OLIMEX/KiCAD/README.md

# KiCAD

Olimex KiCAD components and footprints.

Why these components and footprints are not pushed to the main KiCAD repository? 

Because they are very specific to the technology and assembly process that we use and can't be considered universal and suitable for everyone.

In most of the cases these are duplicate components and packages with those in the standard KiCAD library, plus small edits to fit our goals.

Our component libraries just work fine for our process and are continually updated. These libraries are not static, each time we find new way to optimize our production process for better yield we update the libraries. These libraries are our current libraries that we use when we design our products.

Are there no 3D drawings for the components?

We started adding such, you can find some of those in "OLIMEX_3Dmodels" folder. Notice that we are not very good at mechanics and never found good use of these nice 3D generated objects with KiCAD, so if someone would like to contribute 3D drawings for these components is welcome :)

# NO WARRANTY

THEESE COMPONENT DEFINITIONS AND FOOTPRINTS ARE DISTRIBUTED IN THE HOPE THAT THEY WILL BE USEFUL, BUT WITHOUT ANY WARRANTY. 

THEY ARE PROVIDED "AS IS" WITHOUT WARRANTY OF ANY KIND, EITHER EXPRESSED OR IMPLIED, INCLUDING, BUT NOT LIMITED TO, THE IMPLIED WARRANTIES OF MERCHANTABILITY AND FITNESS FOR A PARTICULAR PURPOSE.

THE ENTIRE RISK AS TO THE QUALITY AND PERFORMANCE OF THE COMPONENTS DEFINITIONS AND FOOTPRINTS IS WITH YOU.

IN NO EVENT OLIMEX WILL BE LIABLE TO YOU FOR DAMAGES, LOSSES, INCLUDING ANY GENERAL, SPECIAL, INCIDENTAL OR CONSEQUENTIAL DAMAGES ARISING OUT OF THE USE OR INABILITY TO USE THESE COMPONENTS DEFINITIONS AND FOOTPRINTS.
