OLIMEX/KiCAD/KiCAD_Footprints/OLIMEX_3Dmodels/B0505S-1W.step

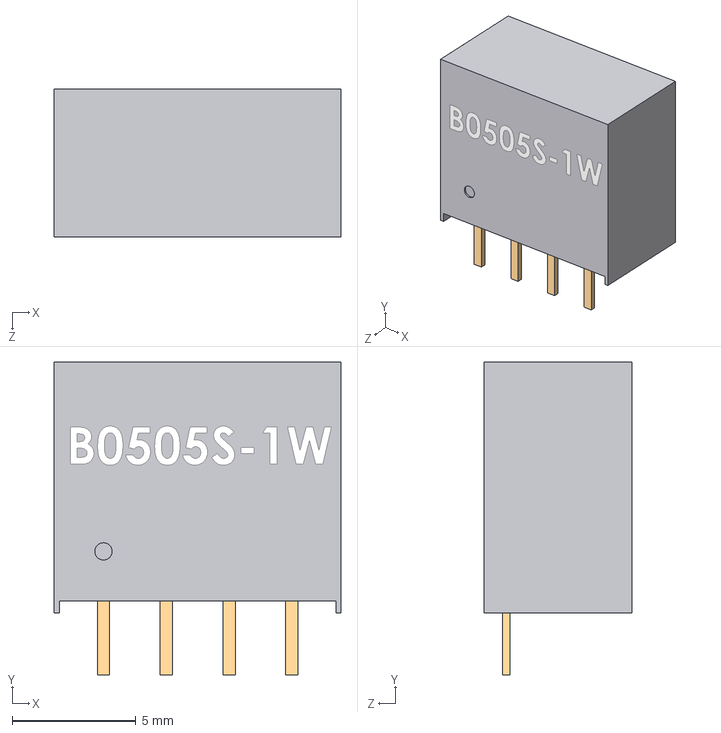
[picture p1: CAD file, 2026-10-12]
KiCAD_Footprints/OLIMEX_3Dmodels/B0505S-1W.step
11.6 x 12.7 x 6.00 mm
