OLIMEX/KiCAD/KiCAD_Footprints/OLIMEX_3Dmodels/TSSOP-10_Body-3x3mm_Pitch-0.5mm.step

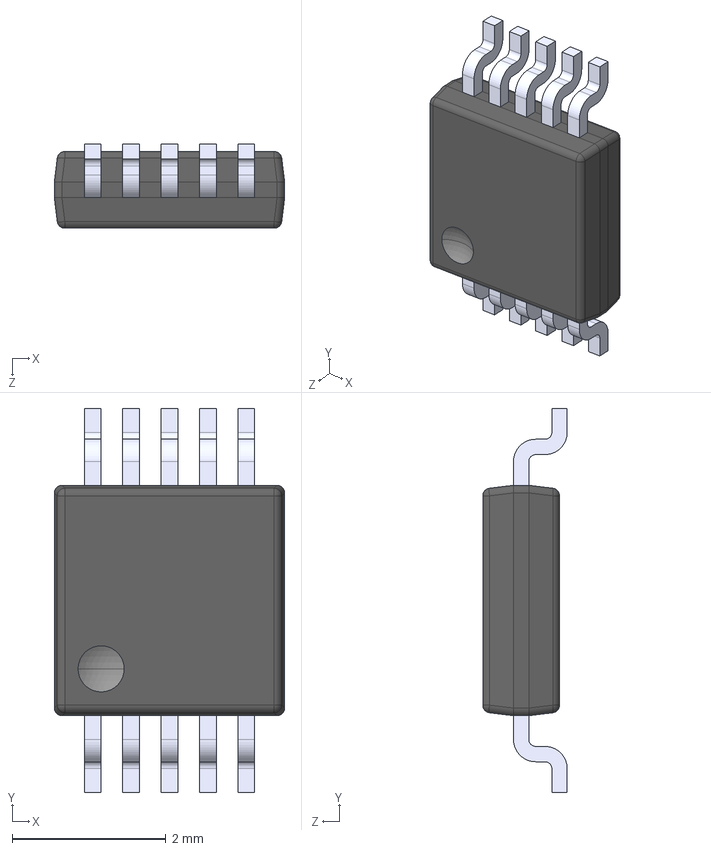
[picture p2: CAD file, 2026-10-12]
KiCAD_Footprints/OLIMEX_3Dmodels/TSSOP-10_Body-3x3mm_Pitch-0.5mm.step
3.00 x 5.00 x 1.10 mm
