OLIMEX/KiCAD/KiCAD_Footprints/OLIMEX_3Dmodels/YSRH8D43---sru1038-330y.step

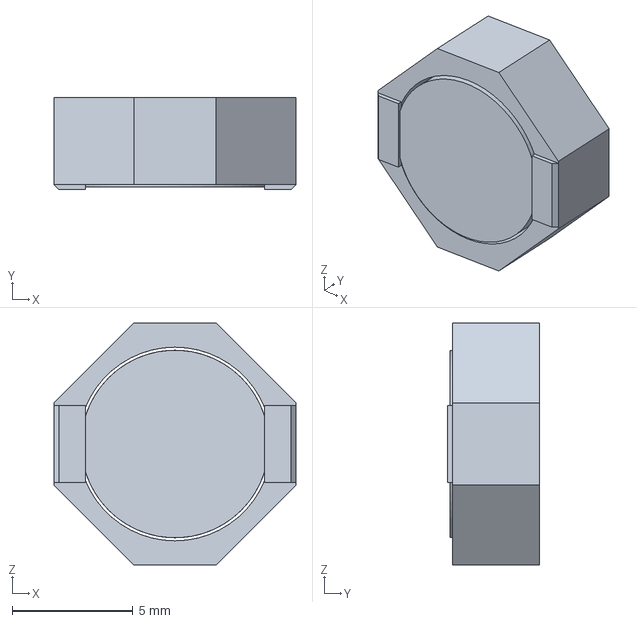
[picture p3: CAD file, 2026-10-12]
KiCAD_Footprints/OLIMEX_3Dmodels/YSRH8D43---sru1038-330y.step
10.0 x 3.80 x 10.0 mm
