OLIMEX/KiCAD/KiCAD_Footprints/OLIMEX_3Dmodels/ITR8307_TR8.STEP

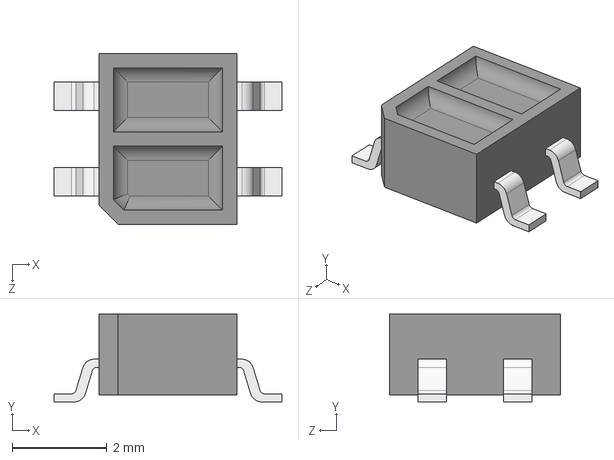
[picture p4: CAD file, 2026-10-12]
KiCAD_Footprints/OLIMEX_3Dmodels/ITR8307_TR8.STEP
4.80 x 1.85 x 3.60 mm
