OLIMEX/KiCAD/KiCAD_Footprints/OLIMEX_3Dmodels/MF-R065_CMF-RL50-0.step

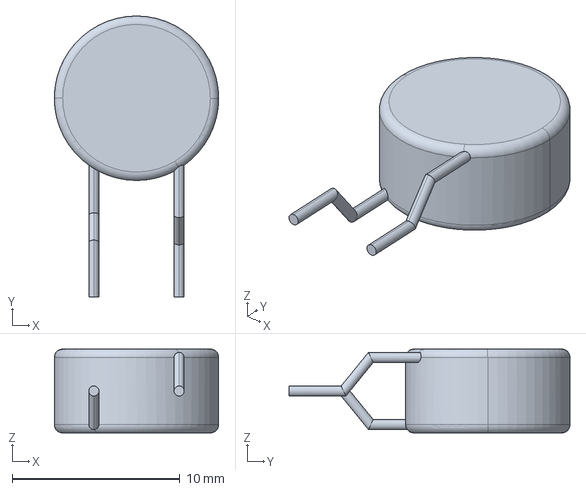
[picture p5: CAD file, 2026-10-12]
KiCAD_Footprints/OLIMEX_3Dmodels/MF-R065_CMF-RL50-0.step
9.80 x 16.7 x 5.00 mm
