OLIMEX/KiCAD/KiCAD_Footprints/OLIMEX_3Dmodels/RJ-055-1.STEP

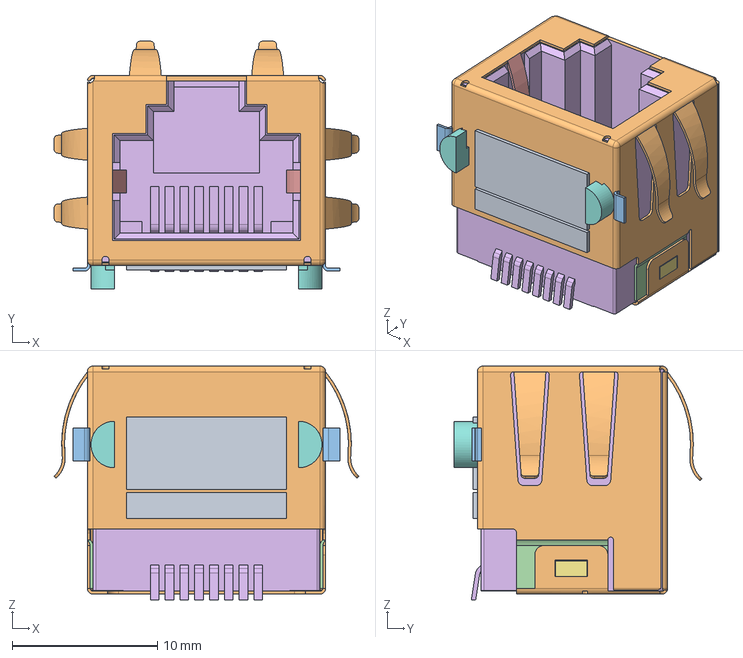
[picture p6: CAD file, 2026-10-12]
KiCAD_Footprints/OLIMEX_3Dmodels/RJ-055-1.STEP
21.0 x 17.1 x 16.1 mm
