OLIMEX/KiCAD/KiCAD_Footprints/OLIMEX_3Dmodels/DFN_3_3x3_3_8_leads.step

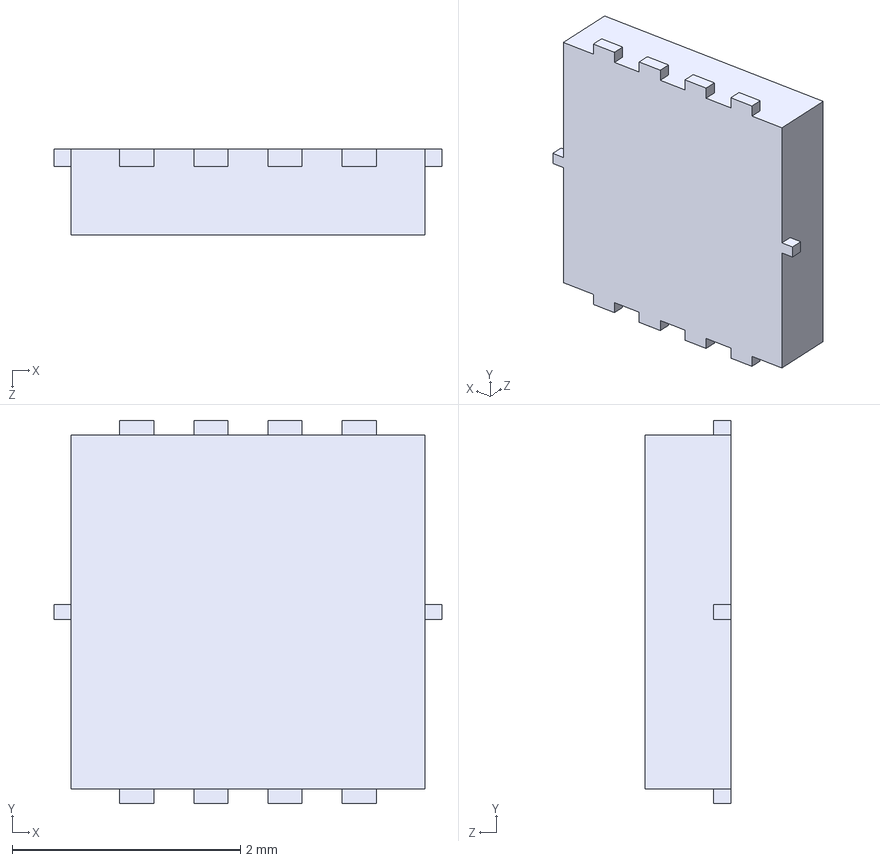
[picture p7: CAD file, 2026-10-12]
KiCAD_Footprints/OLIMEX_3Dmodels/DFN_3_3x3_3_8_leads.step
3.40 x 3.36 x 0.75 mm
