OLIMEX/KiCAD/KiCAD_Footprints/OLIMEX_3Dmodels/SATA-7B-84VSSERIES.step

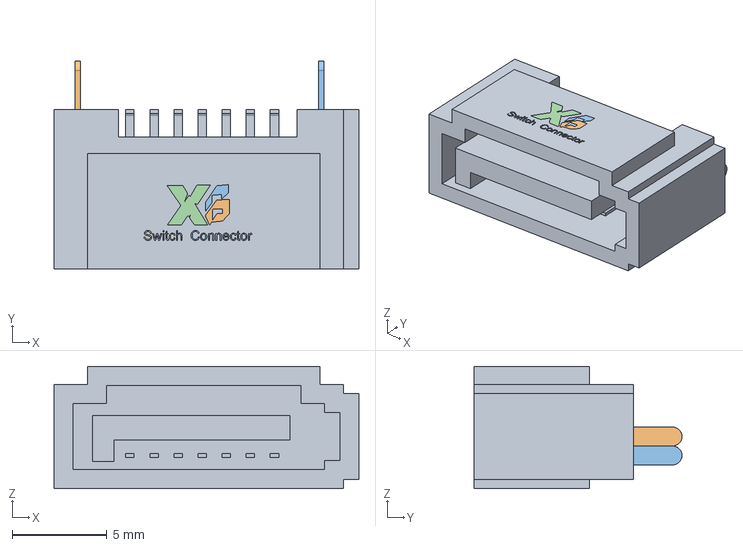
[picture p8: CAD file, 2026-10-12]
KiCAD_Footprints/OLIMEX_3Dmodels/SATA-7B-84VSSERIES.step
16.1 x 11.0 x 6.45 mm
