OLIMEX/KiCAD/KiCAD_Footprints/OLIMEX_3Dmodels/Quectel_EG800K_Series_3D_Dimensions_V1.1.step

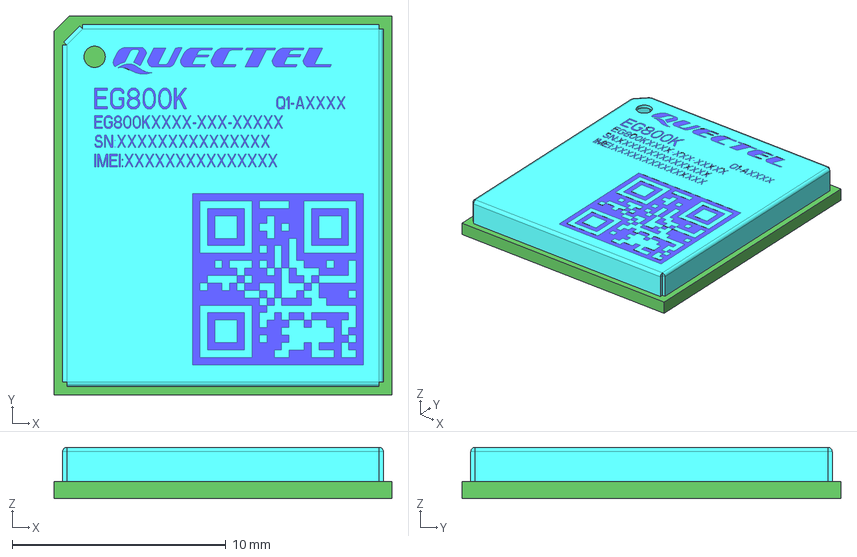
[picture p9: CAD file, 2026-10-12]
KiCAD_Footprints/OLIMEX_3Dmodels/Quectel_EG800K_Series_3D_Dimensions_V1.1.step
15.8 x 17.7 x 2.40 mm
EG800K_PCB
QT0024001848
