OLIMEX/KiCAD/KiCAD_Footprints/OLIMEX_3Dmodels/SOT33-5.step

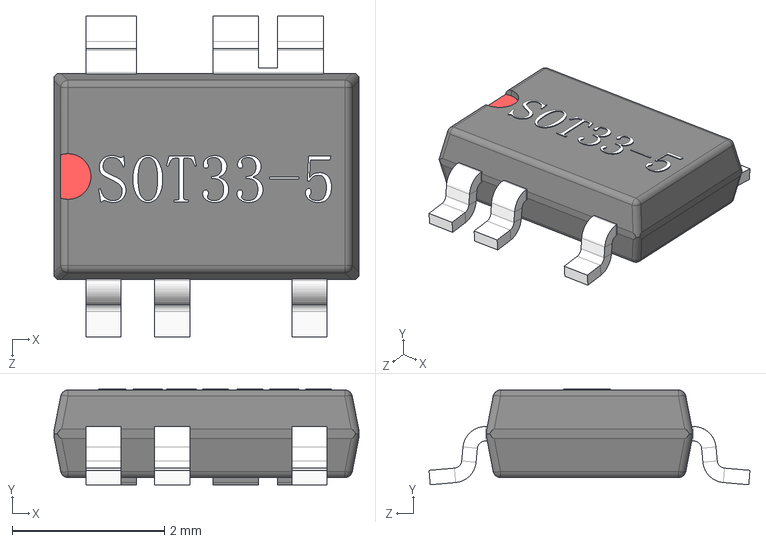
[picture p10: CAD file, 2026-10-12]
KiCAD_Footprints/OLIMEX_3Dmodels/SOT33-5.step
4.00 x 1.25 x 4.22 mm
