OLIMEX/KiCAD/KiCAD_Footprints/OLIMEX_3Dmodels/CARBON FILM RESISTOR.STEP

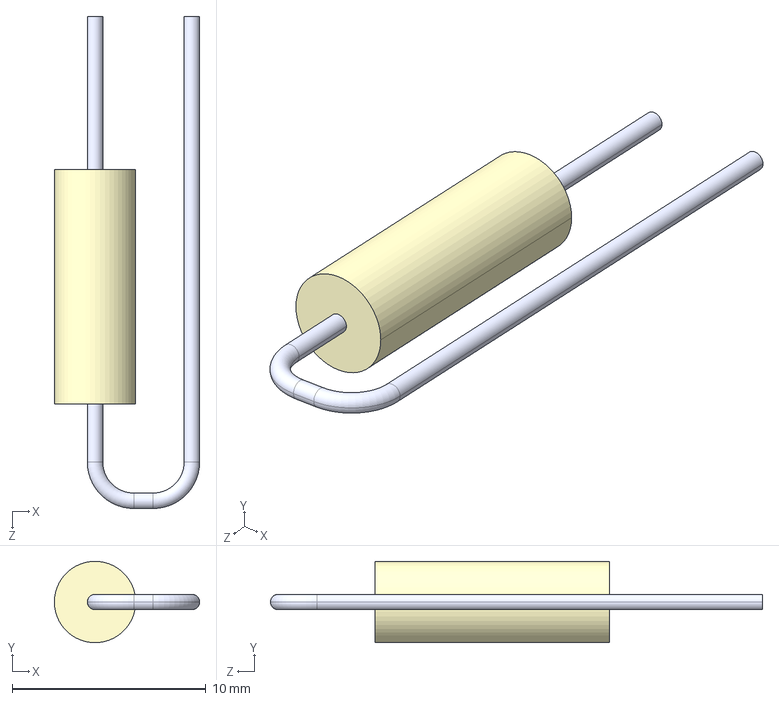
[picture p11: CAD file, 2026-10-12]
KiCAD_Footprints/OLIMEX_3Dmodels/CARBON FILM RESISTOR.STEP
7.50 x 4.20 x 25.4 mm
