OLIMEX/KiCAD/KiCAD_Footprints/OLIMEX_3Dmodels/ESP32-MINI-1-N4.step

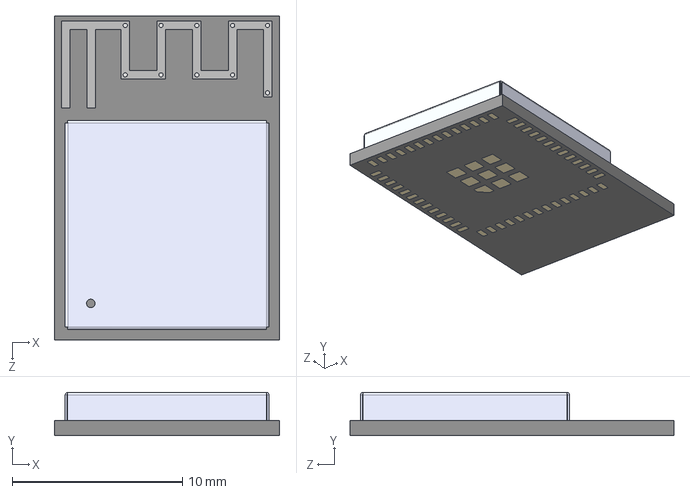
[picture p12: CAD file, 2026-10-12]
KiCAD_Footprints/OLIMEX_3Dmodels/ESP32-MINI-1-N4.step
13.2 x 2.55 x 19.0 mm
