OLIMEX/KiCAD/KiCAD_Footprints/OLIMEX_3Dmodels/B0505S-2WR2.STEP

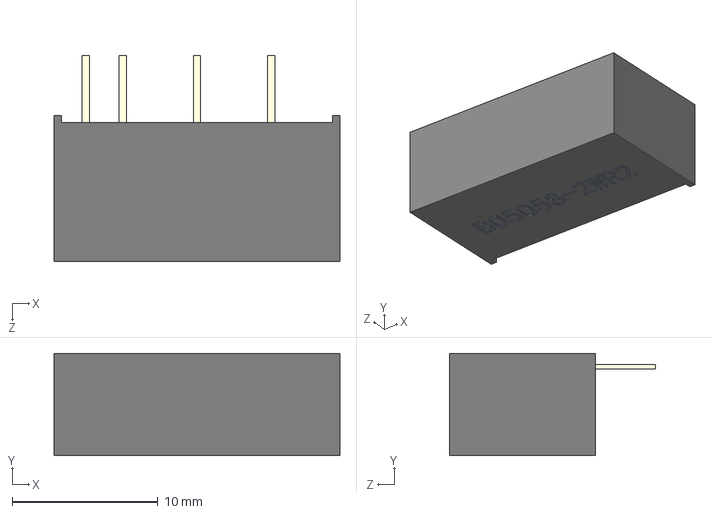
[picture p13: CAD file, 2026-10-12]
KiCAD_Footprints/OLIMEX_3Dmodels/B0505S-2WR2.STEP
19.6 x 7.00 x 14.1 mm
