OLIMEX/KiCAD/KiCAD_Footprints/OLIMEX_3Dmodels/MPM3833CGRH-Z(QFN-18).step

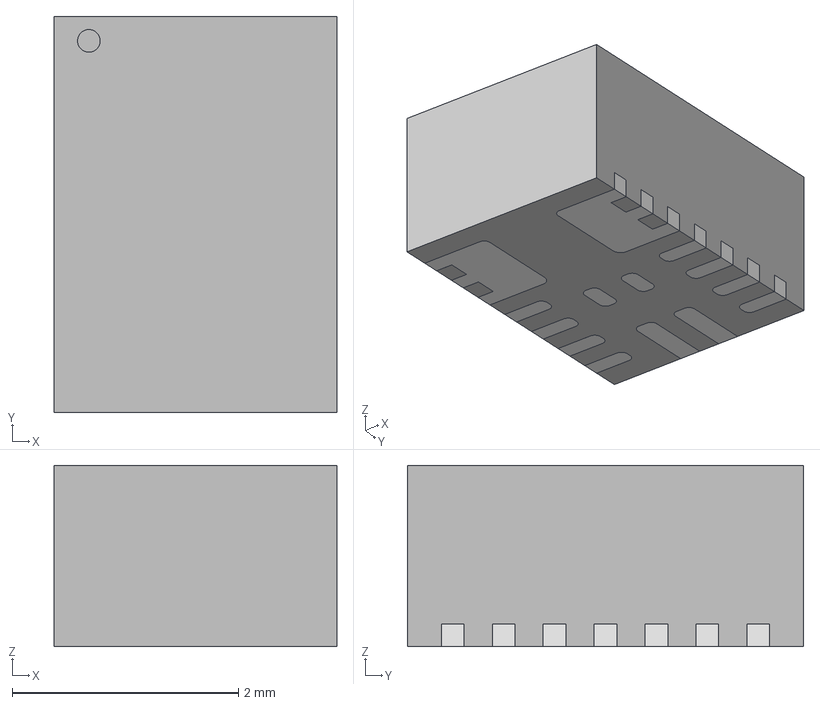
[picture p14: CAD file, 2026-10-12]
KiCAD_Footprints/OLIMEX_3Dmodels/MPM3833CGRH-Z(QFN-18).step
2.50 x 3.50 x 1.60 mm
