OLIMEX/KiCAD/KiCAD_Footprints/OLIMEX_3Dmodels/SO-18W.step

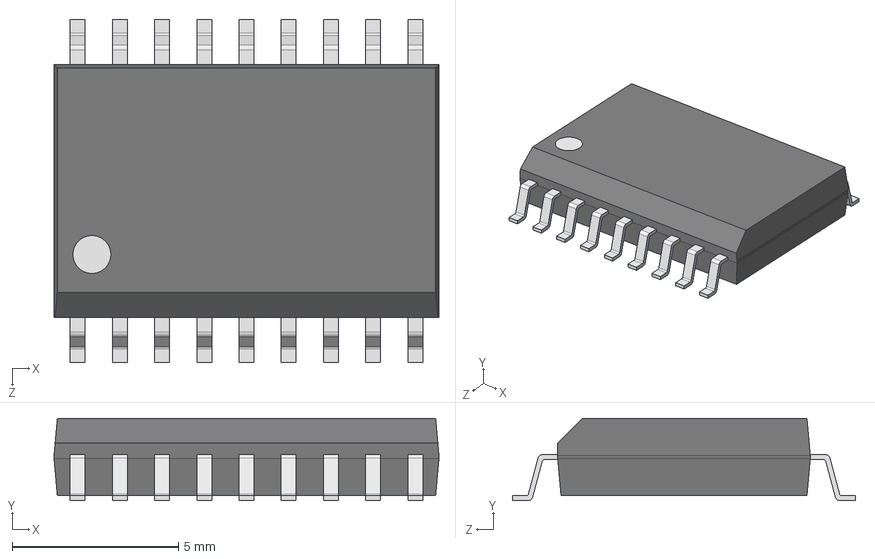
[picture p15: CAD file, 2026-10-12]
KiCAD_Footprints/OLIMEX_3Dmodels/SO-18W.step
11.6 x 2.48 x 10.3 mm
_X2_041A043E0440043F04430441_X0_
_X2_041C04350442043A0430_X0_
_X2_041D043E0436043A0430_X0_ x 9
