OLIMEX/KiCAD/KiCAD_Footprints/OLIMEX_3Dmodels/ESP32-C6-WROOM-1.STEP

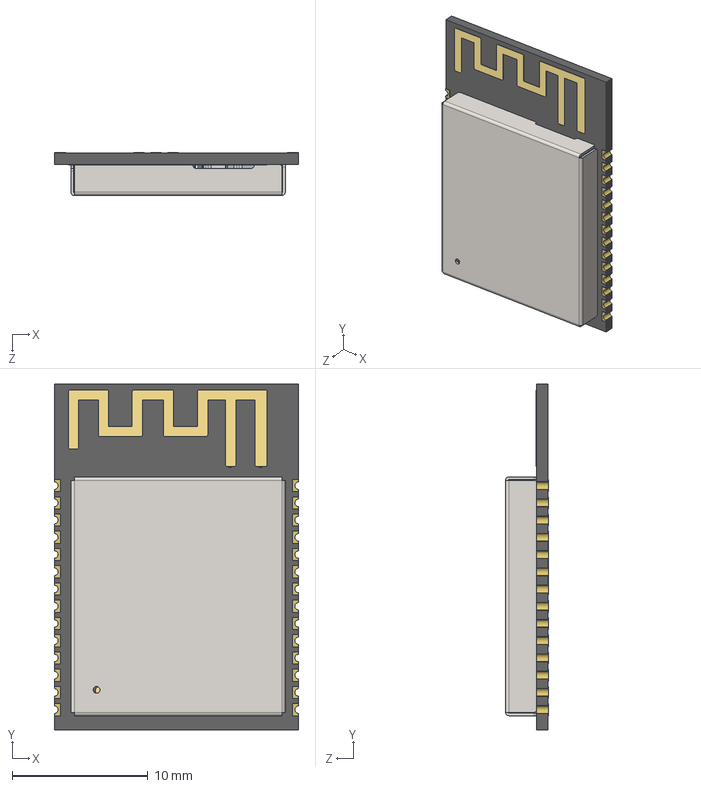
[picture p16: CAD file, 2026-10-12]
KiCAD_Footprints/OLIMEX_3Dmodels/ESP32-C6-WROOM-1.STEP
18.0 x 25.5 x 3.17 mm
uid__2428
MINI-ANT-TYPEB.STEP
R0201_20210301.xtd x 9
ESP32-C6_QFN40_5X5_202306.xtd
XTAL3225_20210301.xtd
SOP8_rev1_20210308.xtd
L0201_20210301.xtd x 2
DFN1006.xtd
C0402_20210301.xtd
C0201_20210301.xtd x 13
Imported
ESP32-WROOM-32D_shielding_case_
