OLIMEX/KiCAD/KiCAD_Footprints/OLIMEX_3Dmodels/Varistor_B72205S0271K101---s05k275e2.step

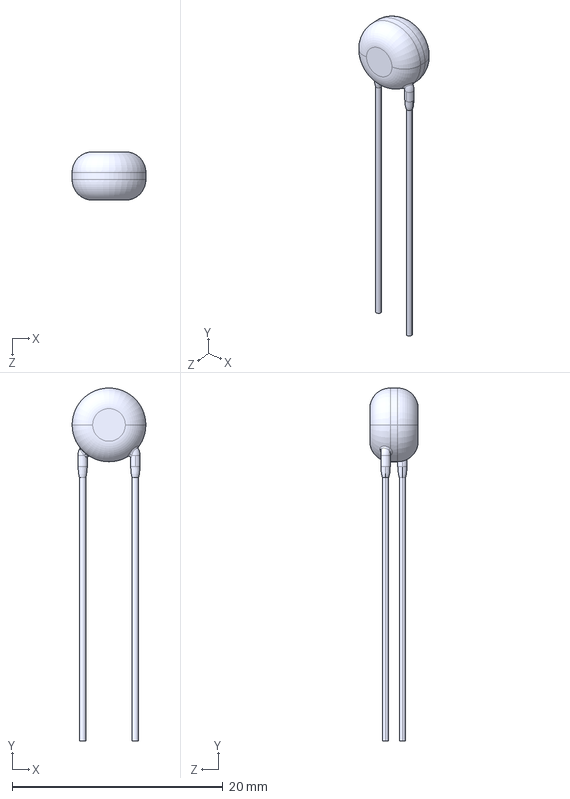
[picture p17: CAD file, 2026-10-12]
KiCAD_Footprints/OLIMEX_3Dmodels/Varistor_B72205S0271K101---s05k275e2.step
7.00 x 33.5 x 4.60 mm
