OLIMEX/KiCAD/KiCAD_Footprints/OLIMEX_3Dmodels/QFN24_4x4.STEP

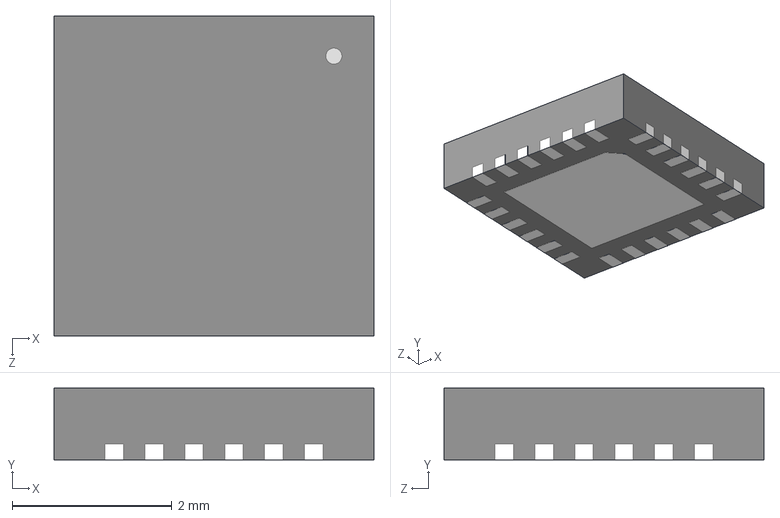
[picture p18: CAD file, 2026-10-12]
KiCAD_Footprints/OLIMEX_3Dmodels/QFN24_4x4.STEP
4.00 x 0.9 x 4.00 mm
