OLIMEX/KiCAD/KiCAD_Footprints/OLIMEX_3Dmodels/ESP32-C6-WROOM-1-N8.step

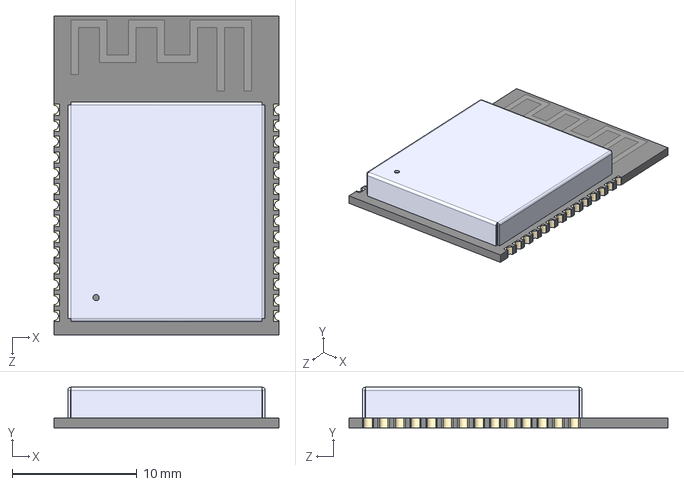
[picture p19: CAD file, 2026-10-12]
KiCAD_Footprints/OLIMEX_3Dmodels/ESP32-C6-WROOM-1-N8.step
18.0 x 3.25 x 25.5 mm
