OLIMEX/KiCAD/KiCAD_Footprints/OLIMEX_3Dmodels/KF7_62 - 4P.step

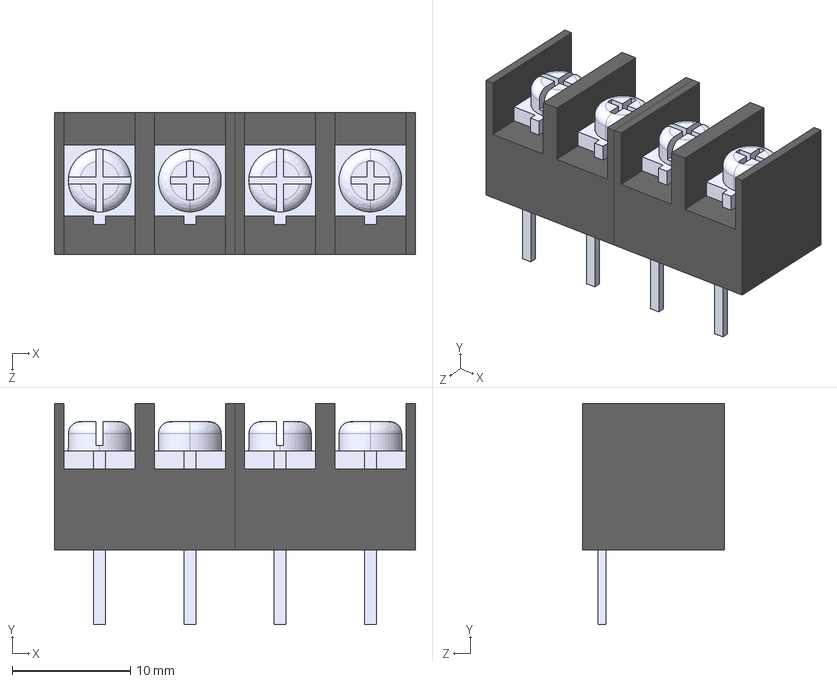
[picture p20: CAD file, 2026-10-12]
KiCAD_Footprints/OLIMEX_3Dmodels/KF7_62 - 4P.step
30.5 x 18.7 x 12.0 mm
User Library-kf7_62-2p x 2
