OLIMEX/KiCAD/KiCAD_Footprints/OLIMEX_3Dmodels/QFN52.STEP

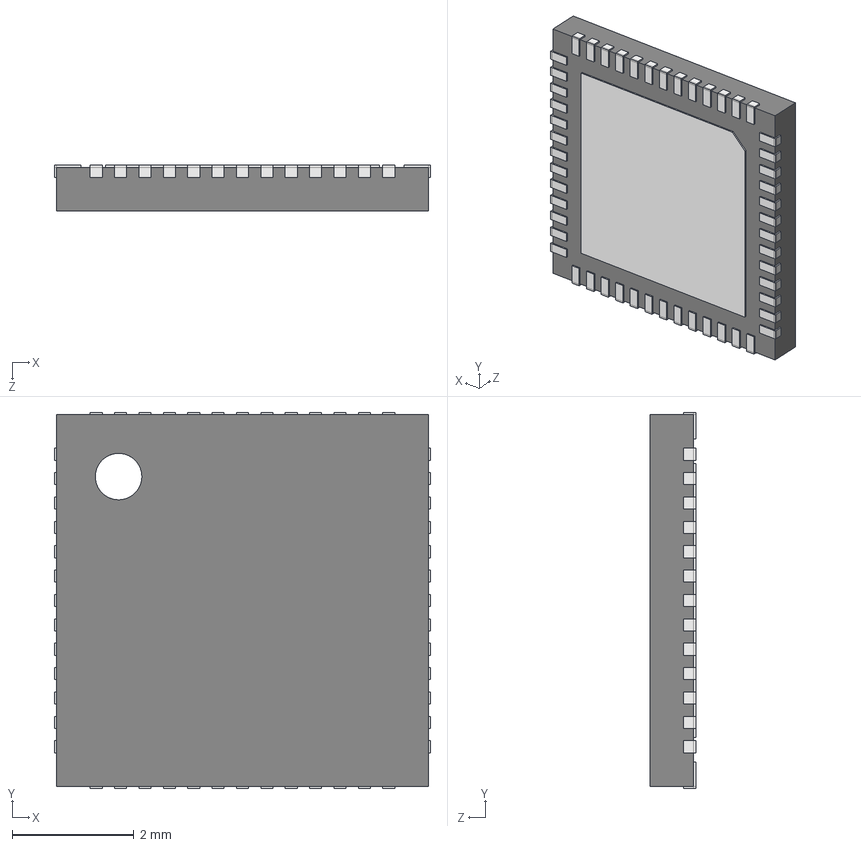
[picture p21: CAD file, 2026-10-12]
KiCAD_Footprints/OLIMEX_3Dmodels/QFN52.STEP
6.17 x 6.17 x 0.75 mm
Open_CASCADE_STEP_translator_6.8_18.2.1.STEP
Open_CASCADE_STEP_translator_6.8_18.4.1.STEP x 52
Open_CASCADE_STEP_translator_6.8_18.1.STEP
Thermal_Shape.STEP
