OLIMEX/KiCAD/KiCAD_Footprints/OLIMEX_3Dmodels/DFN8-2x2.STEP

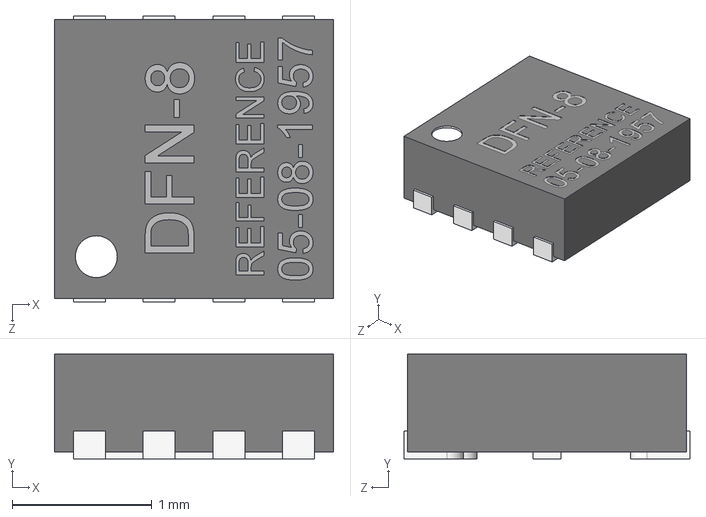
[picture p22: CAD file, 2026-10-12]
KiCAD_Footprints/OLIMEX_3Dmodels/DFN8-2x2.STEP
2.00 x 0.75 x 2.05 mm
