OLIMEX/KiCAD/KiCAD_Footprints/OLIMEX_3Dmodels/LQFP-128.step

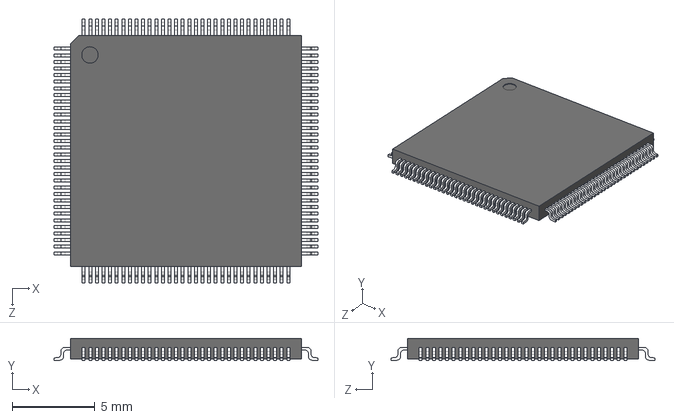
[picture p23: CAD file, 2026-10-12]
KiCAD_Footprints/OLIMEX_3Dmodels/LQFP-128.step
16.0 x 1.35 x 16.0 mm
