OLIMEX/KiCAD/KiCAD_Footprints/OLIMEX_3Dmodels/PN1x16-PinSocket_1x16_P2.54mm_Vertical.step

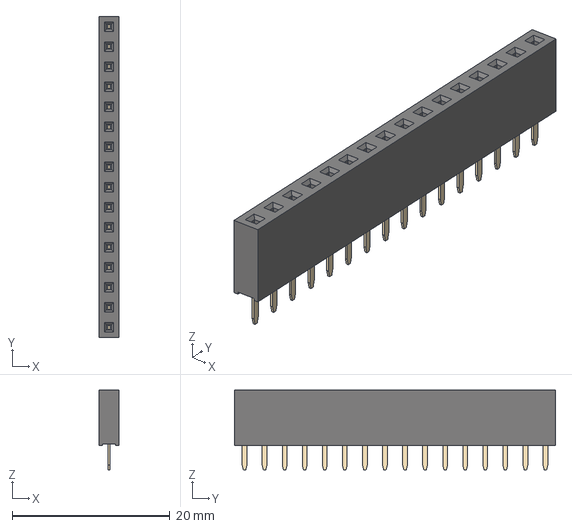
[picture p24: CAD file, 2026-10-12]
KiCAD_Footprints/OLIMEX_3Dmodels/PN1x16-PinSocket_1x16_P2.54mm_Vertical.step
2.54 x 40.6 x 10.1 mm
