OLIMEX/KiCAD/KiCAD_Footprints/OLIMEX_3Dmodels/RA-01H.step

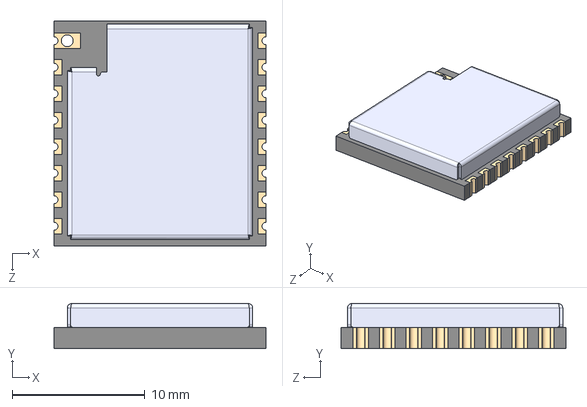
[picture p25: CAD file, 2026-10-12]
KiCAD_Footprints/OLIMEX_3Dmodels/RA-01H.step
16.0 x 3.40 x 17.0 mm
