OLIMEX/KiCAD/KiCAD_Footprints/OLIMEX_3Dmodels/DW02S---CVILUX_CI0102P1VK0.step

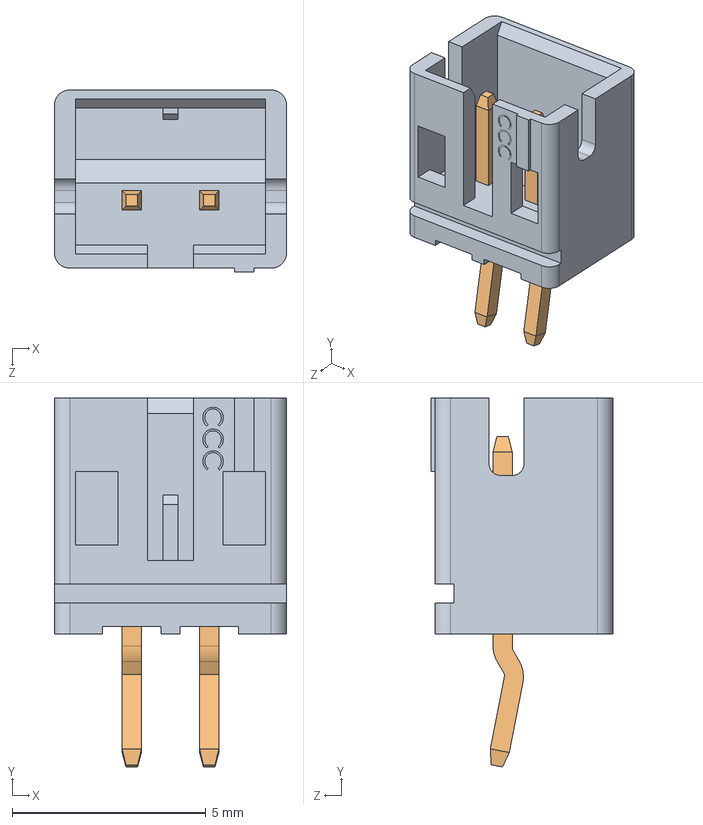
[picture p26: CAD file, 2026-10-12]
KiCAD_Footprints/OLIMEX_3Dmodels/DW02S---CVILUX_CI0102P1VK0.step
6.00 x 9.53 x 4.70 mm
CH01-V-base-2P
CI01 DIP V PIN 單排K x 2
