OLIMEX/KiCAD/KiCAD_Footprints/OLIMEX_3Dmodels/APAN3105.STEP

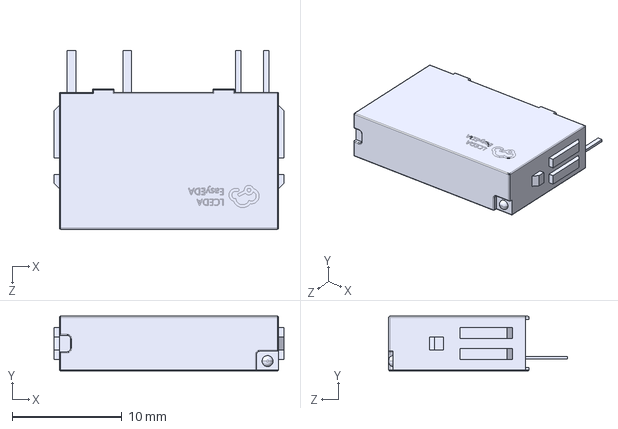
[picture p27: CAD file, 2026-10-12]
KiCAD_Footprints/OLIMEX_3Dmodels/APAN3105.STEP
21.0 x 5.01 x 16.3 mm
