OLIMEX/KiCAD/KiCAD_Footprints/OLIMEX_3Dmodels/TCRT5000L.STEP

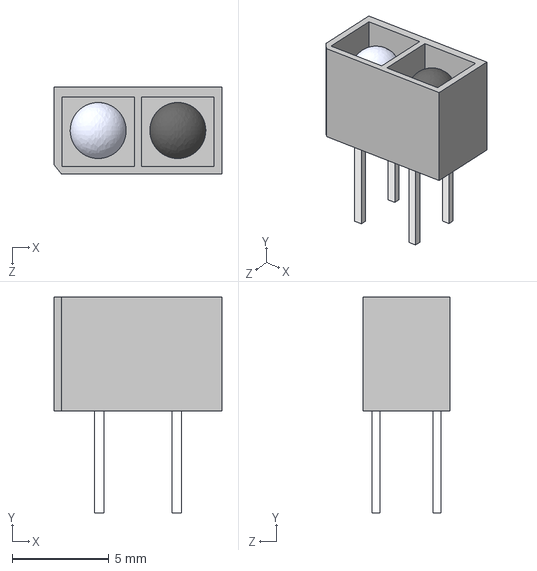
[picture p28: CAD file, 2026-10-12]
KiCAD_Footprints/OLIMEX_3Dmodels/TCRT5000L.STEP
8.70 x 11.2 x 4.50 mm
