OLIMEX/KiCAD/KiCAD_Footprints/OLIMEX_3Dmodels/GBH254SMT-16(B-V-16-LF)(IDC-Header_2x08_P2.54mm_Vertical_SMD).step

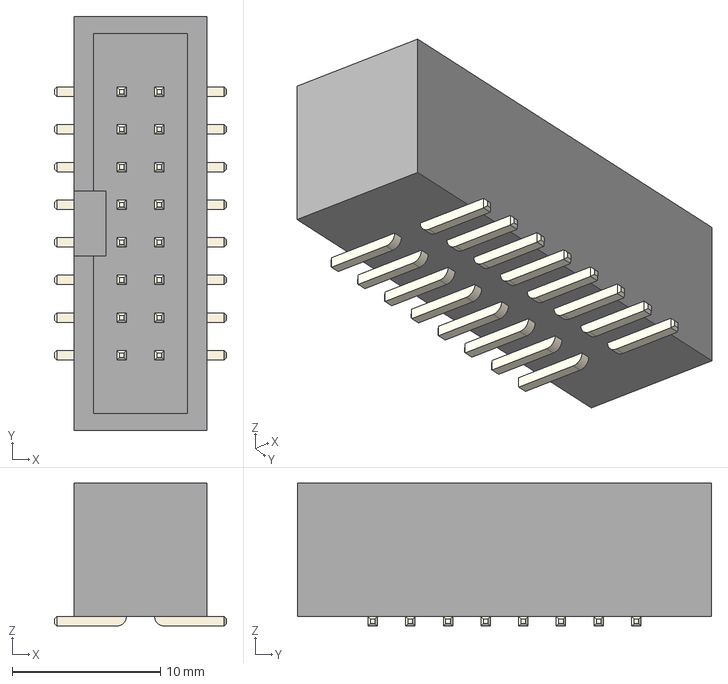
[picture p29: CAD file, 2025-05-28]
KiCAD_Footprints/OLIMEX_3Dmodels/GBH254SMT-16(B-V-16-LF)(IDC-Header_2x08_P2.54mm_Vertical_SMD).step
11.6 x 27.9 x 9.64 mm
