OLIMEX/KiCAD/KiCAD_Footprints/OLIMEX_3Dmodels/User Library-cr2032B.STEP

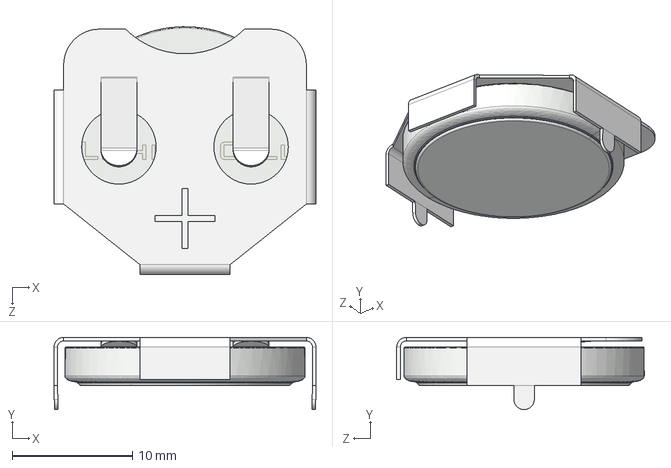
[picture p30: CAD file, 2025-05-28]
KiCAD_Footprints/OLIMEX_3Dmodels/User Library-cr2032B.STEP
21.8 x 6.01 x 20.6 mm
