OLIMEX/KiCAD/KiCAD_Footprints/OLIMEX_3Dmodels/LED-5mm.STEP

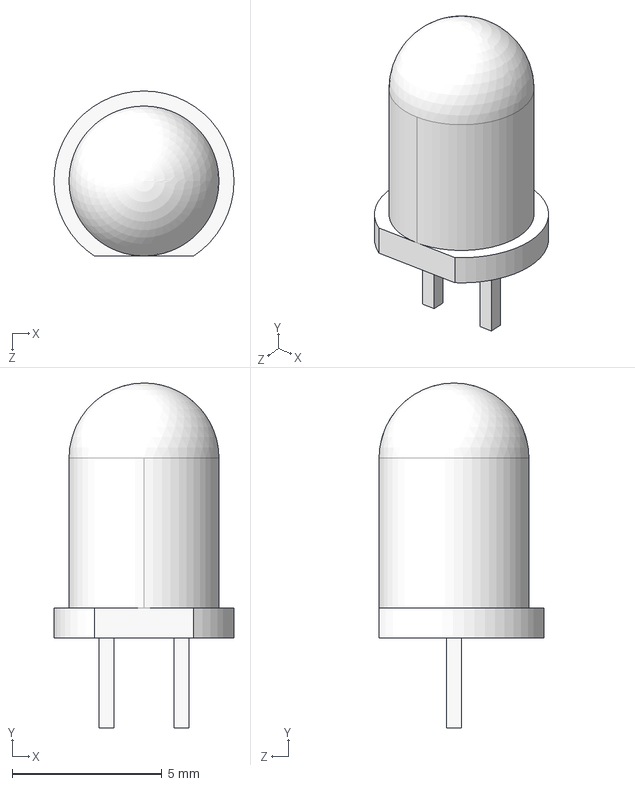
[picture p31: CAD file, 2025-05-28]
KiCAD_Footprints/OLIMEX_3Dmodels/LED-5mm.STEP
6.00 x 11.5 x 5.50 mm
