OLIMEX/KiCAD/KiCAD_Footprints/OLIMEX_3Dmodels/YA-V36P-2X20-LF-Amphenol_ICC(FCI)_20021321-00040T4LF.stp

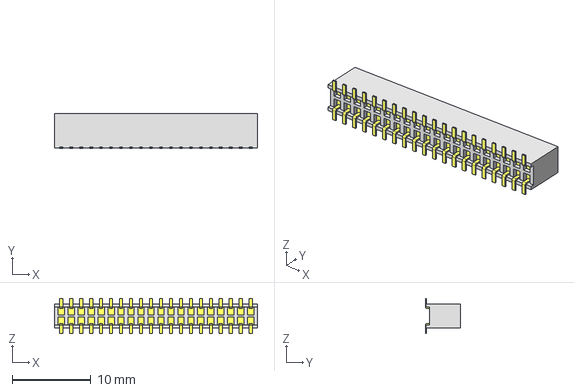
[picture p32: CAD file, 2025-05-28]
KiCAD_Footprints/OLIMEX_3Dmodels/YA-V36P-2X20-LF-Amphenol_ICC(FCI)_20021321-00040T4LF.stp
25.9 x 4.50 x 4.50 mm
_20021321-00040T4LF_body
_20021321-00040T4LF_pins
