OLIMEX/KiCAD/KiCAD_Footprints/OLIMEX_3Dmodels/GBH254SMT-26(B-V-26-LF)(IDC-Header_2x13_P2.54mm_Vertical_SMD).step

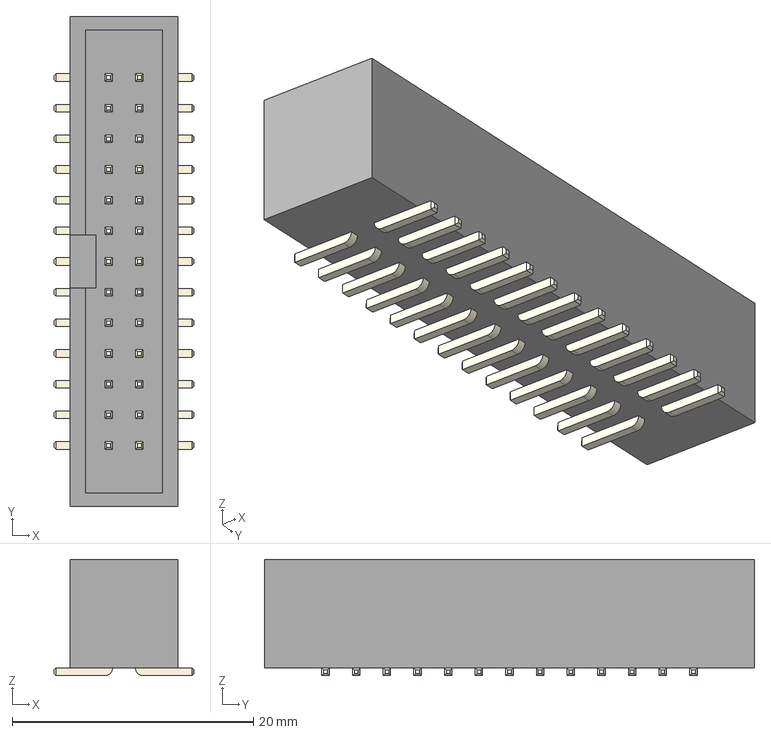
[picture p33: CAD file, 2025-05-28]
KiCAD_Footprints/OLIMEX_3Dmodels/GBH254SMT-26(B-V-26-LF)(IDC-Header_2x13_P2.54mm_Vertical_SMD).step
11.6 x 40.6 x 9.64 mm
