OLIMEX/KiCAD/KiCAD_Footprints/OLIMEX_3Dmodels/GPH254SMT02x15(H-V33X-2X15-LF)_CviLux-CH8130xM100-00-NH.step

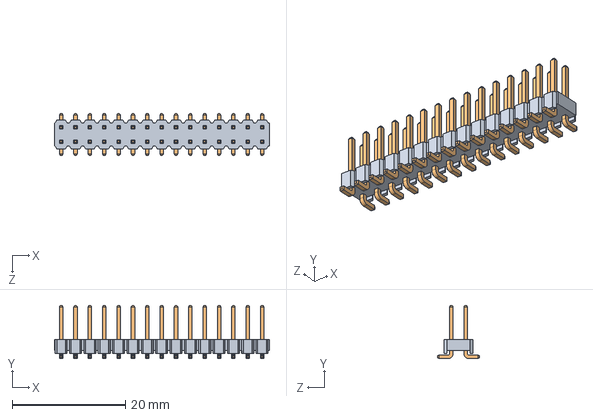
[picture p34: CAD file, 2025-05-28]
KiCAD_Footprints/OLIMEX_3Dmodels/GPH254SMT02x15(H-V33X-2X15-LF)_CviLux-CH8130xM100-00-NH.step
38.0 x 9.40 x 7.40 mm
CH81 BASE xx_30
CH84-M00 x 30
