OLIMEX/KiCAD/KiCAD_Footprints/OLIMEX_3Dmodels/USB4105-GF-A.stp

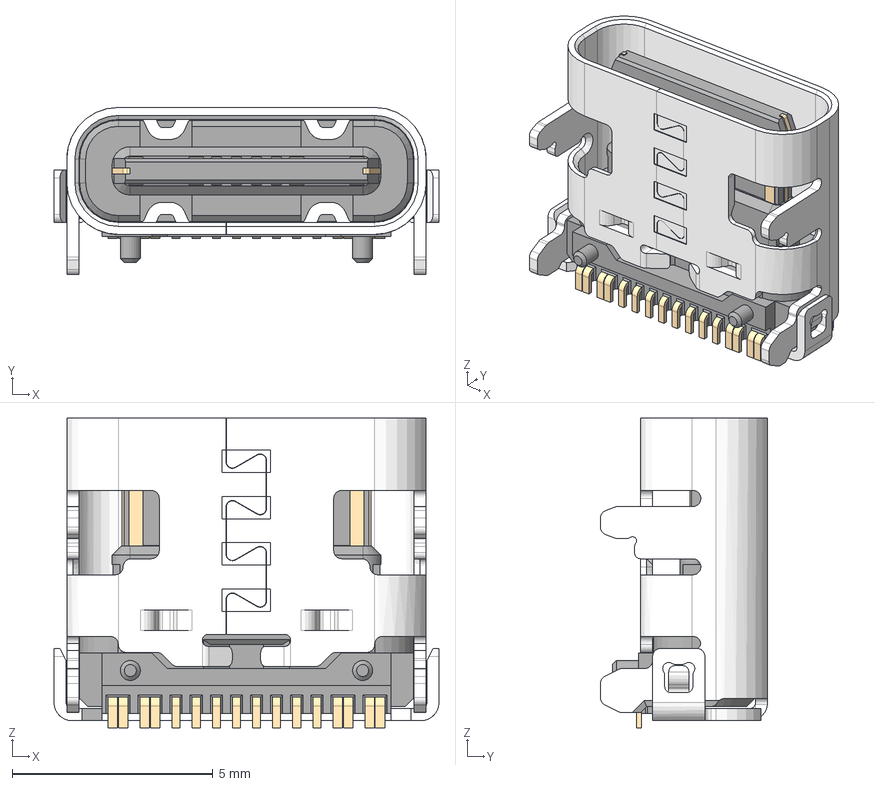
[picture p35: CAD file, 2025-05-28]
KiCAD_Footprints/OLIMEX_3Dmodels/USB4105-GF-A.stp
9.58 x 4.16 x 7.71 mm
ÇÐ³ý-ÀÉì2
