OLIMEX/KiCAD/KiCAD_Footprints/OLIMEX_3Dmodels/VFBGA-80.STEP

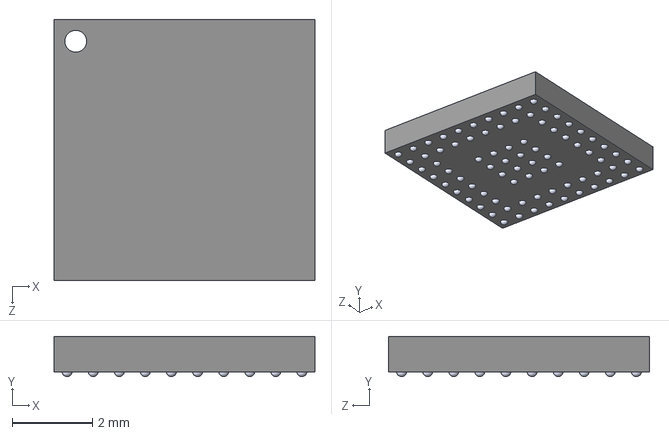
[picture p36: CAD file, 2025-05-28]
KiCAD_Footprints/OLIMEX_3Dmodels/VFBGA-80.STEP
6.50 x 1.00 x 6.50 mm
