OLIMEX/KiCAD/KiCAD_Footprints/OLIMEX_3Dmodels/BH20R_Molex---702472054.stp

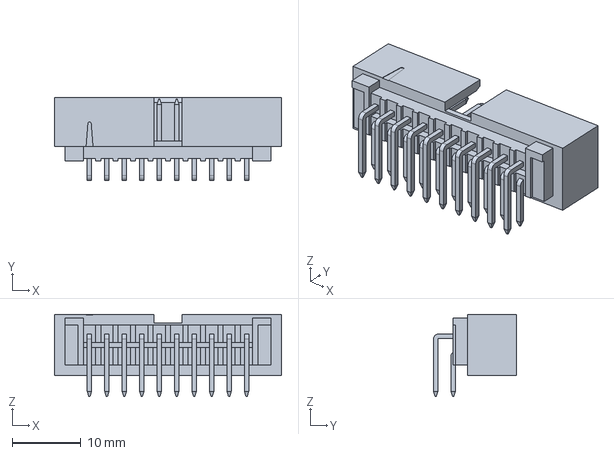
[picture p37: CAD file, 2025-05-28]
KiCAD_Footprints/OLIMEX_3Dmodels/BH20R_Molex---702472054.stp
33.0 x 12.1 x 11.9 mm
