OLIMEX/KiCAD/KiCAD_Footprints/OLIMEX_3Dmodels/TSOP-44_TypeII.step

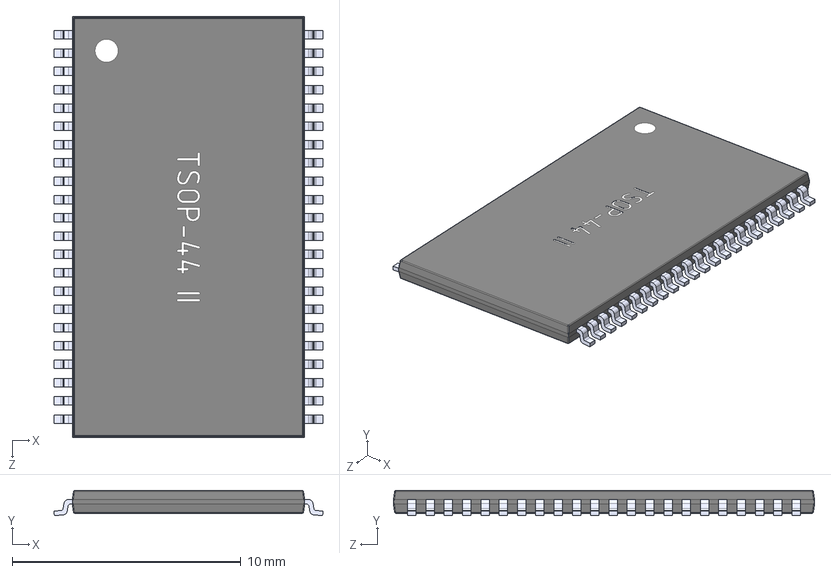
[picture p38: CAD file, 2025-05-28]
KiCAD_Footprints/OLIMEX_3Dmodels/TSOP-44_TypeII.step
11.8 x 1.10 x 18.4 mm
