OLIMEX/KiCAD/KiCAD_Footprints/OLIMEX_3Dmodels/Fuse-Holder_5A_250V-Keystone_Electronics-4527.STEP

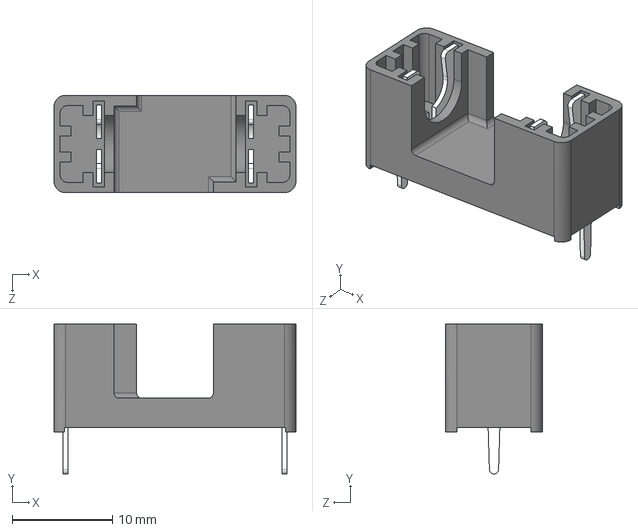
[picture p39: CAD file, 2025-05-28]
KiCAD_Footprints/OLIMEX_3Dmodels/Fuse-Holder_5A_250V-Keystone_Electronics-4527.STEP
24.2 x 15.0 x 9.70 mm
