OLIMEX/KiCAD/KiCAD_Footprints/OLIMEX_3Dmodels/PJ-320D-B.step

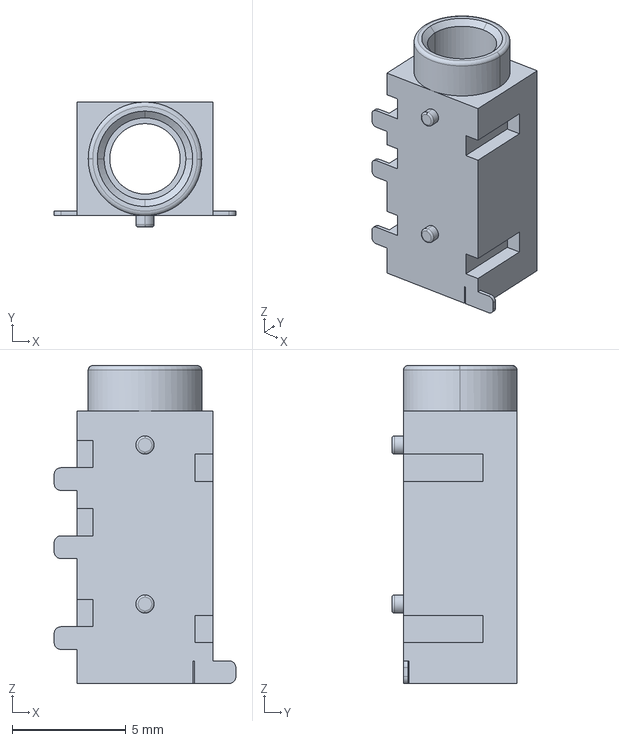
[picture p40: CAD file, 2025-05-28]
KiCAD_Footprints/OLIMEX_3Dmodels/PJ-320D-B.step
8.00 x 5.50 x 14.0 mm
