OLIMEX/KiCAD/KiCAD_Footprints/OLIMEX_3Dmodels/AK8963N.stp

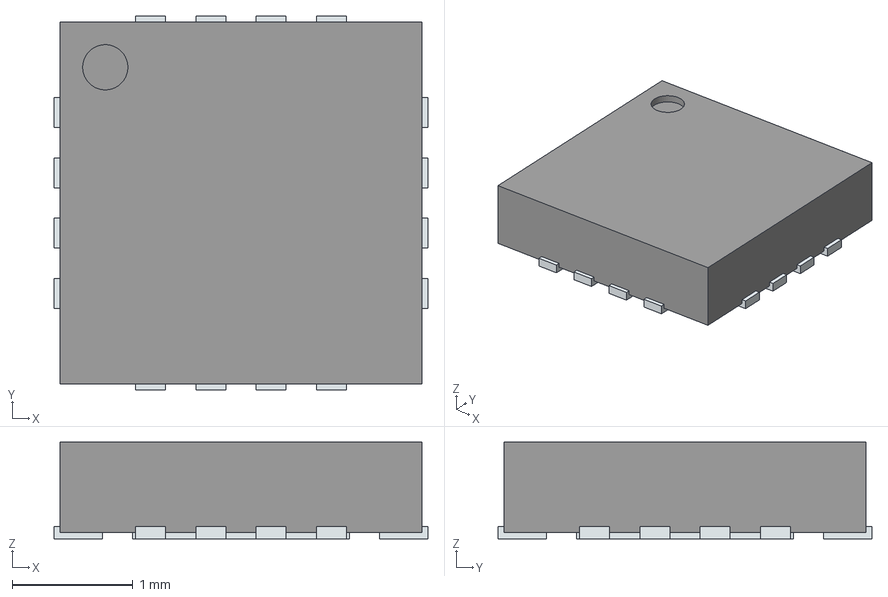
[picture p41: CAD file, 2025-05-28]
KiCAD_Footprints/OLIMEX_3Dmodels/AK8963N.stp
3.10 x 3.10 x 0.8 mm
ThermalPin
PinsArrayLR
PinsArrayTB
