OLIMEX/KiCAD/KiCAD_Footprints/OLIMEX_3Dmodels/B3B-PH-K-S(PH-3A).step

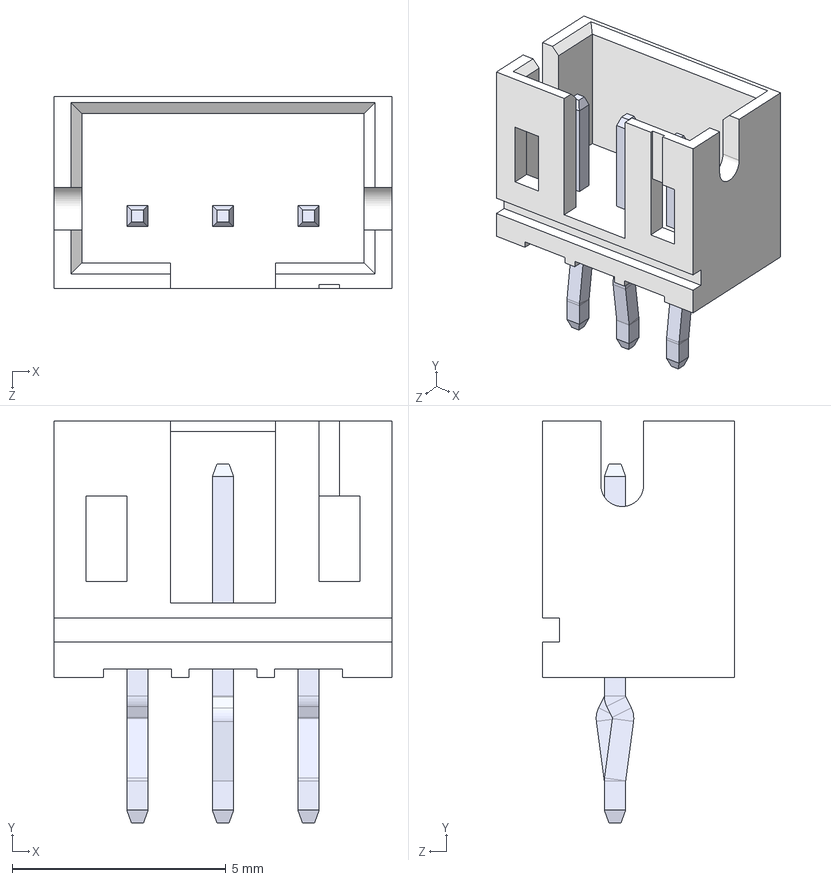
[picture p42: CAD file, 2025-05-28]
KiCAD_Footprints/OLIMEX_3Dmodels/B3B-PH-K-S(PH-3A).step
7.90 x 9.40 x 4.50 mm
