OLIMEX/KiCAD/KiCAD_Footprints/OLIMEX_3Dmodels/DFS.STEP

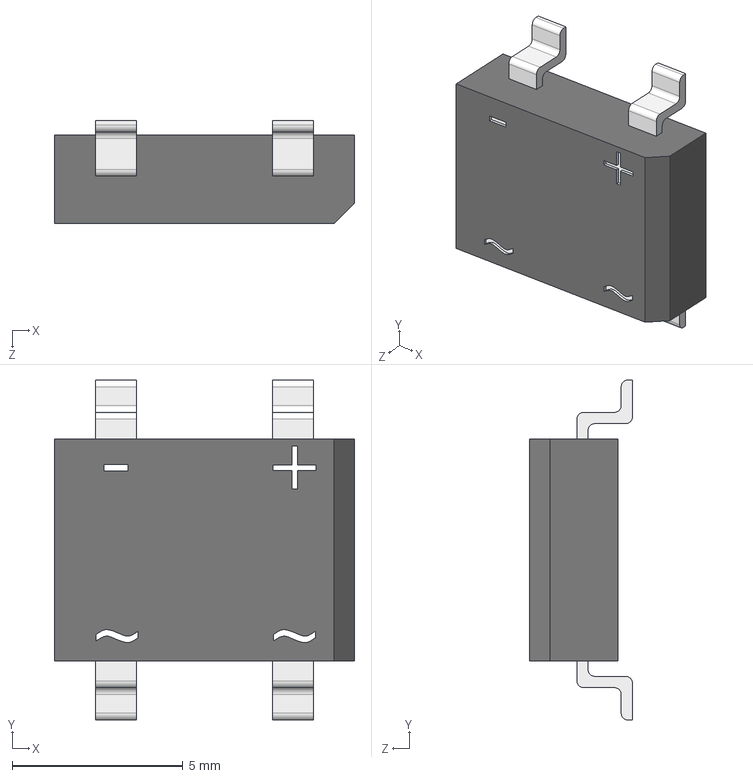
[picture p43: CAD file, 2025-05-28]
KiCAD_Footprints/OLIMEX_3Dmodels/DFS.STEP
8.80 x 9.97 x 3.02 mm
