OLIMEX/KiCAD/KiCAD_Footprints/OLIMEX_3Dmodels/QFN-12_3x3x0_8.step

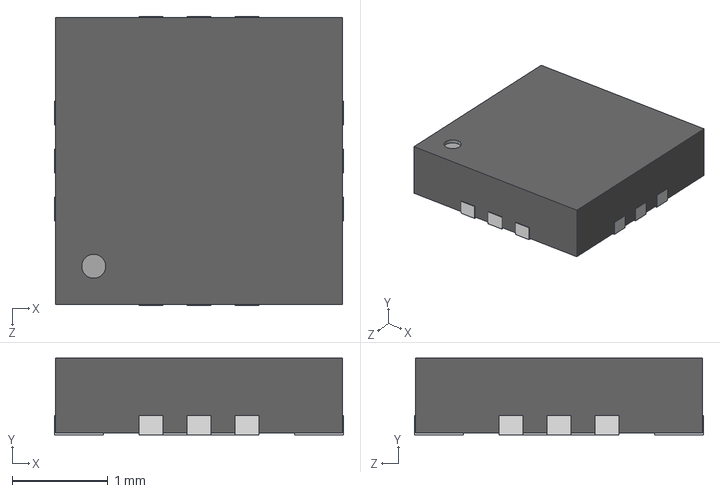
[picture p44: CAD file, 2025-05-28]
KiCAD_Footprints/OLIMEX_3Dmodels/QFN-12_3x3x0_8.step
3.02 x 0.8 x 3.02 mm
