OLIMEX/KiCAD/KiCAD_Footprints/OLIMEX_3Dmodels/1.25T-2AWTP(MOLEX_53261-0271).step

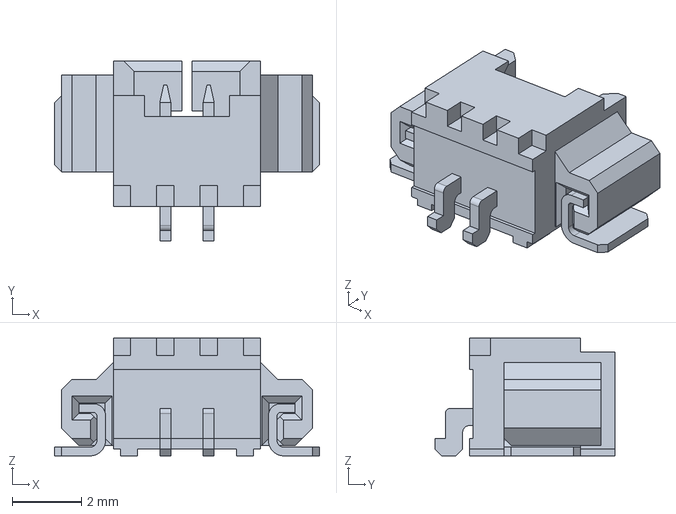
[picture p45: CAD file, 2025-05-28]
KiCAD_Footprints/OLIMEX_3Dmodels/1.25T-2AWTP(MOLEX_53261-0271).step
7.65 x 5.20 x 3.40 mm
