OLIMEX/KiCAD/KiCAD_Footprints/OLIMEX_3Dmodels/cvs-2308.stp

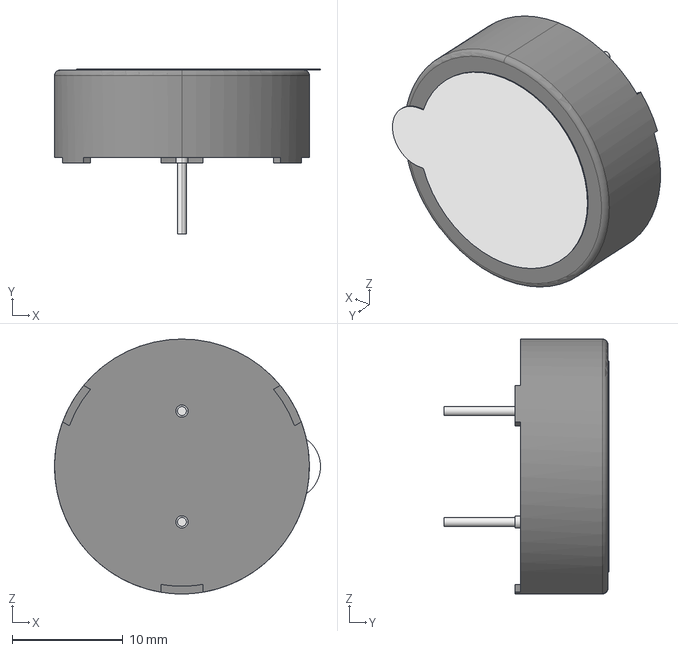
[picture p46: CAD file, 2025-05-28]
KiCAD_Footprints/OLIMEX_3Dmodels/cvs-2308.stp
24.0 x 14.9 x 23.0 mm
