OLIMEX/KiCAD/KiCAD_Footprints/OLIMEX_3Dmodels/USB-Micro_Female---XB-U-E-051N-4BH21.step

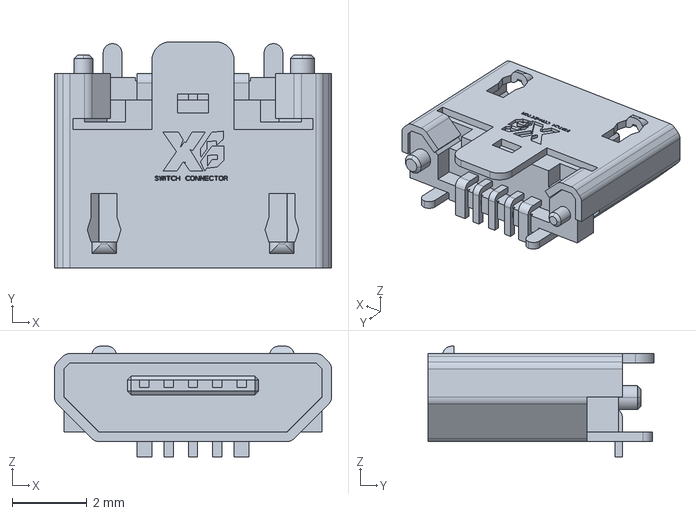
[picture p47: CAD file, 2025-05-28]
KiCAD_Footprints/OLIMEX_3Dmodels/USB-Micro_Female---XB-U-E-051N-4BH21.step
7.40 x 6.05 x 2.96 mm
