OLIMEX/KiCAD/KiCAD_Footprints/OLIMEX_3Dmodels/QFN50P300X300-6x2.step

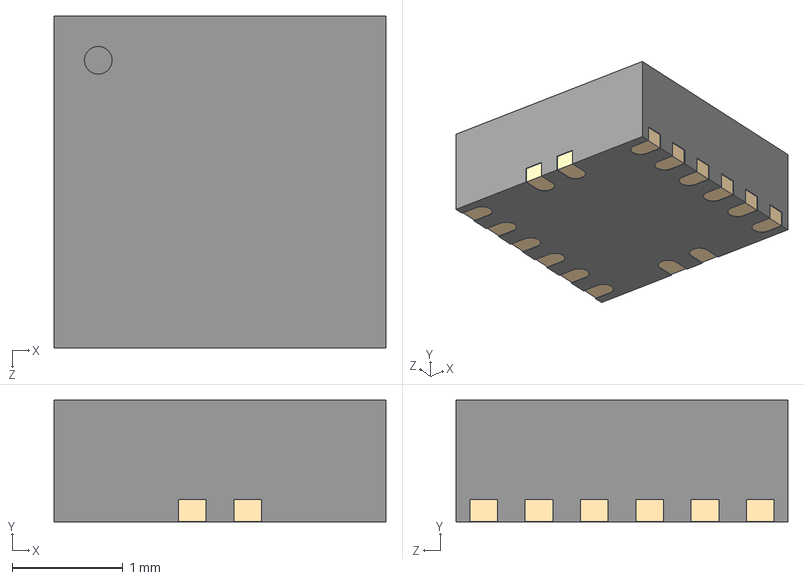
[picture p48: CAD file, 2025-05-28]
KiCAD_Footprints/OLIMEX_3Dmodels/QFN50P300X300-6x2.step
3.00 x 1.10 x 3.00 mm
