OLIMEX/KiCAD/KiCAD_Footprints/OLIMEX_3Dmodels/7Segment_Red_2.step

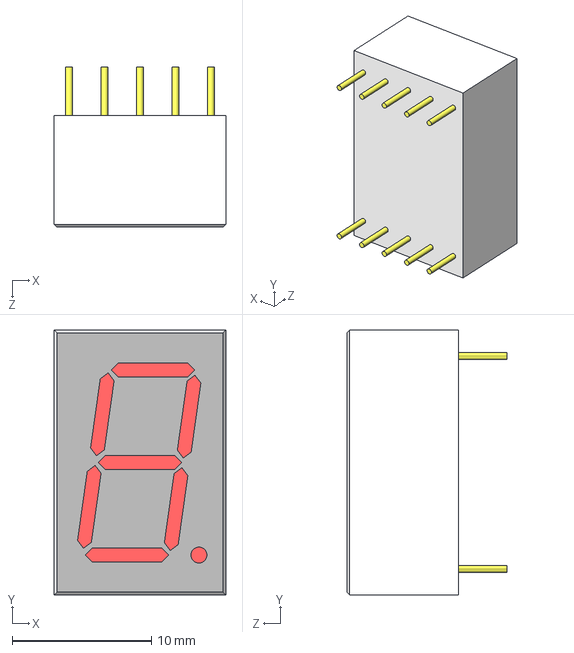
[picture p49: CAD file, 2025-05-28]
KiCAD_Footprints/OLIMEX_3Dmodels/7Segment_Red_2.step
12.3 x 19.0 x 11.5 mm
