OLIMEX/KiCAD/KiCAD_Footprints/OLIMEX_3Dmodels/JD0-0004NL.IGS

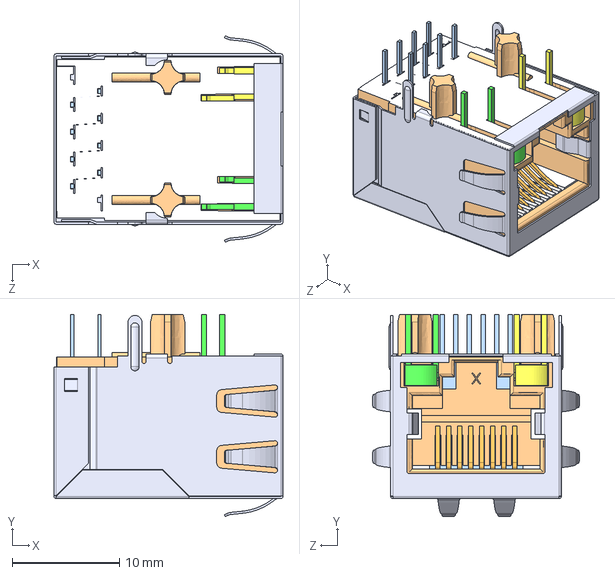
[picture p50: CAD file, 2025-05-28]
KiCAD_Footprints/OLIMEX_3Dmodels/JD0-0004NL.IGS
21.4 x 18.9 x 19.3 mm
