OLIMEX/KiCAD/KiCAD_Footprints/OLIMEX_3Dmodels/FPC-15P-1mm-Right_Angle.step

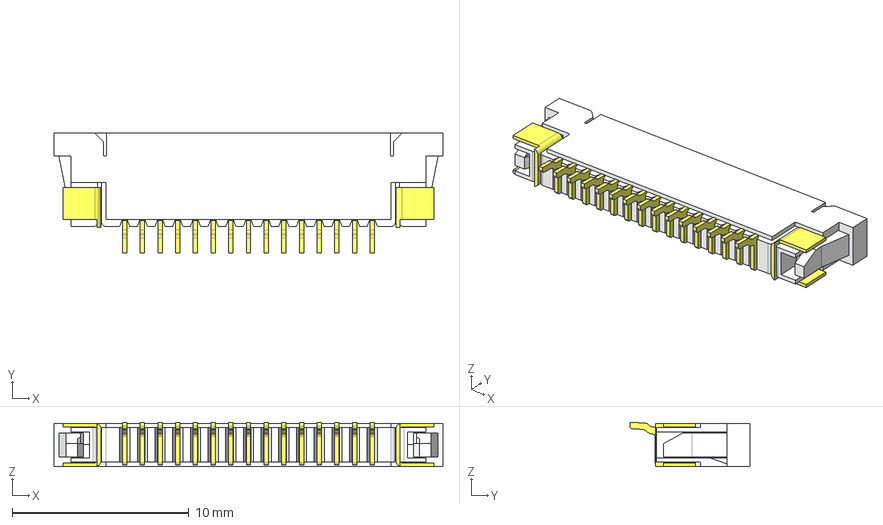
[picture p51: CAD file, 2025-05-28]
KiCAD_Footprints/OLIMEX_3Dmodels/FPC-15P-1mm-Right_Angle.step
22.0 x 6.80 x 2.50 mm
CFCD108- A00615
CFCD108-A006 Terminal x 15
CFCD108-A006 Ground x 2
