OLIMEX/KiCAD/KiCAD_Footprints/OLIMEX_3Dmodels/WS2812S.STEP

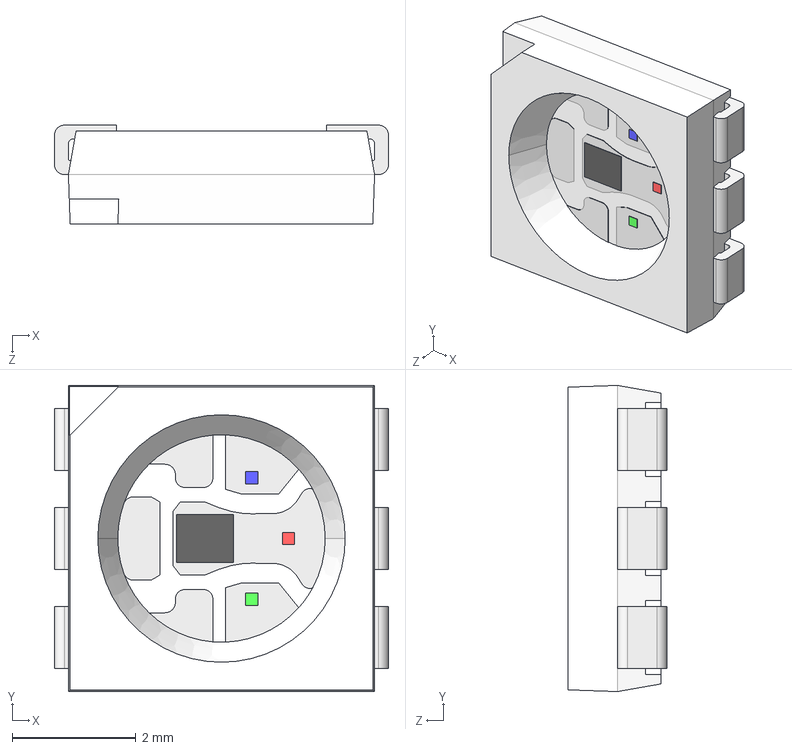
[picture p52: CAD file, 2025-05-28]
KiCAD_Footprints/OLIMEX_3Dmodels/WS2812S.STEP
5.40 x 4.95 x 1.60 mm
