OLIMEX/KiCAD/KiCAD_Footprints/OLIMEX_3Dmodels/TB2-5mm.STEP

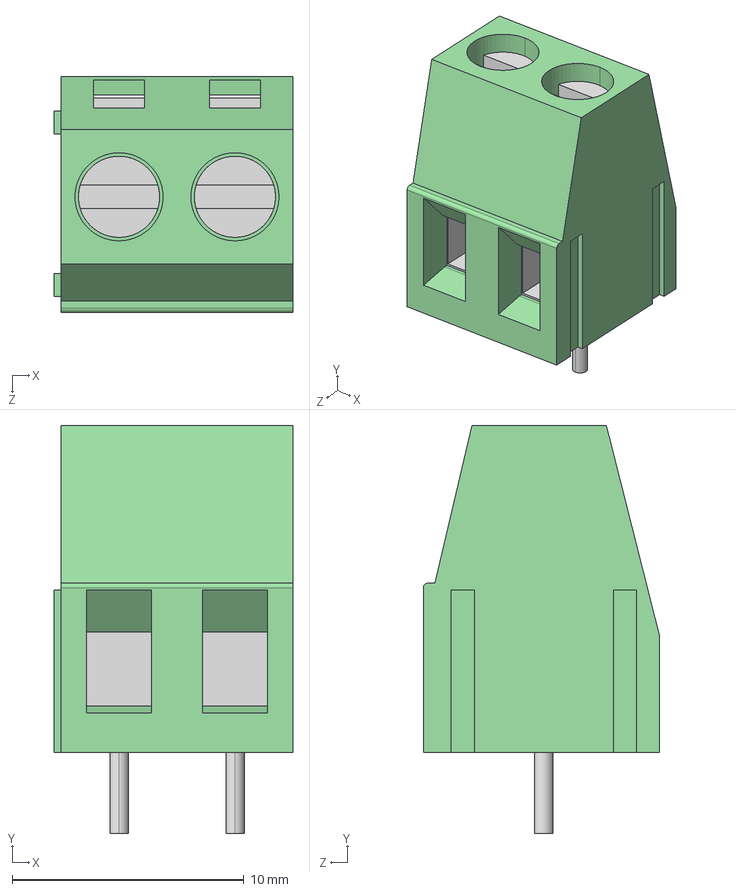
[picture p53: CAD file, 2025-05-28]
KiCAD_Footprints/OLIMEX_3Dmodels/TB2-5mm.STEP
10.3 x 17.6 x 10.2 mm
