OLIMEX/KiCAD/KiCAD_Footprints/OLIMEX_3Dmodels/TE_Connectivity---ENG_CD_2309407-3_3d.stp

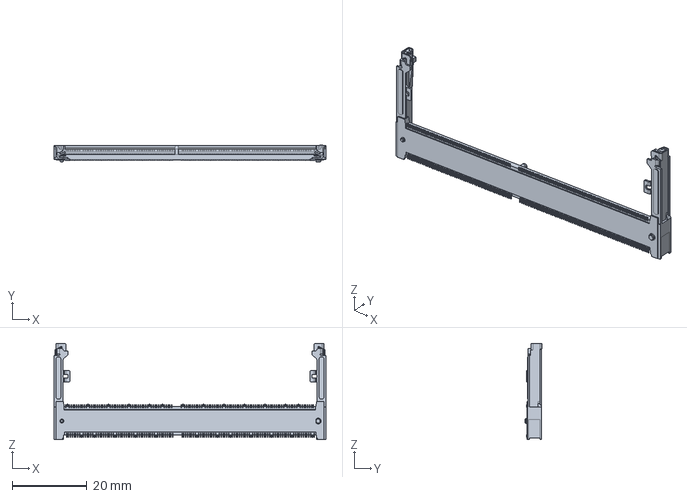
[picture p54: CAD file, 2025-05-28]
KiCAD_Footprints/OLIMEX_3Dmodels/TE_Connectivity---ENG_CD_2309407-3_3d.stp
73.0 x 4.50 x 25.9 mm
