OLIMEX/KiCAD/KiCAD_Footprints/OLIMEX_3Dmodels/User Library-BH10R.STEP

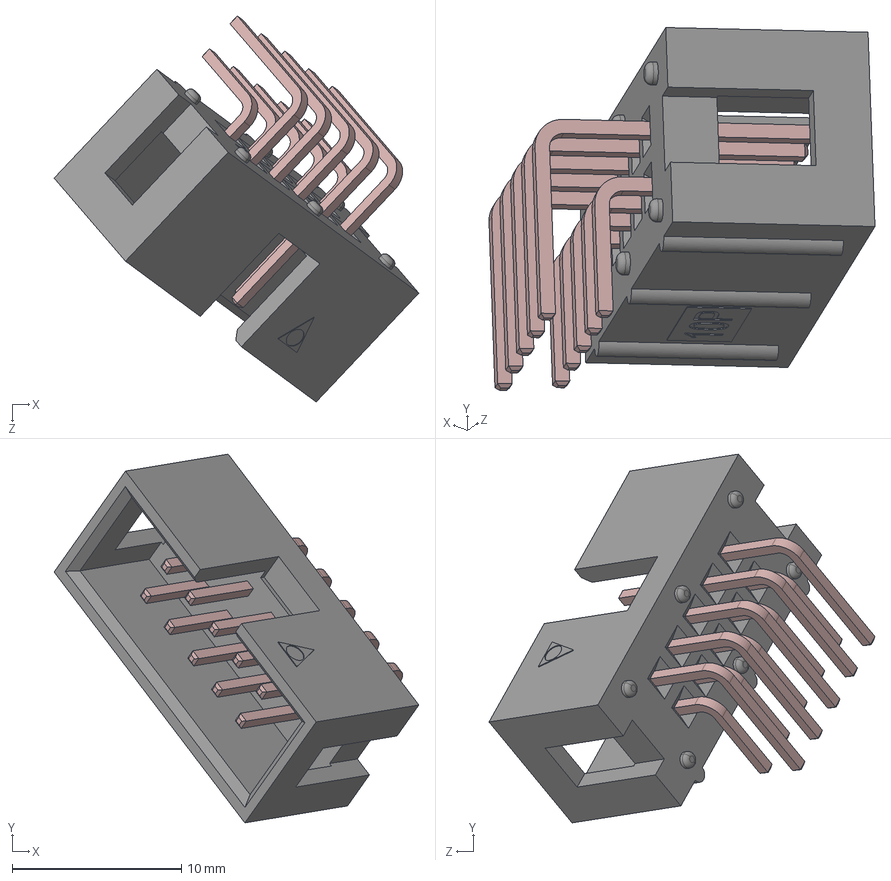
[picture p55: CAD file, 2025-05-28]
KiCAD_Footprints/OLIMEX_3Dmodels/User Library-BH10R.STEP
21.6 x 21.8 x 22.8 mm
pin IDC bigl_По умолчанию x 5
pin IDC small_По умолчанию x 5
User Library-IDC-10MS_Case IDC-10MS_По умолчанию
