OLIMEX/KiCAD/KiCAD_Footprints/OLIMEX_3Dmodels/PQFP-100_Body-20x14mm_Height-3.4mm_Pitch-0.65mm.step

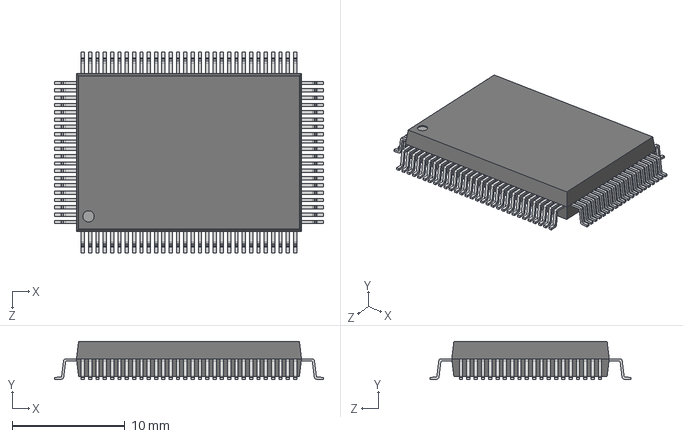
[picture p56: CAD file, 2025-05-28]
KiCAD_Footprints/OLIMEX_3Dmodels/PQFP-100_Body-20x14mm_Height-3.4mm_Pitch-0.65mm.step
23.9 x 3.40 x 17.9 mm
