OLIMEX/KiCAD/KiCAD_Footprints/OLIMEX_3Dmodels/SLIDE_SWITCH_DM-04V.step

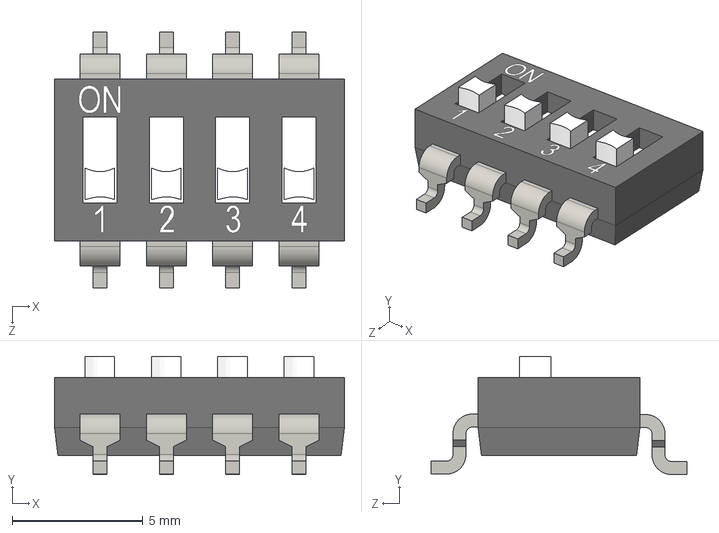
[picture p57: CAD file, 2025-05-28]
KiCAD_Footprints/OLIMEX_3Dmodels/SLIDE_SWITCH_DM-04V.step
11.1 x 4.52 x 9.78 mm
