OLIMEX/KiCAD/KiCAD_Footprints/OLIMEX_3Dmodels/User Library-tbu-ca-1.STEP

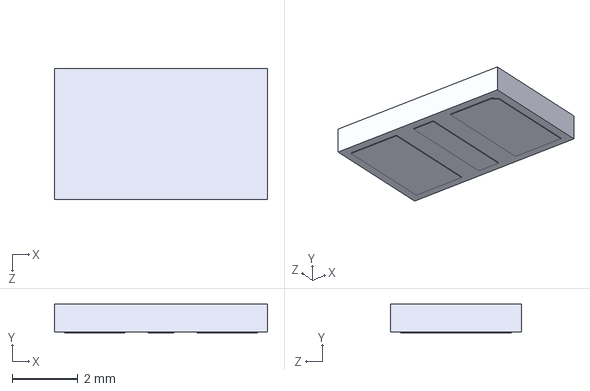
[picture p58: CAD file, 2025-05-28]
KiCAD_Footprints/OLIMEX_3Dmodels/User Library-tbu-ca-1.STEP
6.50 x 0.875 x 4.00 mm
