OLIMEX/KiCAD/KiCAD_Footprints/OLIMEX_3Dmodels/L_HSMRH129---WE12x12x10.step

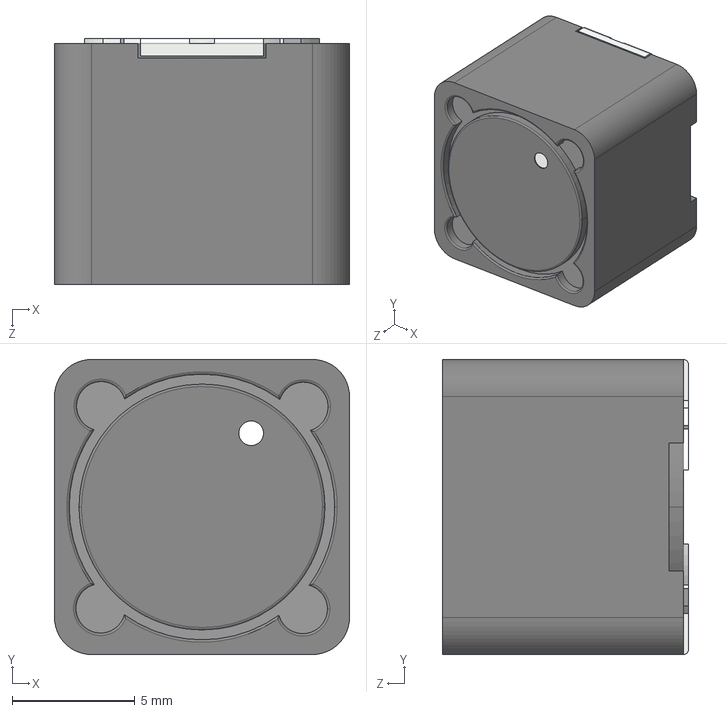
[picture p59: CAD file, 2025-05-28]
KiCAD_Footprints/OLIMEX_3Dmodels/L_HSMRH129---WE12x12x10.step
12.0 x 12.0 x 10.0 mm
