OLIMEX/KiCAD/KiCAD_Footprints/OLIMEX_3Dmodels/User Library-Res_Normal (0_25W).STEP

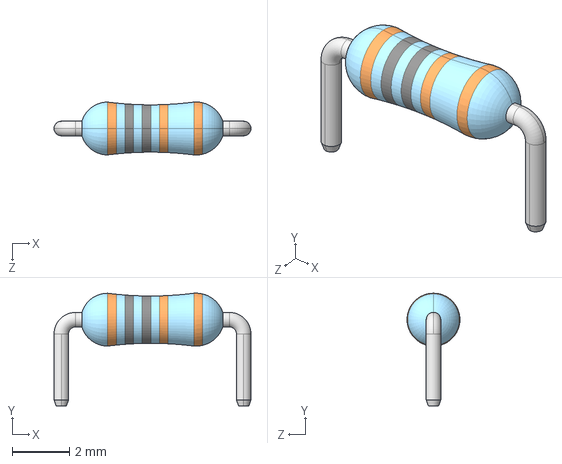
[picture p60: CAD file, 2025-05-28]
KiCAD_Footprints/OLIMEX_3Dmodels/User Library-Res_Normal (0_25W).STEP
6.86 x 3.92 x 1.84 mm
