OLIMEX/KiCAD/KiCAD_Footprints/OLIMEX_3Dmodels/QFN-28_UFD_4x5mm_P0.5mm.step

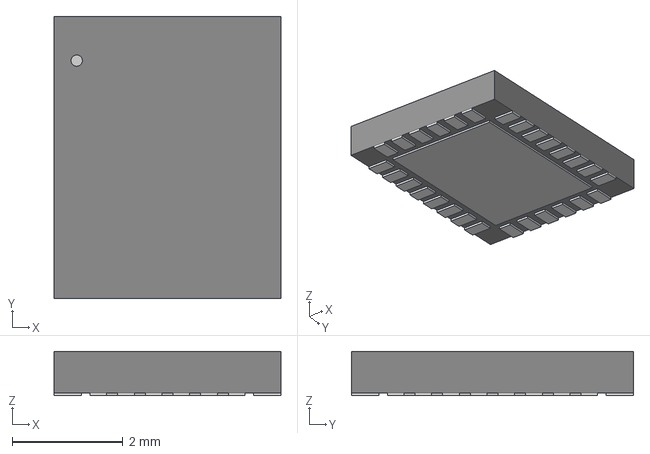
[picture p61: CAD file, 2025-05-28]
KiCAD_Footprints/OLIMEX_3Dmodels/QFN-28_UFD_4x5mm_P0.5mm.step
4.10 x 5.10 x 0.803 mm
