OLIMEX/KiCAD/KiCAD_Footprints/OLIMEX_3Dmodels/PS2_MDR6_MINI-DIN(5750071-1).stp

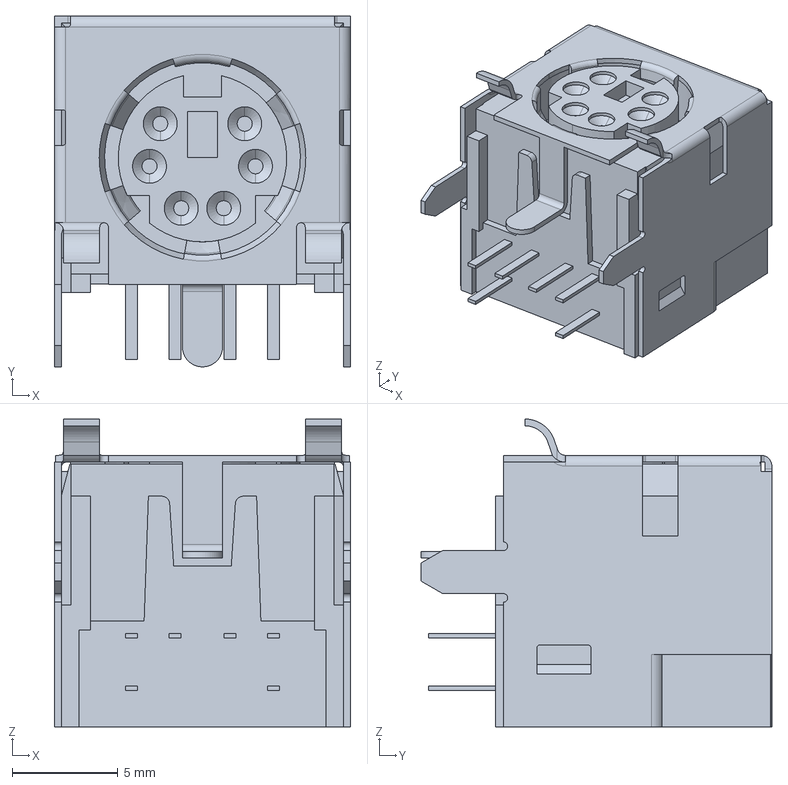
[picture p62: CAD file, 2025-05-28]
KiCAD_Footprints/OLIMEX_3Dmodels/PS2_MDR6_MINI-DIN(5750071-1).stp
14.0 x 16.6 x 14.5 mm
