OLIMEX/KiCAD/KiCAD_Footprints/OLIMEX_3Dmodels/IDC10S-PCB_CB94102V100.STEP

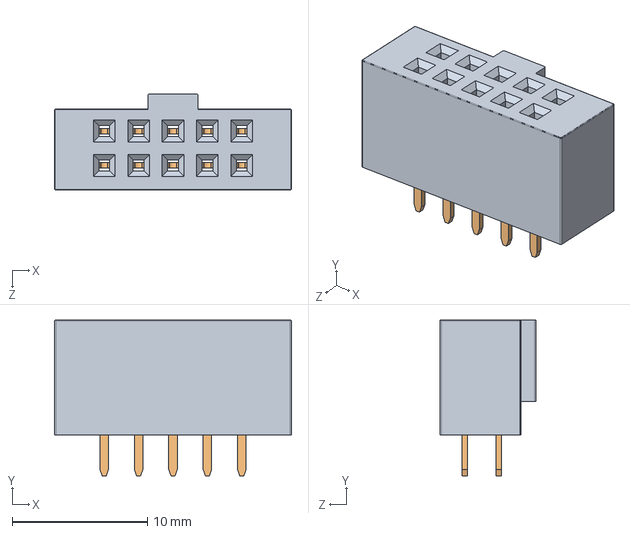
[picture p63: CAD file, 2025-05-28]
KiCAD_Footprints/OLIMEX_3Dmodels/IDC10S-PCB_CB94102V100.STEP
17.5 x 11.5 x 7.10 mm
cb94 BASE_10
cb94-t x 10
