OLIMEX/KiCAD/KiCAD_Footprints/OLIMEX_3Dmodels/USB-A_Male---U217-041N-4BV81.step

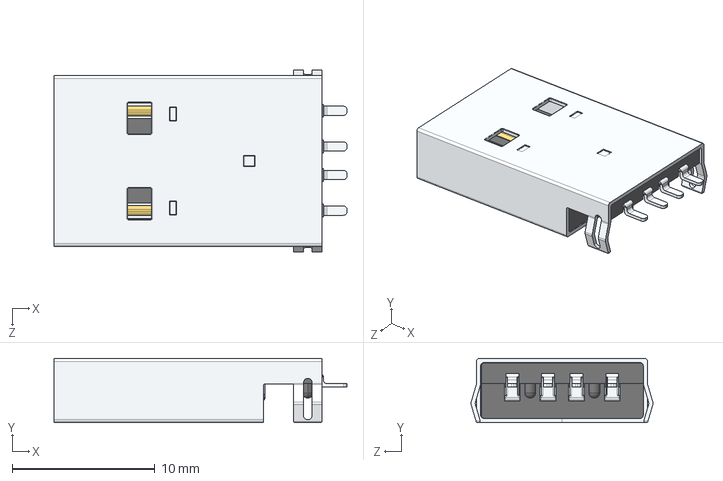
[picture p64: CAD file, 2025-05-28]
KiCAD_Footprints/OLIMEX_3Dmodels/USB-A_Male---U217-041N-4BV81.step
20.6 x 4.50 x 12.8 mm
