OLIMEX/KiCAD/KiCAD_Footprints/OLIMEX_3Dmodels/YA-V36P-2X15-LF-Amphenol_ICC(FCI)_20021321-00030T4LF.stp

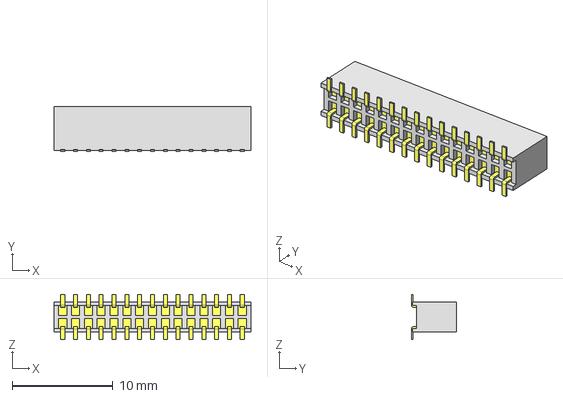
[picture p65: CAD file, 2025-05-28]
KiCAD_Footprints/OLIMEX_3Dmodels/YA-V36P-2X15-LF-Amphenol_ICC(FCI)_20021321-00030T4LF.stp
19.5 x 4.50 x 4.50 mm
_20021321-00030T4LF_body
_20021321-00030T4LF_pins
