OLIMEX/KiCAD/KiCAD_Footprints/OLIMEX_3Dmodels/LBGA-100---GLS85VM1008A-M-I-LFWE-ND214.STEP

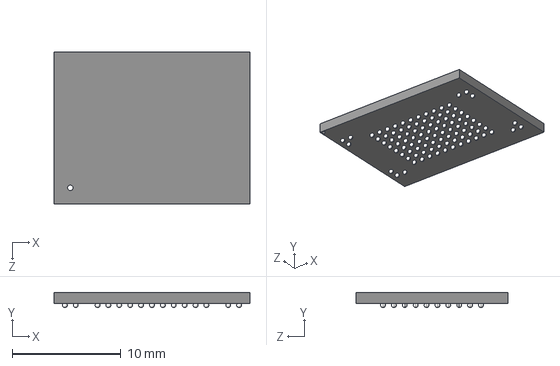
[picture p66: CAD file, 2025-05-28]
KiCAD_Footprints/OLIMEX_3Dmodels/LBGA-100---GLS85VM1008A-M-I-LFWE-ND214.STEP
18.0 x 1.40 x 14.0 mm
