OLIMEX/KiCAD/KiCAD_Footprints/OLIMEX_3Dmodels/FPV-WZB21-15-LF_Molex-545481571.stp

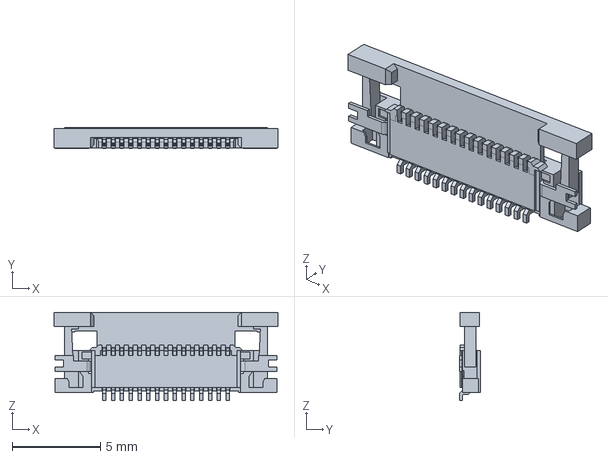
[picture p67: CAD file, 2025-05-28]
KiCAD_Footprints/OLIMEX_3Dmodels/FPV-WZB21-15-LF_Molex-545481571.stp
12.7 x 1.20 x 5.00 mm
