OLIMEX/KiCAD/KiCAD_Footprints/OLIMEX_3Dmodels/TSSOP-24.STEP

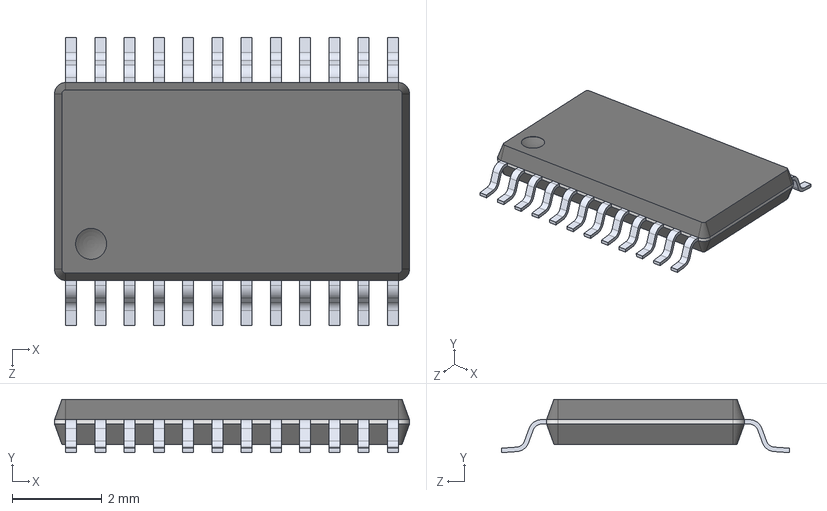
[picture p68: CAD file, 2025-05-28]
KiCAD_Footprints/OLIMEX_3Dmodels/TSSOP-24.STEP
7.89 x 1.18 x 6.41 mm
