OLIMEX/KiCAD/KiCAD_Footprints/OLIMEX_3Dmodels/TE_Connectivity-RJ45_JACK_MAG._POE_1GB_LED_1X1(2337992-8).stp

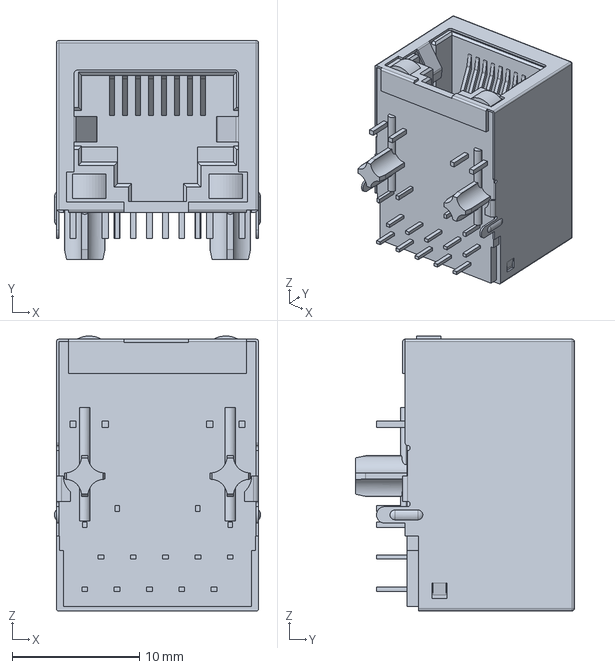
[picture p69: CAD file, 2025-05-28]
KiCAD_Footprints/OLIMEX_3Dmodels/TE_Connectivity-RJ45_JACK_MAG._POE_1GB_LED_1X1(2337992-8).stp
16.2 x 17.2 x 21.6 mm
