OLIMEX/KiCAD/KiCAD_Footprints/OLIMEX_3Dmodels/SATA_Plug_7Position(5607-4200-SH).stp

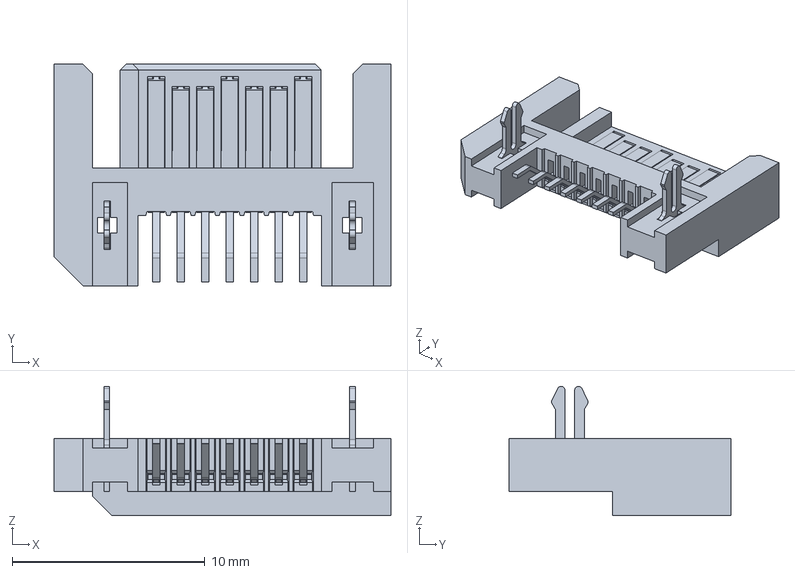
[picture p70: CAD file, 2025-05-28]
KiCAD_Footprints/OLIMEX_3Dmodels/SATA_Plug_7Position(5607-4200-SH).stp
17.5 x 11.5 x 6.70 mm
