OLIMEX/KiCAD/KiCAD_Footprints/OLIMEX_3Dmodels/Digilent_Pmod_12-pin---CviLux_CB91122H100.step

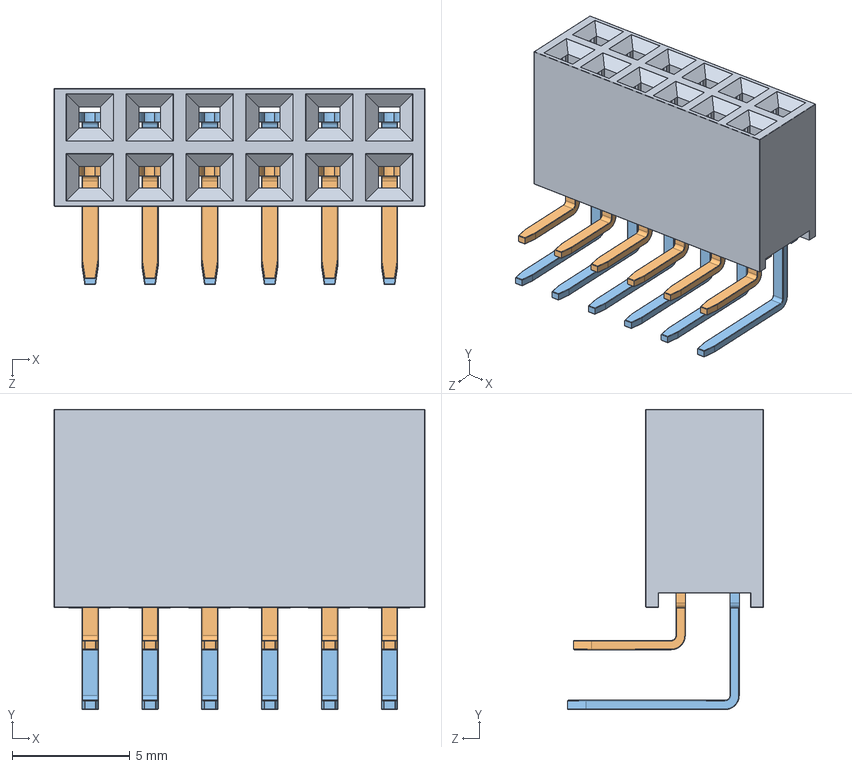
[picture p71: CAD file, 2025-05-28]
KiCAD_Footprints/OLIMEX_3Dmodels/Digilent_Pmod_12-pin---CviLux_CB91122H100.step
15.7 x 12.7 x 8.32 mm
CB91-BAS_12
CB91-t2 x 6
CB91-t3 x 6
