OLIMEX/KiCAD/KiCAD_Footprints/OLIMEX_3Dmodels/SOT89-1.STEP

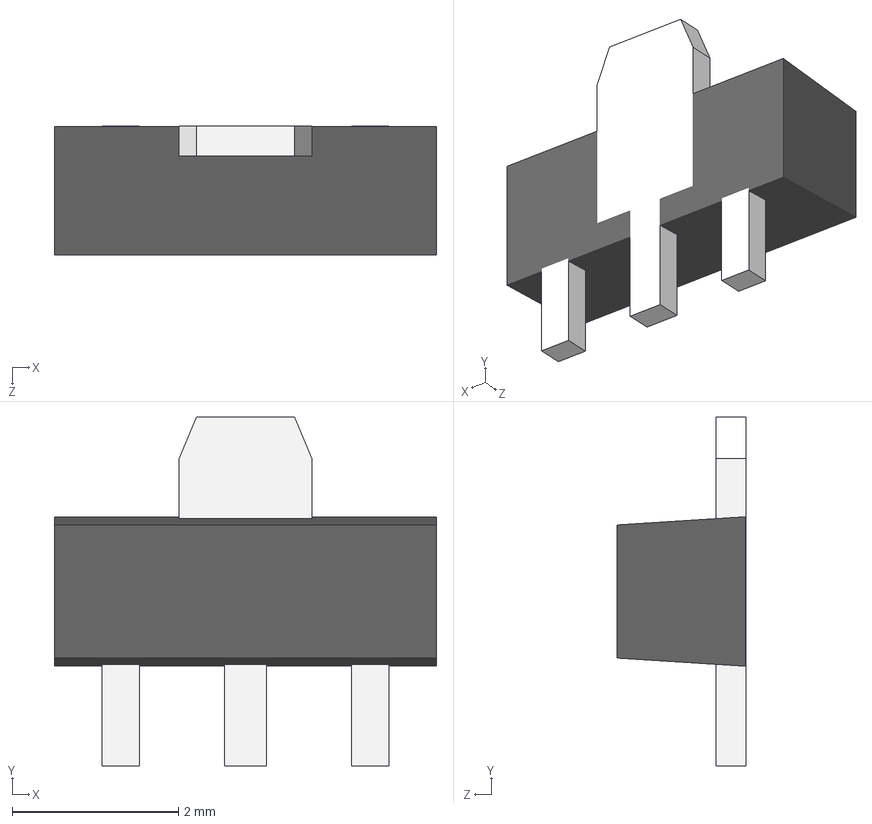
[picture p72: CAD file, 2025-05-28]
KiCAD_Footprints/OLIMEX_3Dmodels/SOT89-1.STEP
4.60 x 4.20 x 1.55 mm
