OLIMEX/KiCAD/KiCAD_Footprints/OLIMEX_3Dmodels/USB-A-MALE.step

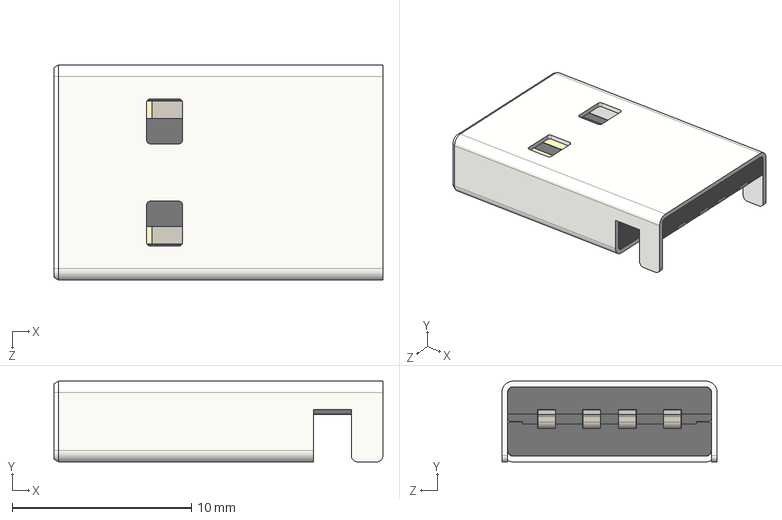
[picture p73: CAD file, 2025-05-28]
KiCAD_Footprints/OLIMEX_3Dmodels/USB-A-MALE.step
18.3 x 4.50 x 12.0 mm
