OLIMEX/KiCAD/KiCAD_Footprints/OLIMEX_3Dmodels/USB3.0-Type-A.stp

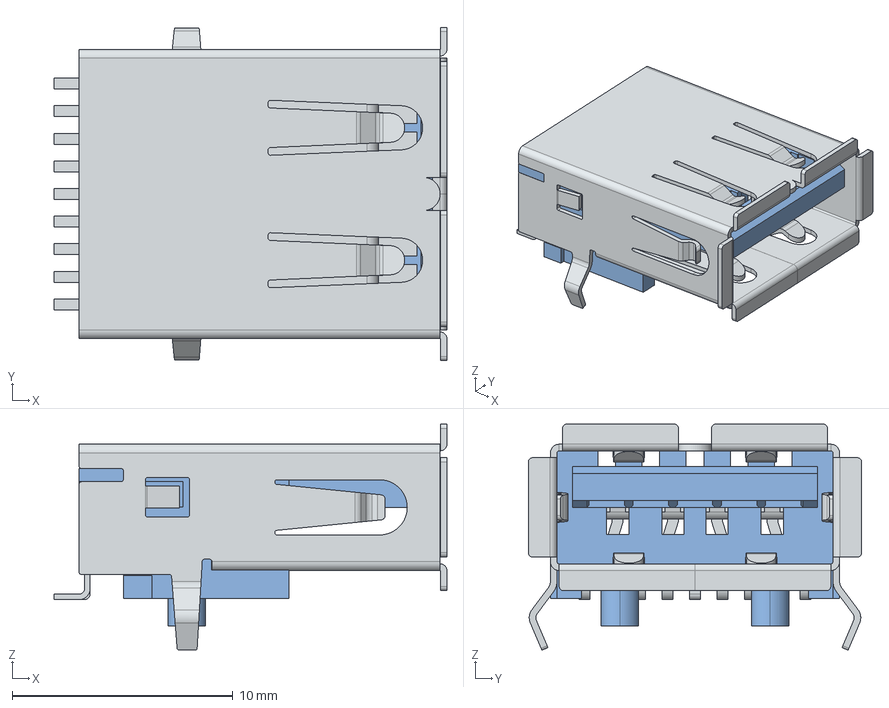
[picture p74: CAD file, 2025-05-28]
KiCAD_Footprints/OLIMEX_3Dmodels/USB3.0-Type-A.stp
17.8 x 15.1 x 10.2 mm
