OLIMEX/KiCAD/KiCAD_Footprints/OLIMEX_3Dmodels/TSSOP-16_ 5x4_4mm.STEP

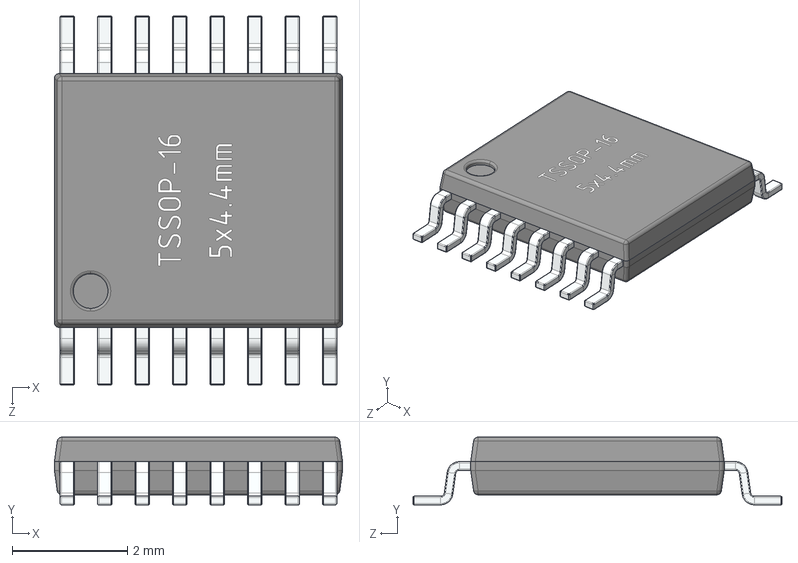
[picture p75: CAD file, 2025-05-28]
KiCAD_Footprints/OLIMEX_3Dmodels/TSSOP-16_ 5x4_4mm.STEP
5.00 x 1.18 x 6.40 mm
