OLIMEX/KiCAD/KiCAD_Footprints/OLIMEX_3Dmodels/RaspberryPiLCD-MiPi_Connector-TE_1-1734248-5.stp

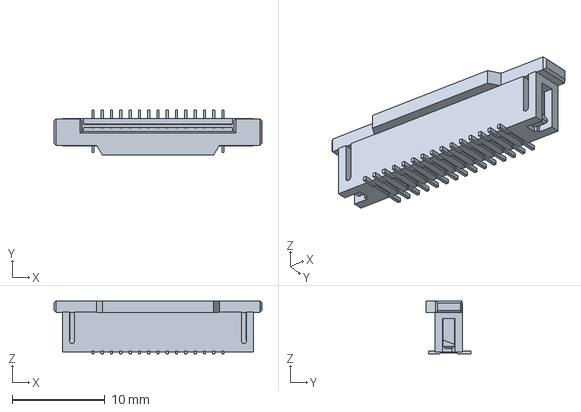
[picture p76: CAD file, 2025-05-28]
KiCAD_Footprints/OLIMEX_3Dmodels/RaspberryPiLCD-MiPi_Connector-TE_1-1734248-5.stp
22.4 x 4.85 x 5.68 mm
