OLIMEX/KiCAD/KiCAD_Footprints/OLIMEX_3Dmodels/SPEAKER_ULTRASONIC-400PT160.step

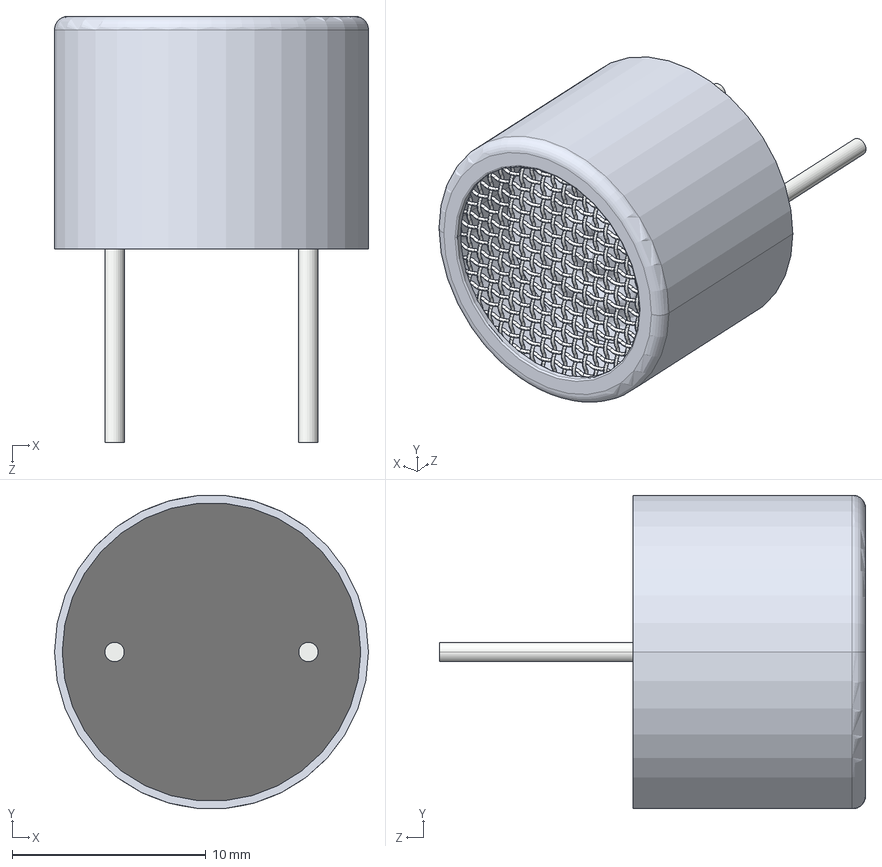
[picture p77: CAD file, 2025-05-28]
KiCAD_Footprints/OLIMEX_3Dmodels/SPEAKER_ULTRASONIC-400PT160.step
16.2 x 16.2 x 22.0 mm
