OLIMEX/KiCAD/KiCAD_Footprints/OLIMEX_3Dmodels/FPV-WZB21-24-LF_Molex-524372433.stp

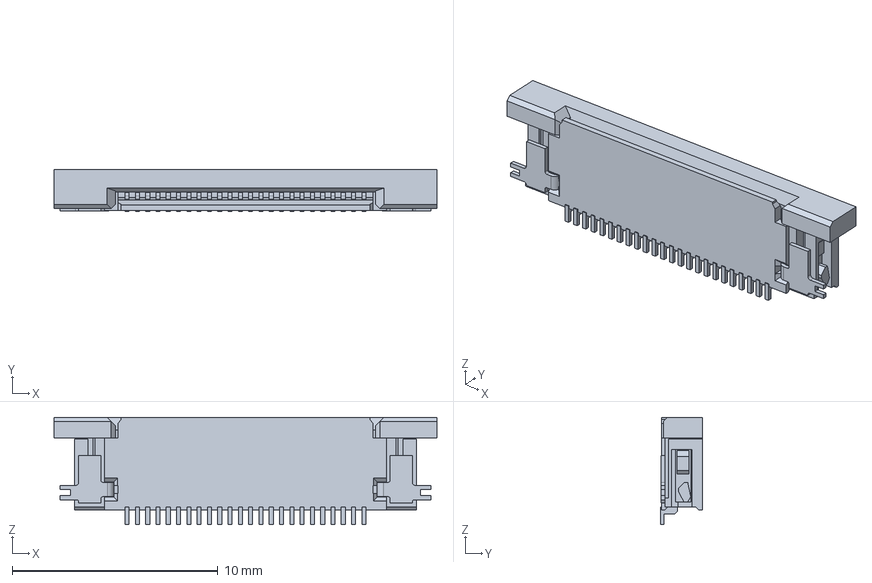
[picture p78: CAD file, 2025-05-28]
KiCAD_Footprints/OLIMEX_3Dmodels/FPV-WZB21-24-LF_Molex-524372433.stp
18.6 x 2.04 x 5.20 mm
