OLIMEX/KiCAD/KiCAD_Footprints/OLIMEX_3Dmodels/Tactal Switch - SMD (12mmx12mmx8.0mm).stp

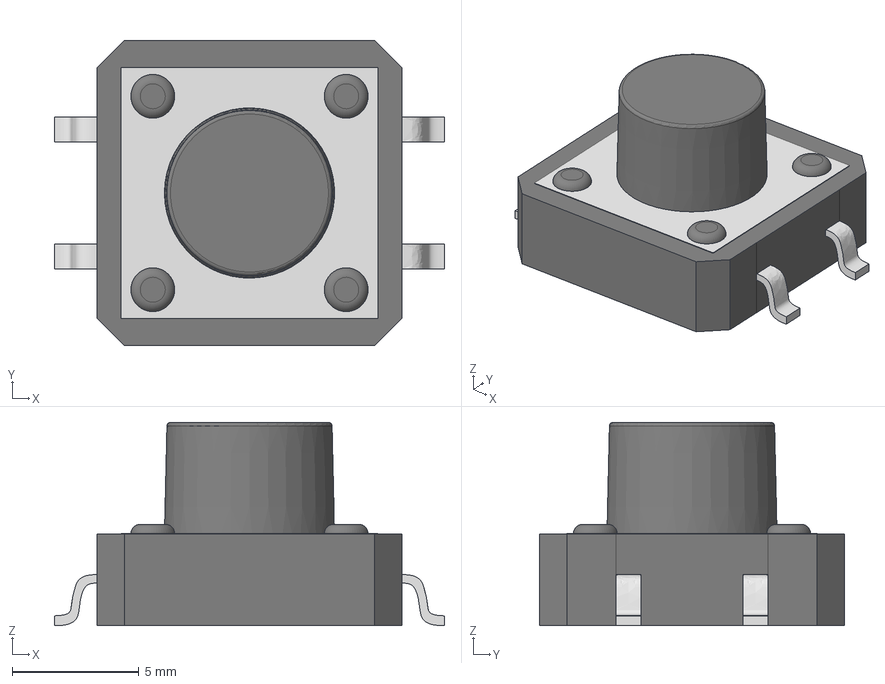
[picture p79: CAD file, 2025-05-28]
KiCAD_Footprints/OLIMEX_3Dmodels/Tactal Switch - SMD (12mmx12mmx8.0mm).stp
15.4 x 12.0 x 8.00 mm
