OLIMEX/KiCAD/KiCAD_Footprints/OLIMEX_3Dmodels/MK-D-08-LF(WF8S)_(CI3108P1V00_CVILUX).STEP

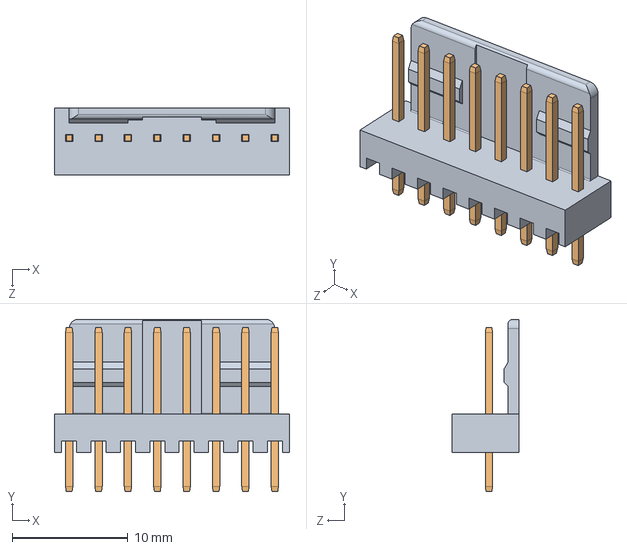
[picture p80: CAD file, 2025-05-28]
KiCAD_Footprints/OLIMEX_3Dmodels/MK-D-08-LF(WF8S)_(CI3108P1V00_CVILUX).STEP
20.3 x 14.9 x 5.80 mm
CI31 8P
PIN V x 8
