OLIMEX/KiCAD/KiCAD_Footprints/OLIMEX_3Dmodels/BUT_12x12_SMD_Red.step

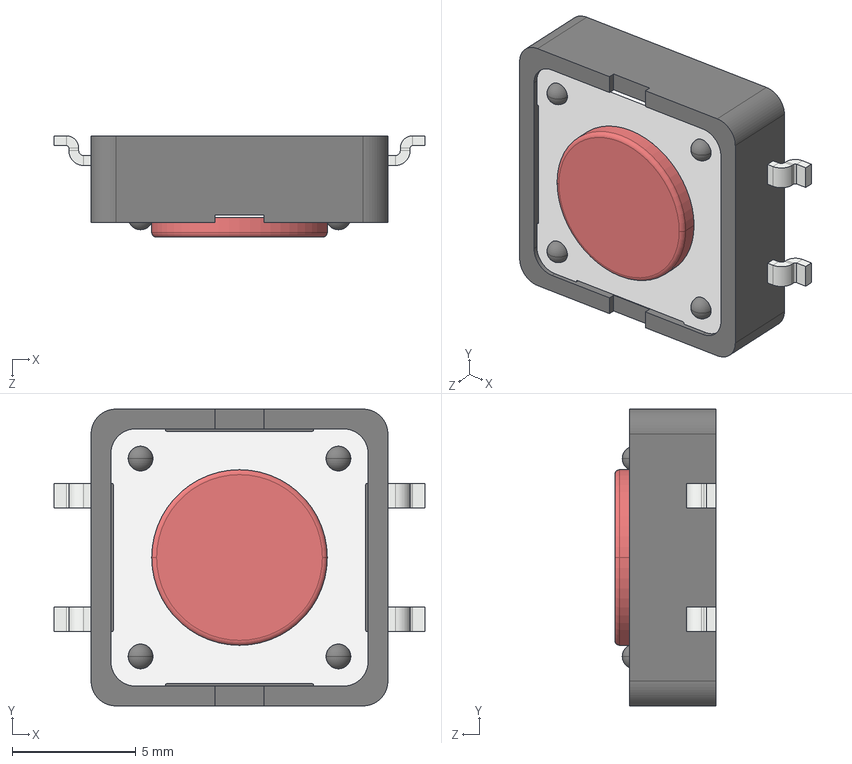
[picture p81: CAD file, 2025-05-28]
KiCAD_Footprints/OLIMEX_3Dmodels/BUT_12x12_SMD_Red.step
15.0 x 12.0 x 4.10 mm
