OLIMEX/KiCAD/KiCAD_Footprints/OLIMEX_3Dmodels/BAT-HOLDER-18650.step

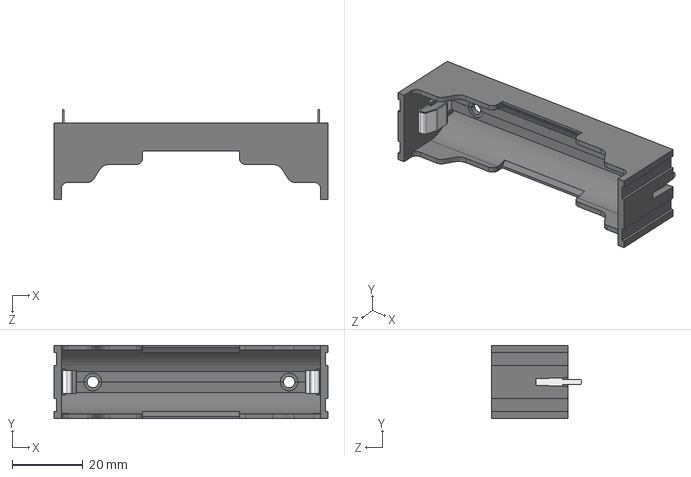
[picture p82: CAD file, 2025-05-28]
KiCAD_Footprints/OLIMEX_3Dmodels/BAT-HOLDER-18650.step
77.6 x 20.8 x 25.5 mm
18650m_1
18650s_По умолчанию x 2
