OLIMEX/KiCAD/KiCAD_Footprints/OLIMEX_3Dmodels/DIL20.step

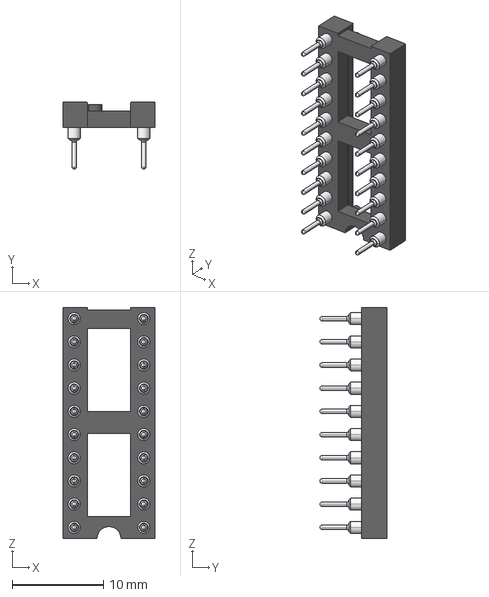
[picture p83: CAD file, 2025-05-28]
KiCAD_Footprints/OLIMEX_3Dmodels/DIL20.step
10.1 x 7.37 x 25.3 mm
