OLIMEX/KiCAD/KiCAD_Footprints/OLIMEX_3Dmodels/User Library-LQFP80-2.STEP

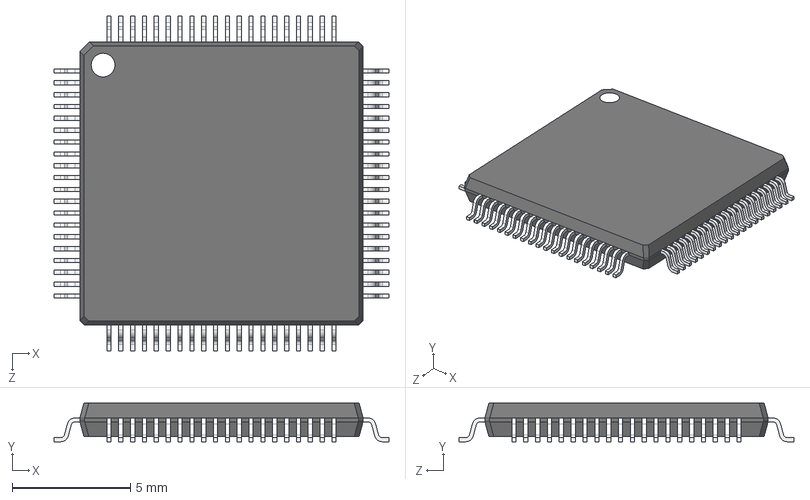
[picture p84: CAD file, 2025-05-28]
KiCAD_Footprints/OLIMEX_3Dmodels/User Library-LQFP80-2.STEP
14.1 x 1.63 x 14.1 mm
case
pin x 80
circle
