OLIMEX/KiCAD/KiCAD_Footprints/OLIMEX_3Dmodels/GBH254SMT-20(B-V-20-LF)(IDC-Header_2x10_P2.54mm_Vertical_SMD).step

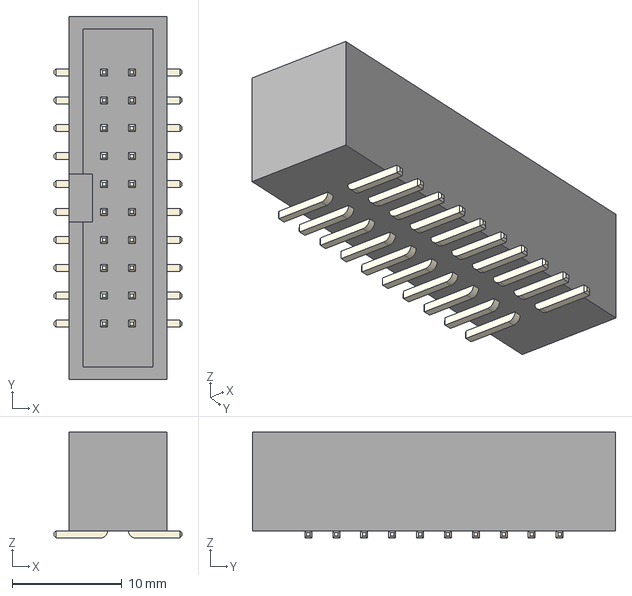
[picture p85: CAD file, 2025-05-28]
KiCAD_Footprints/OLIMEX_3Dmodels/GBH254SMT-20(B-V-20-LF)(IDC-Header_2x10_P2.54mm_Vertical_SMD).step
11.6 x 33.0 x 9.64 mm
