OLIMEX/KiCAD/KiCAD_Footprints/OLIMEX_3Dmodels/GPH254SMT02x20(H-V33X-2X20-LF)_CviLux-CH8140xM100-00-NH.step

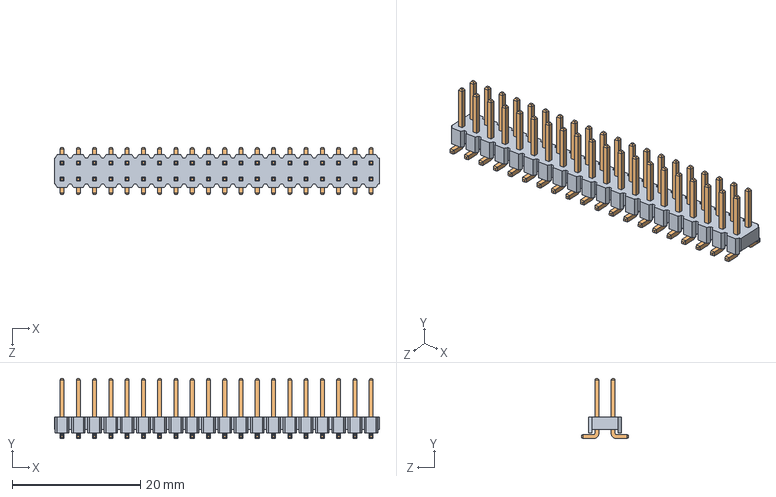
[picture p86: CAD file, 2025-05-28]
KiCAD_Footprints/OLIMEX_3Dmodels/GPH254SMT02x20(H-V33X-2X20-LF)_CviLux-CH8140xM100-00-NH.step
50.7 x 9.40 x 7.40 mm
CH81 BASE xx_40
CH84-M00 x 40
