OLIMEX/KiCAD/KiCAD_Footprints/OLIMEX_3Dmodels/QFN-12(VQFN-12).step

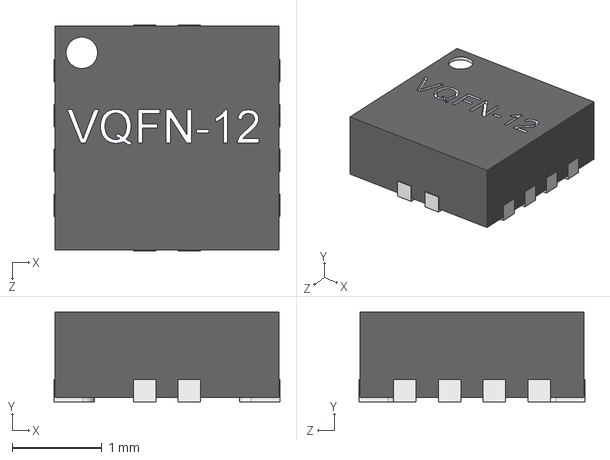
[picture p87: CAD file, 2025-05-28]
KiCAD_Footprints/OLIMEX_3Dmodels/QFN-12(VQFN-12).step
2.52 x 1.00 x 2.52 mm
