OLIMEX/KiCAD/KiCAD_Footprints/OLIMEX_3Dmodels/SMD_SWITCH_6x6x5mm---SKPMBHE010.step

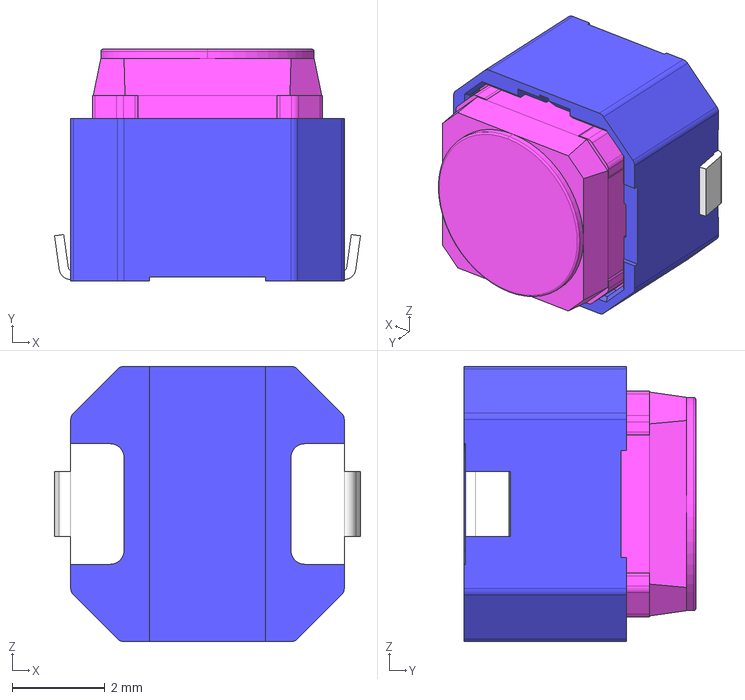
[picture p88: CAD file, 2025-05-28]
KiCAD_Footprints/OLIMEX_3Dmodels/SMD_SWITCH_6x6x5mm---SKPMBHE010.step
6.60 x 5.00 x 5.94 mm
