OLIMEX/KiCAD/KiCAD_Footprints/OLIMEX_3Dmodels/PN1x3-Molex_C-Grid_901471103_1x03_P2.54mm_Vertical.step

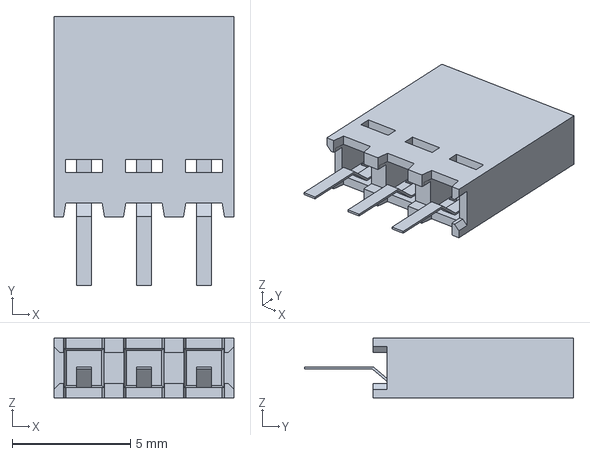
[picture p89: CAD file, 2019-03-28]
KiCAD_Footprints/OLIMEX_3Dmodels/PN1x3-Molex_C-Grid_901471103_1x03_P2.54mm_Vertical.step
7.62 x 11.4 x 2.54 mm
