OLIMEX/KiCAD/KiCAD_Footprints/OLIMEX_3Dmodels/WAGO-2060-402.stp

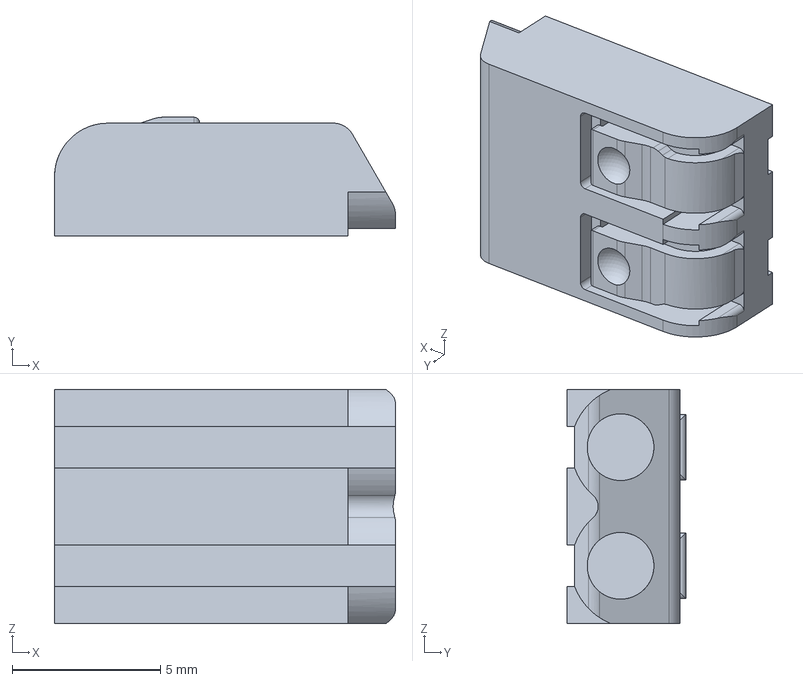
[picture p90: CAD file, 2019-03-28]
KiCAD_Footprints/OLIMEX_3Dmodels/WAGO-2060-402.stp
11.5 x 4.00 x 7.90 mm
