OLIMEX/KiCAD/KiCAD_Footprints/OLIMEX_3Dmodels/WU03S-Molex_PicoBlade_530470310_1x03_P1.25mm_Vertical.step

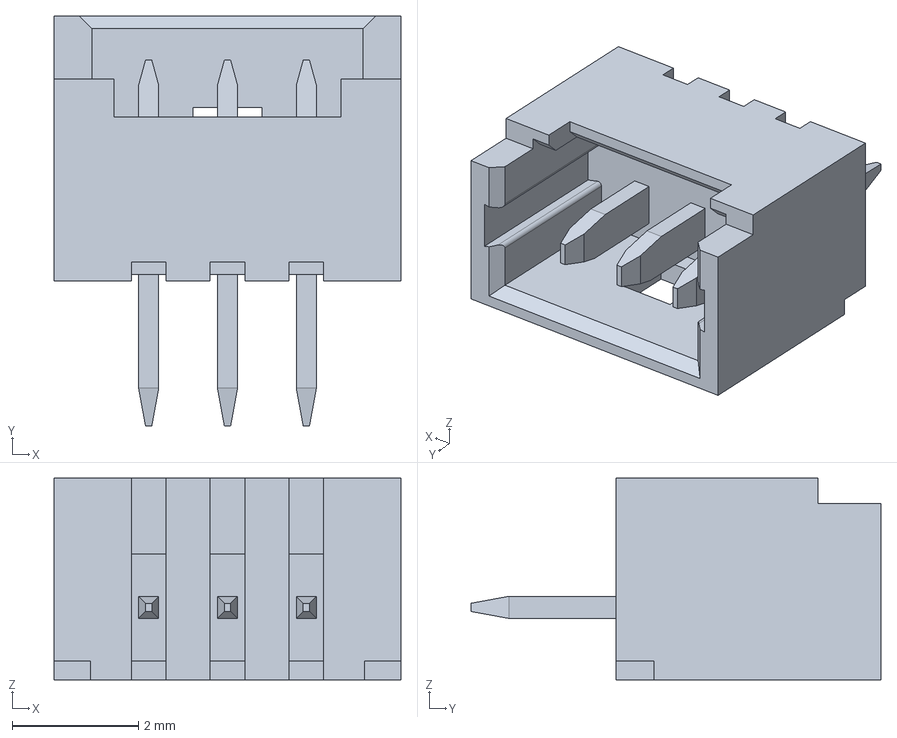
[picture p91: CAD file, 2019-03-28]
KiCAD_Footprints/OLIMEX_3Dmodels/WU03S-Molex_PicoBlade_530470310_1x03_P1.25mm_Vertical.step
5.50 x 6.50 x 3.20 mm
