OLIMEX/KiCAD/KiCAD_Footprints/OLIMEX_3Dmodels/QFN68(8x8mm).step

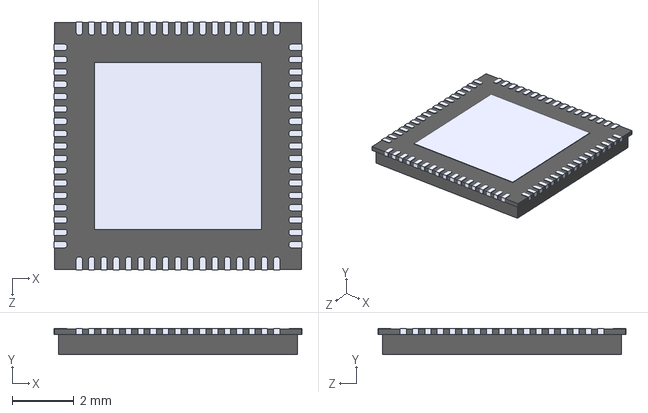
[picture p92: CAD file, 2019-03-28]
KiCAD_Footprints/OLIMEX_3Dmodels/QFN68(8x8mm).step
8.04 x 0.85 x 8.04 mm
