OLIMEX/KiCAD/KiCAD_Footprints/OLIMEX_3Dmodels/LQFP-48_7x7mm_P0.5mm.step

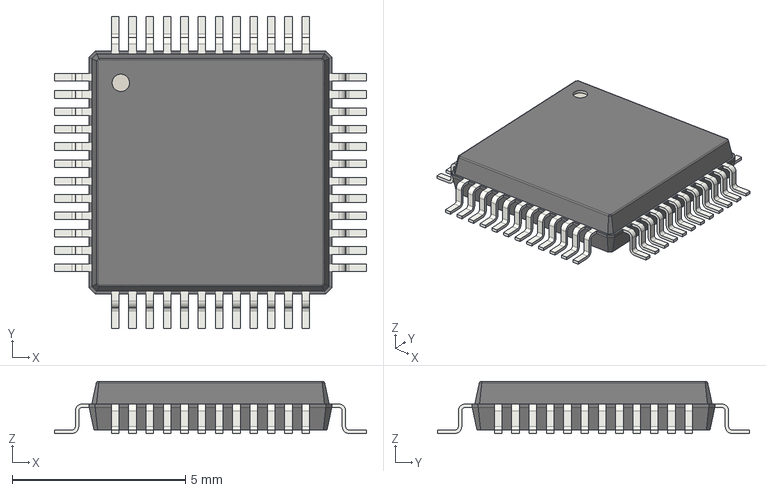
[picture p93: CAD file, 2019-03-28]
KiCAD_Footprints/OLIMEX_3Dmodels/LQFP-48_7x7mm_P0.5mm.step
9.00 x 9.00 x 1.50 mm
