OLIMEX/KiCAD/KiCAD_Footprints/OLIMEX_3Dmodels/HN1x2-PinHeader_1x02_P2.54mm_Vertical.step

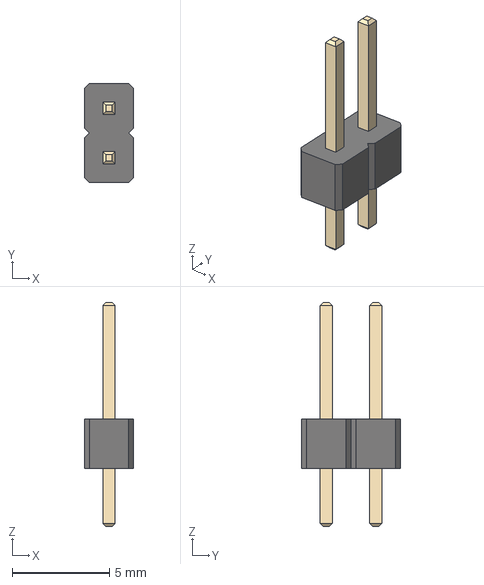
[picture p95: CAD file, 2019-03-28]
KiCAD_Footprints/OLIMEX_3Dmodels/HN1x2-PinHeader_1x02_P2.54mm_Vertical.step
2.54 x 5.08 x 11.5 mm
