OLIMEX/KiCAD/KiCAD_Footprints/OLIMEX_3Dmodels/DO-214AB_SMC.step

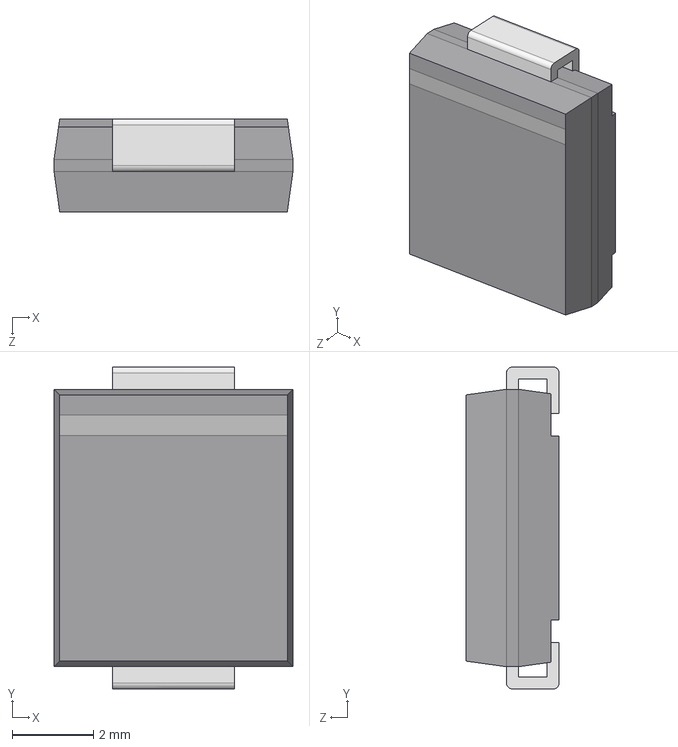
[picture p96: CAD file, 2019-03-28]
KiCAD_Footprints/OLIMEX_3Dmodels/DO-214AB_SMC.step
5.90 x 7.95 x 2.30 mm
