OLIMEX/KiCAD/KiCAD_Footprints/OLIMEX_3Dmodels/JumperSL2.STEP

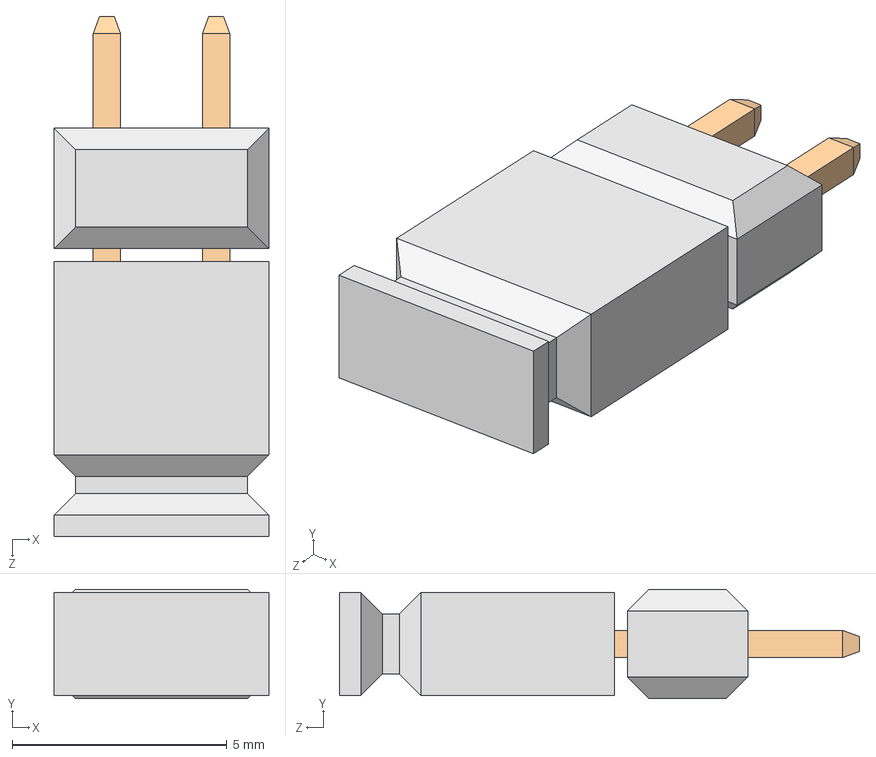
[picture p97: CAD file, 2019-03-28]
KiCAD_Footprints/OLIMEX_3Dmodels/JumperSL2.STEP
5.00 x 2.54 x 12.1 mm
SW3dPS-Jumper SL2_Kosticka SL2_Výchozí
SW3dPS-Jumper SL2_Jumper CAB4_Výchozí
SW3dPS-Jumper SL2_NuP SL2_Výchozí x 2
