OLIMEX/KiCAD/KiCAD_Footprints/OLIMEX_3Dmodels/HN1x14-PinHeader_1x14_P2.54mm_Vertical.step

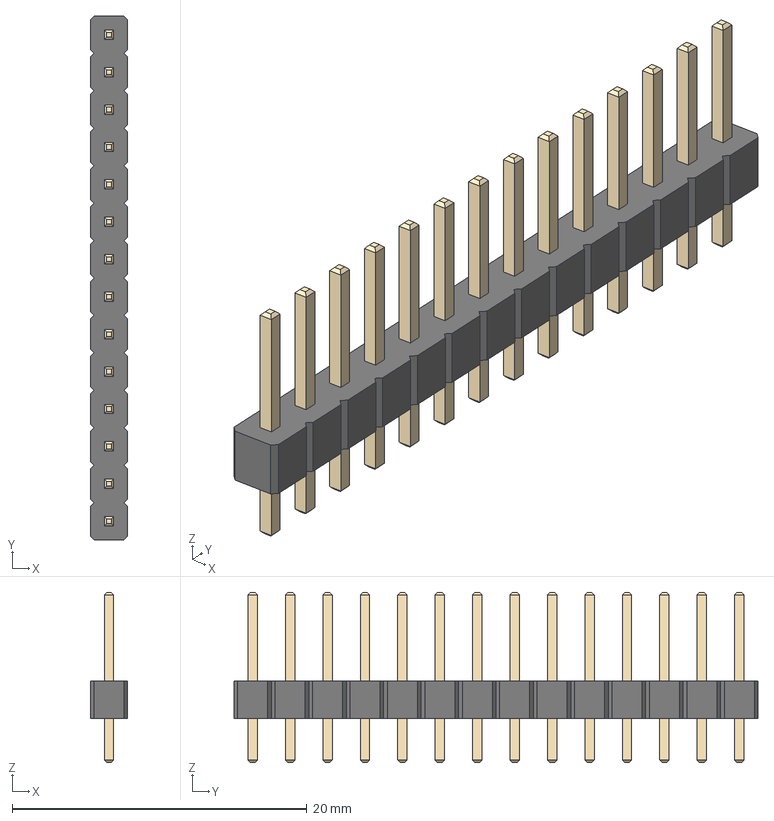
[picture p98: CAD file, 2019-03-28]
KiCAD_Footprints/OLIMEX_3Dmodels/HN1x14-PinHeader_1x14_P2.54mm_Vertical.step
2.54 x 35.6 x 11.5 mm
