OLIMEX/KiCAD/KiCAD_Footprints/OLIMEX_3Dmodels/SM02B-SRSS-TB.step

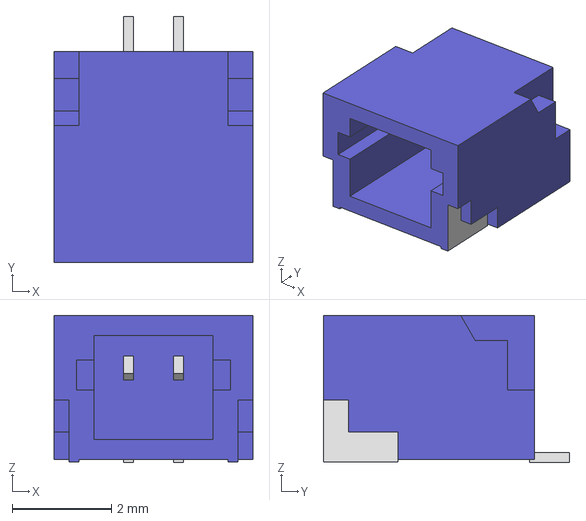
[picture p99: CAD file, 2019-03-28]
KiCAD_Footprints/OLIMEX_3Dmodels/SM02B-SRSS-TB.step
4.00 x 4.95 x 2.96 mm
