OLIMEX/KiCAD/KiCAD_Footprints/OLIMEX_3Dmodels/Header _Fem_1X8.step

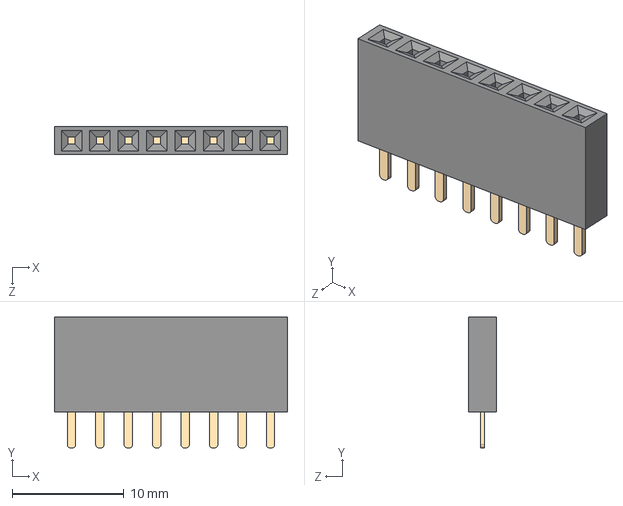
[picture p100: CAD file, 2019-03-28]
KiCAD_Footprints/OLIMEX_3Dmodels/Header _Fem_1X8.step
20.8 x 11.7 x 2.54 mm
