OLIMEX/KiCAD/KiCAD_Footprints/OLIMEX_3Dmodels/HN1x11-PinHeader_1x11_P2.54mm_Vertical.step

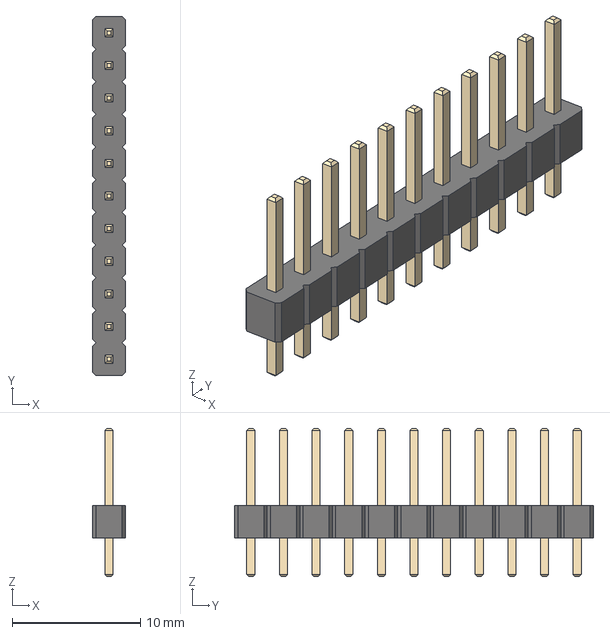
[picture p101: CAD file, 2019-03-28]
KiCAD_Footprints/OLIMEX_3Dmodels/HN1x11-PinHeader_1x11_P2.54mm_Vertical.step
2.54 x 27.9 x 11.5 mm
