OLIMEX/KiCAD/KiCAD_Footprints/OLIMEX_3Dmodels/CCS811.STEP

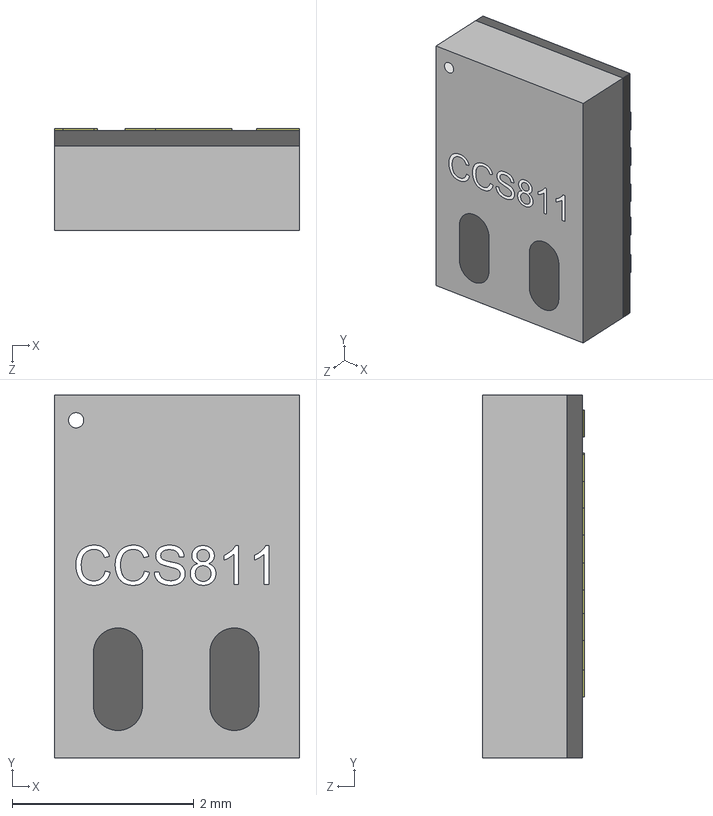
[picture p102: CAD file, 2019-03-28]
KiCAD_Footprints/OLIMEX_3Dmodels/CCS811.STEP
2.70 x 4.00 x 1.12 mm
User Library-CCS811_Part_4915
User Library-CCS811_Part_4916
User Library-CCS811_Part_4917
User Library-CCS811_Part_4696
User Library-CCS811_Part_5153
User Library-CCS811_Part_5152
User Library-CCS811_Part_5151
User Library-CCS811_Part_5150
User Library-CCS811_Part_5149
User Library-CCS811_Part_5148
User Library-CCS811_Part_5147
User Library-CCS811_Part_5146
User Library-CCS811_Part_5145
User Library-CCS811_Part_5144
User Library-CCS811_Part_5143
User Library-CCS811_Part_5142
User Library-CCS811_1
User Library-CCS811_2
User Library-CCS811_3
User Library-CCS811_4
User Library-CCS811_5
User Library-CCS811_6
User Library-CCS811_Part_4918
