OLIMEX/KiCAD/KiCAD_Footprints/OLIMEX_3Dmodels/DO-214AC_SMA.step

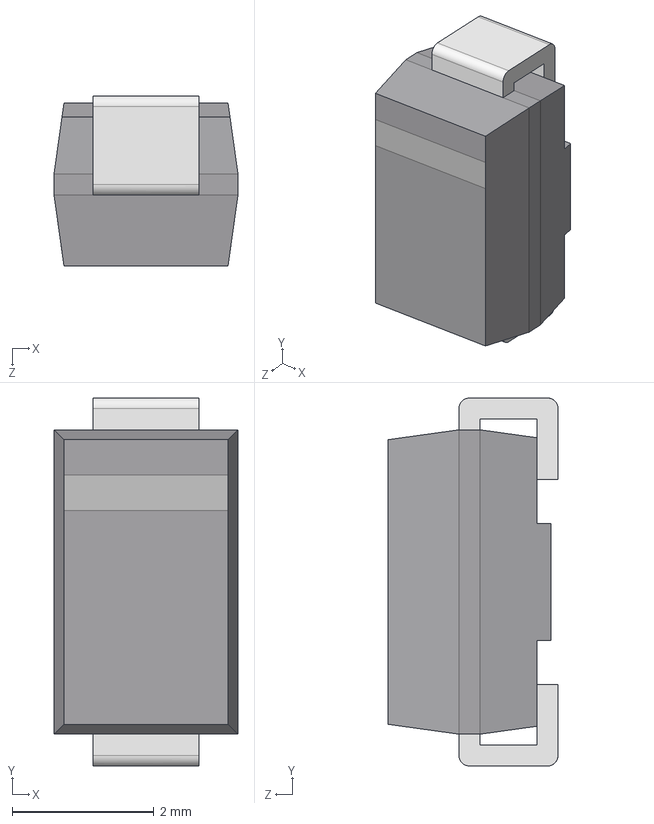
[picture p103: CAD file, 2019-03-28]
KiCAD_Footprints/OLIMEX_3Dmodels/DO-214AC_SMA.step
2.60 x 5.20 x 2.40 mm
