OLIMEX/KiCAD/KiCAD_Footprints/OLIMEX_3Dmodels/ALSRobot-BUZZER.step

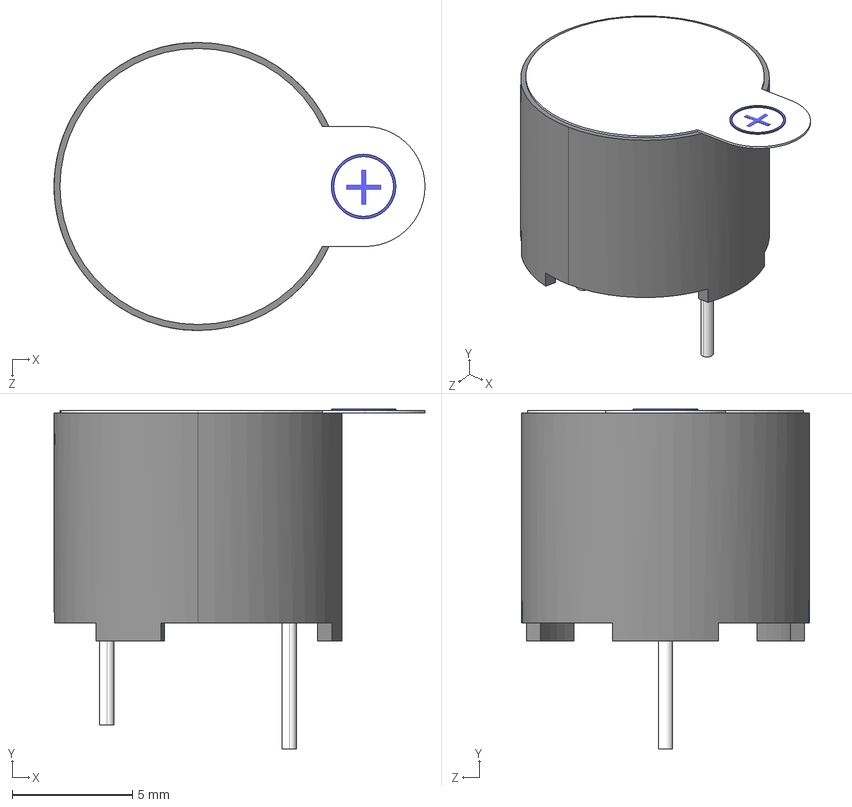
[picture p104: CAD file, 2019-03-28]
KiCAD_Footprints/OLIMEX_3Dmodels/ALSRobot-BUZZER.step
15.5 x 14.2 x 12.0 mm
