OLIMEX/KiCAD/KiCAD_Footprints/OLIMEX_3Dmodels/WU14S-Molex_PicoBlade_530471410_1x14_P1.25mm_Vertical.step

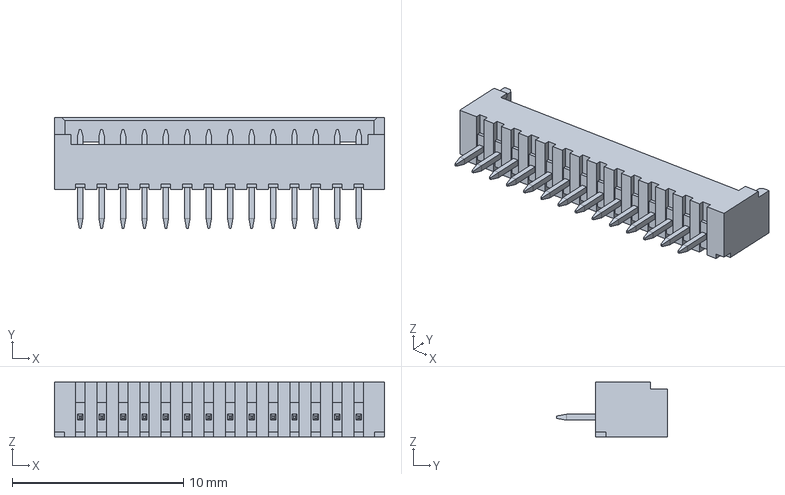
[picture p105: CAD file, 2019-03-28]
KiCAD_Footprints/OLIMEX_3Dmodels/WU14S-Molex_PicoBlade_530471410_1x14_P1.25mm_Vertical.step
19.2 x 6.50 x 3.20 mm
