OLIMEX/KiCAD/KiCAD_Footprints/OLIMEX_3Dmodels/BH3Vert.STEP

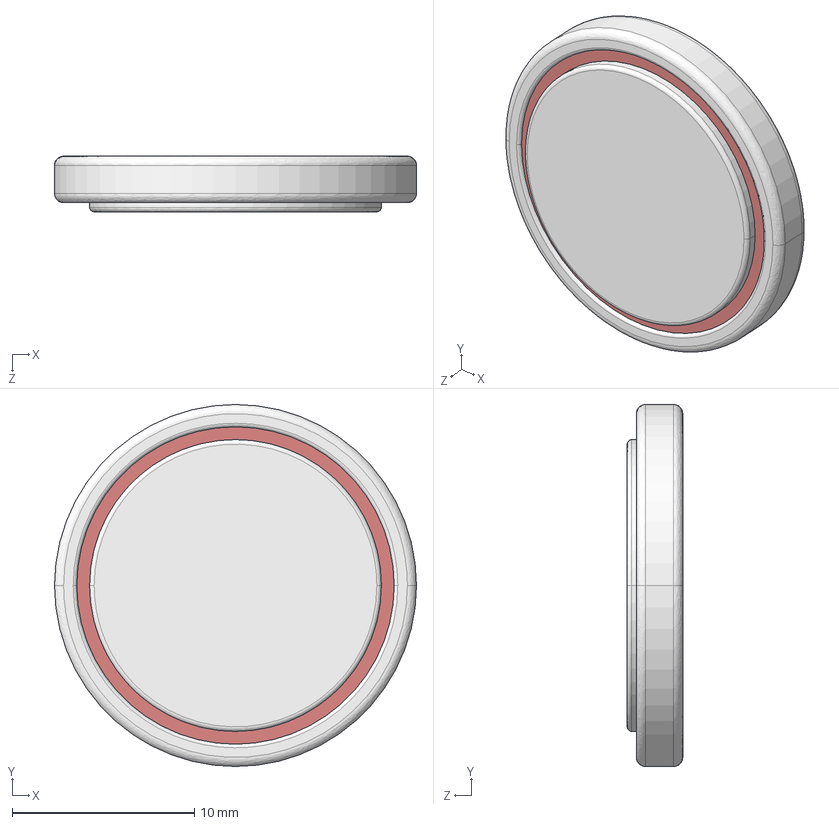
[picture p106: CAD file, 2019-03-28]
KiCAD_Footprints/OLIMEX_3Dmodels/BH3Vert.STEP
19.9 x 19.8 x 3.05 mm
