OLIMEX/KiCAD/KiCAD_Footprints/OLIMEX_3Dmodels/SL08.step

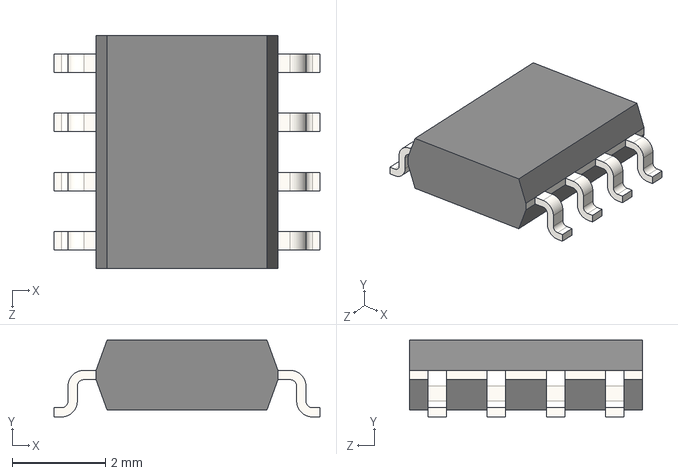
[picture p107: CAD file, 2019-03-28]
KiCAD_Footprints/OLIMEX_3Dmodels/SL08.step
5.70 x 1.65 x 5.00 mm
