OLIMEX/KiCAD/KiCAD_Footprints/OLIMEX_3Dmodels/Micro_SD_card.step

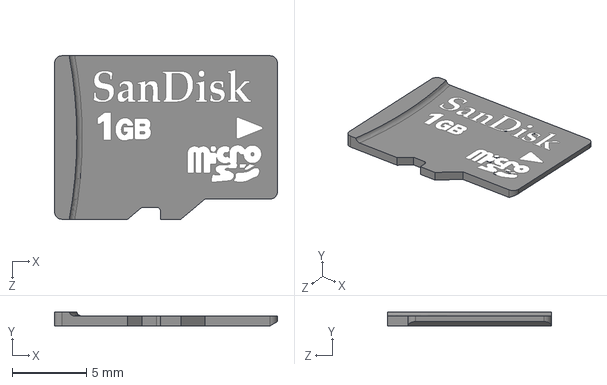
[picture p108: CAD file, 2019-03-28]
KiCAD_Footprints/OLIMEX_3Dmodels/Micro_SD_card.step
15.0 x 0.975 x 11.0 mm
