OLIMEX/KiCAD/KiCAD_Footprints/OLIMEX_3Dmodels/LED_5730.step

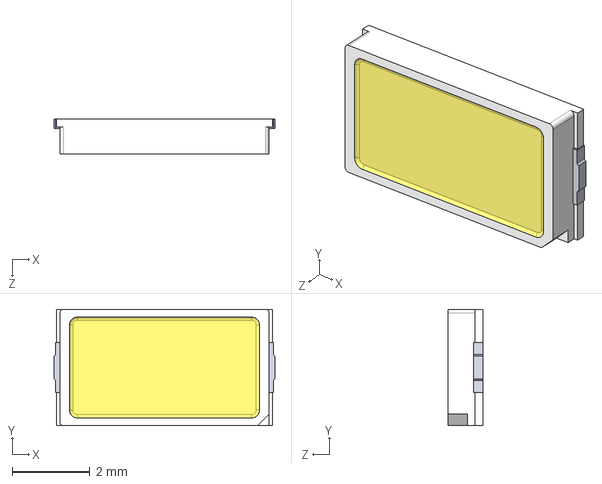
[picture p109: CAD file, 2019-03-28]
KiCAD_Footprints/OLIMEX_3Dmodels/LED_5730.step
5.70 x 3.00 x 0.9 mm
