OLIMEX/KiCAD/KiCAD_Footprints/OLIMEX_3Dmodels/NR3015.step

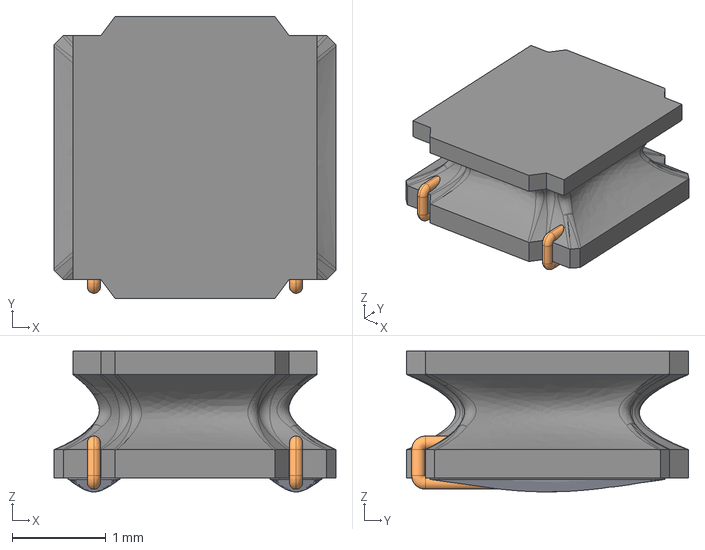
[picture p110: CAD file, 2019-03-28]
KiCAD_Footprints/OLIMEX_3Dmodels/NR3015.step
3.00 x 3.00 x 1.50 mm
