OLIMEX/KiCAD/KiCAD_Footprints/OLIMEX_3Dmodels/LED_0603_Y.step

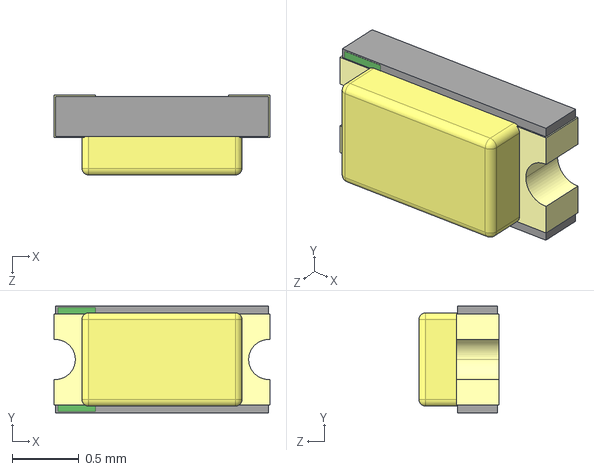
[picture p111: CAD file, 2019-03-28]
KiCAD_Footprints/OLIMEX_3Dmodels/LED_0603_Y.step
1.62 x 0.8 x 0.6 mm
