OLIMEX/KiCAD/KiCAD_Footprints/OLIMEX_3Dmodels/QFN64-2.step

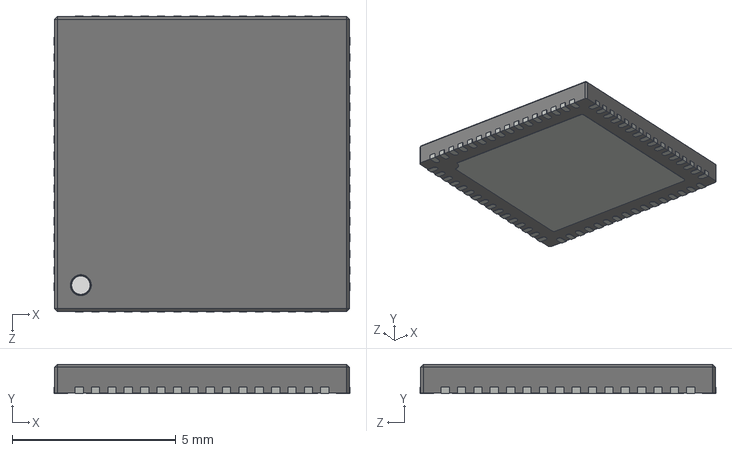
[picture p112: CAD file, 2019-03-28]
KiCAD_Footprints/OLIMEX_3Dmodels/QFN64-2.step
9.04 x 0.9 x 9.04 mm
