OLIMEX/KiCAD/KiCAD_Footprints/OLIMEX_3Dmodels/NANO-SIM_Wurth_Electronics_693043020611.step

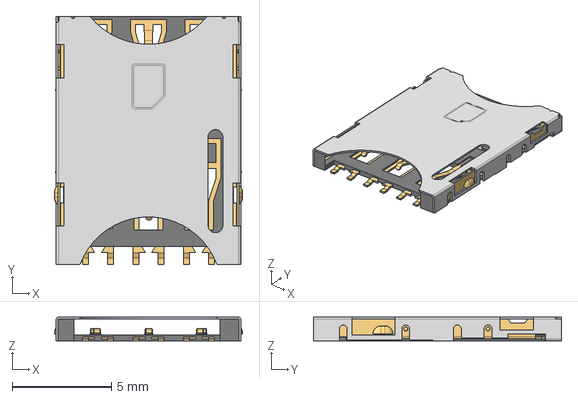
[picture p113: CAD file, 2019-03-28]
KiCAD_Footprints/OLIMEX_3Dmodels/NANO-SIM_Wurth_Electronics_693043020611.step
9.50 x 12.5 x 1.21 mm
693043020611_SHIELDING
