OLIMEX/KiCAD/KiCAD_Footprints/OLIMEX_3Dmodels/HN1x3-PinHeader_1x03_P2.54mm_Vertical.step

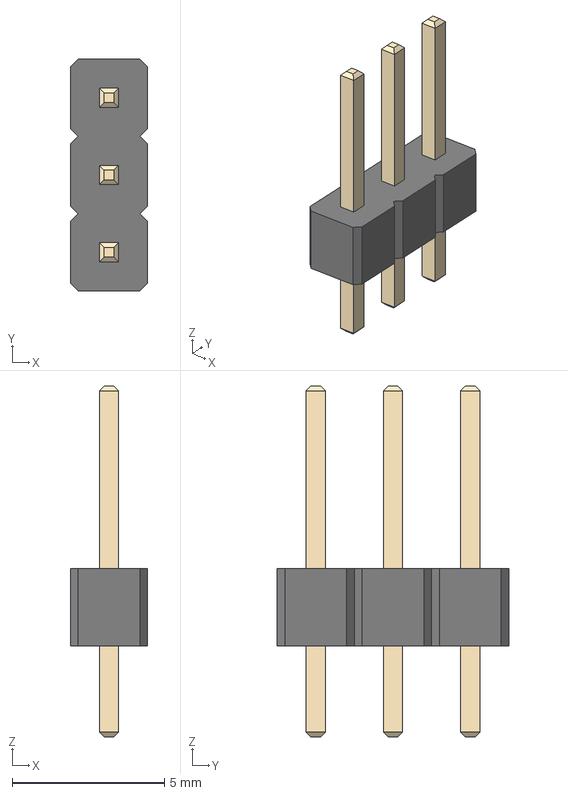
[picture p114: CAD file, 2019-03-28]
KiCAD_Footprints/OLIMEX_3Dmodels/HN1x3-PinHeader_1x03_P2.54mm_Vertical.step
2.54 x 7.62 x 11.5 mm
