OLIMEX/KiCAD/KiCAD_Footprints/OLIMEX_3Dmodels/ELECTROLITIC CAPACITOR RADIAL 8X12.step

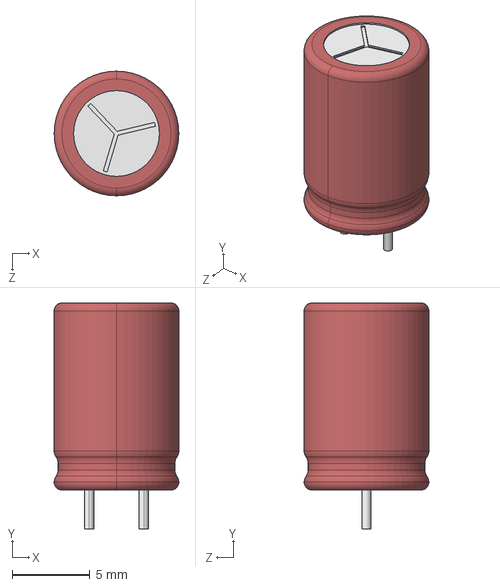
[picture p115: CAD file, 2019-03-28]
KiCAD_Footprints/OLIMEX_3Dmodels/ELECTROLITIC CAPACITOR RADIAL 8X12.step
8.00 x 14.5 x 8.00 mm
