OLIMEX/KiCAD/KiCAD_Footprints/OLIMEX_3Dmodels/melf-2_sod80c.step

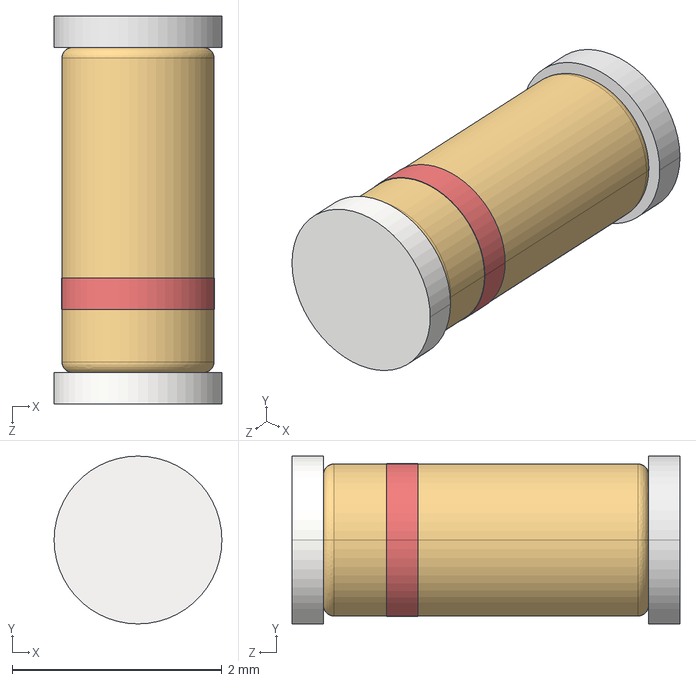
[picture p116: CAD file, 2019-03-28]
KiCAD_Footprints/OLIMEX_3Dmodels/melf-2_sod80c.step
1.60 x 1.60 x 3.70 mm
