OLIMEX/KiCAD/KiCAD_Footprints/OLIMEX_3Dmodels/TDFN-EP-14.step

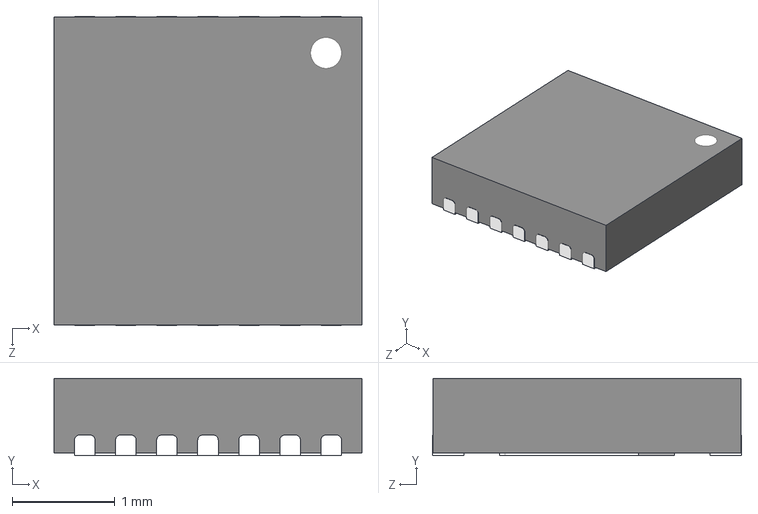
[picture p117: CAD file, 2019-03-28]
KiCAD_Footprints/OLIMEX_3Dmodels/TDFN-EP-14.step
3.00 x 0.751 x 3.01 mm
