OLIMEX/KiCAD/KiCAD_Footprints/OLIMEX_3Dmodels/PN1x20-Molex_C-Grid_901471120_1x20_P2.54mm_Vertical.step

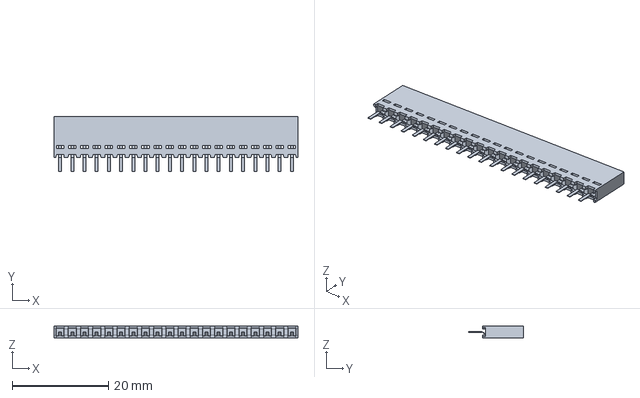
[picture p118: CAD file, 2019-03-28]
KiCAD_Footprints/OLIMEX_3Dmodels/PN1x20-Molex_C-Grid_901471120_1x20_P2.54mm_Vertical.step
50.8 x 11.4 x 2.54 mm
