OLIMEX/KiCAD/KiCAD_Footprints/OLIMEX_3Dmodels/PN1x25-Molex_C-Grid_901471125_1x25_P2.54mm_Vertical.step

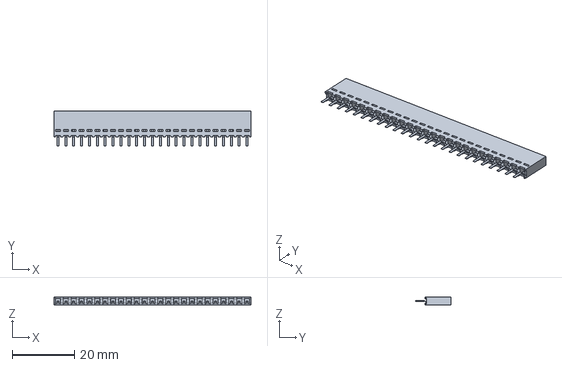
[picture p119: CAD file, 2019-03-28]
KiCAD_Footprints/OLIMEX_3Dmodels/PN1x25-Molex_C-Grid_901471125_1x25_P2.54mm_Vertical.step
63.5 x 11.4 x 2.54 mm
