OLIMEX/KiCAD/KiCAD_Footprints/OLIMEX_3Dmodels/HR1x3-PinHeader_1x03_P2.54mm_Horizontal.step

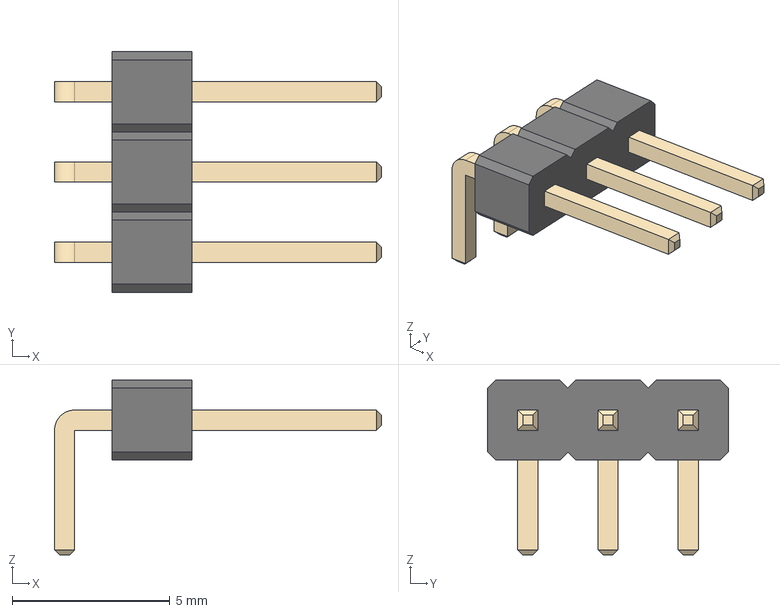
[picture p120: CAD file, 2019-03-28]
KiCAD_Footprints/OLIMEX_3Dmodels/HR1x3-PinHeader_1x03_P2.54mm_Horizontal.step
10.4 x 7.62 x 5.54 mm
