OLIMEX/KiCAD/KiCAD_Footprints/OLIMEX_3Dmodels/SOD106.step

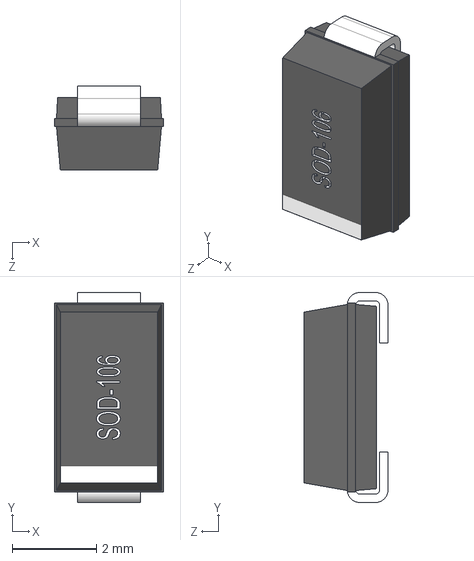
[picture p121: CAD file, 2019-03-28]
KiCAD_Footprints/OLIMEX_3Dmodels/SOD106.step
2.60 x 5.00 x 2.00 mm
