OLIMEX/KiCAD/KiCAD_Footprints/OLIMEX_3Dmodels/HN1x8-PinHeader_1x08_P2.54mm_Vertical.step

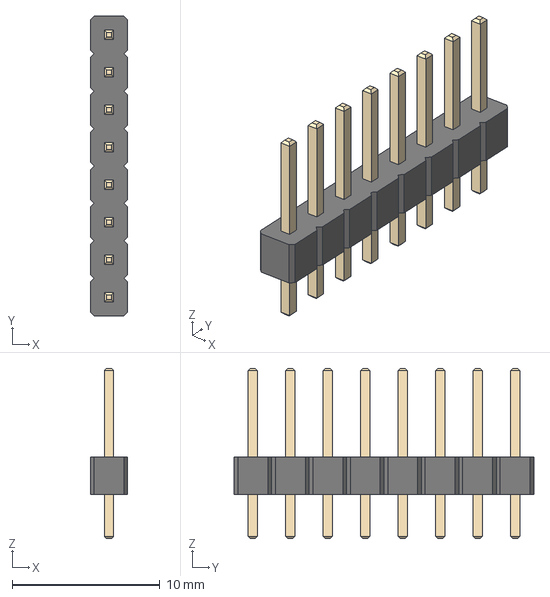
[picture p122: CAD file, 2019-03-28]
KiCAD_Footprints/OLIMEX_3Dmodels/HN1x8-PinHeader_1x08_P2.54mm_Vertical.step
2.54 x 20.3 x 11.5 mm
