OLIMEX/KiCAD/KiCAD_Footprints/OLIMEX_3Dmodels/pulsetraf.STEP

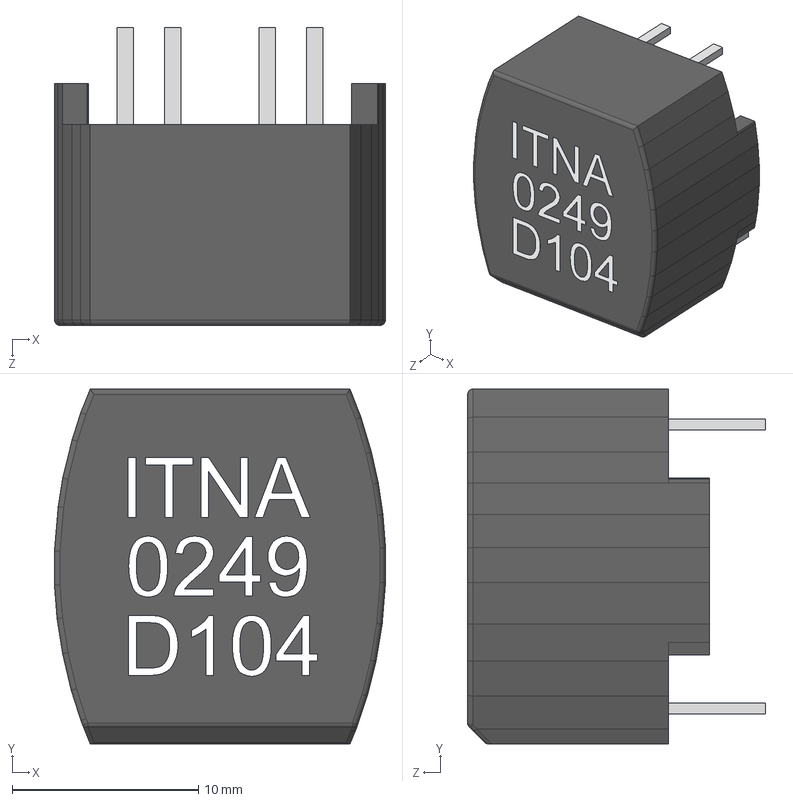
[picture p123: CAD file, 2019-03-28]
KiCAD_Footprints/OLIMEX_3Dmodels/pulsetraf.STEP
17.8 x 19.1 x 16.0 mm
User Library-ITNA_ITNA
User Library-ITNA_ITNA_2
User Library-ITNA_Extruded x 2
User Library-ITNA_Extruded_2 x 2
User Library-ITNA_Extruded_3
User Library-ITNA_Extruded_4
User Library-ITNA_Extruded_5
User Library-ITNA_Extruded_6
User Library-ITNA_Extruded_7
User Library-ITNA_Extruded_8
User Library-ITNA_Extruded_9
User Library-ITNA_Extruded_10
