OLIMEX/KiCAD/KiCAD_Footprints/OLIMEX_3Dmodels/User_Library-Crystal_HC49_US-SM.step

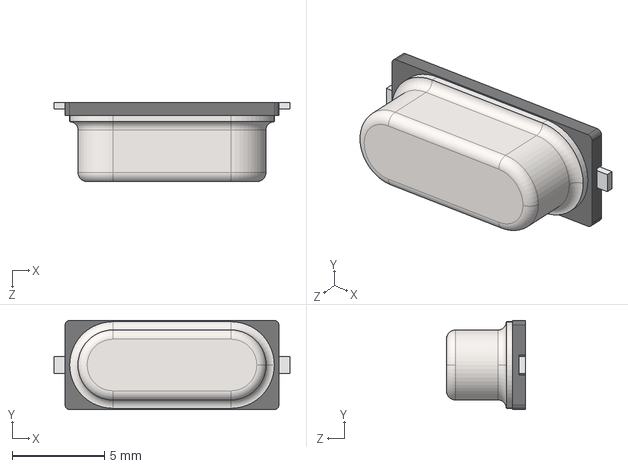
[picture p124: CAD file, 2019-03-28]
KiCAD_Footprints/OLIMEX_3Dmodels/User_Library-Crystal_HC49_US-SM.step
12.8 x 4.83 x 4.30 mm
