OLIMEX/KiCAD/KiCAD_Footprints/OLIMEX_3Dmodels/HN1x9-PinHeader_1x09_P2.54mm_Vertical.step

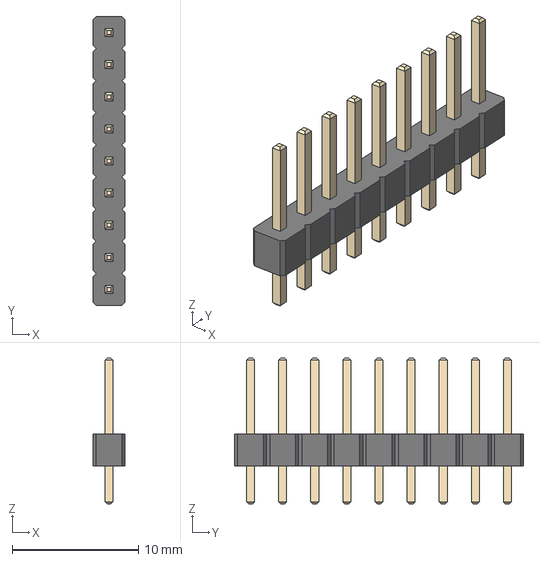
[picture p125: CAD file, 2019-03-28]
KiCAD_Footprints/OLIMEX_3Dmodels/HN1x9-PinHeader_1x09_P2.54mm_Vertical.step
2.54 x 22.9 x 11.5 mm
