OLIMEX/KiCAD/KiCAD_Footprints/OLIMEX_3Dmodels/uSD-DM1AA-SF-PEJ.step

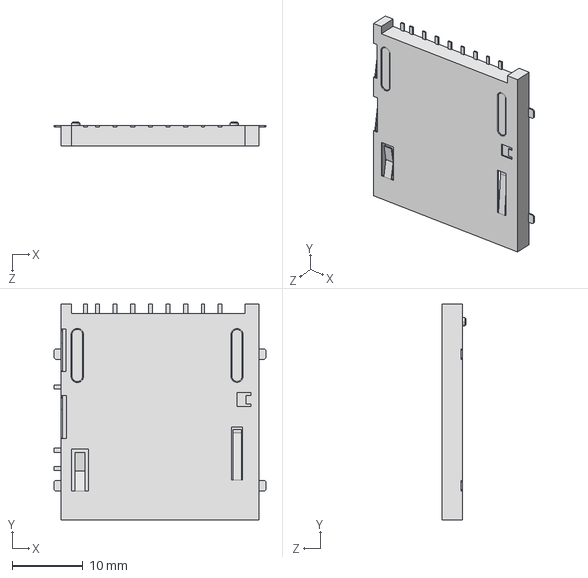
[picture p126: CAD file, 2019-03-28]
KiCAD_Footprints/OLIMEX_3Dmodels/uSD-DM1AA-SF-PEJ.step
30.0 x 30.5 x 3.45 mm
