OLIMEX/KiCAD/KiCAD_Footprints/OLIMEX_3Dmodels/HN1x15-PinHeader_1x15_P2.54mm_Vertical.step

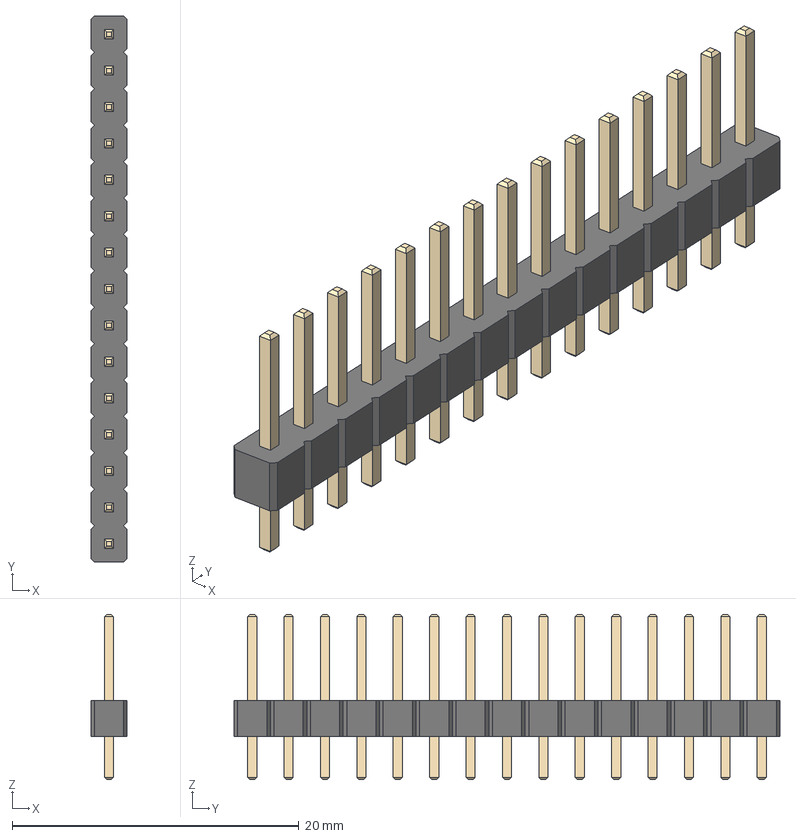
[picture p127: CAD file, 2019-03-28]
KiCAD_Footprints/OLIMEX_3Dmodels/HN1x15-PinHeader_1x15_P2.54mm_Vertical.step
2.54 x 38.1 x 11.5 mm
