OLIMEX/KiCAD/KiCAD_Footprints/OLIMEX_3Dmodels/HN1x17-PinHeader_1x17_P2.54mm_Vertical.step

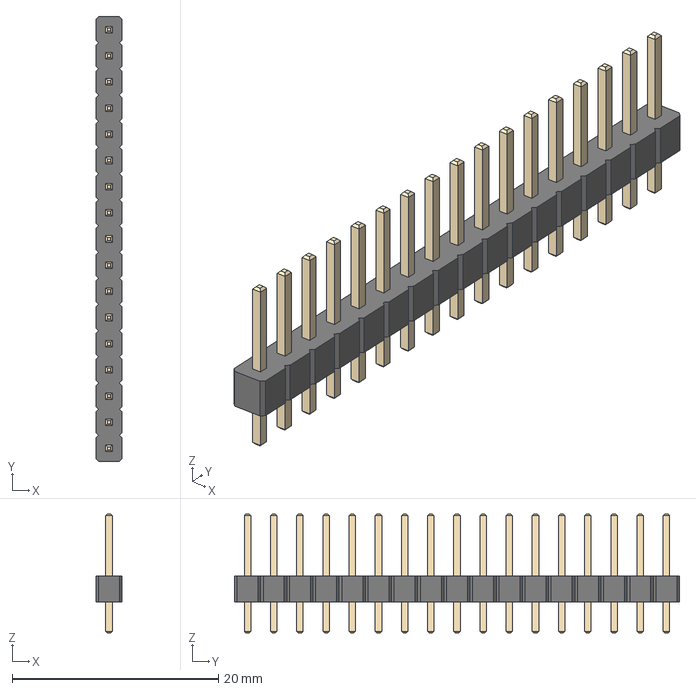
[picture p128: CAD file, 2019-03-28]
KiCAD_Footprints/OLIMEX_3Dmodels/HN1x17-PinHeader_1x17_P2.54mm_Vertical.step
2.54 x 43.2 x 11.5 mm
