OLIMEX/KiCAD/KiCAD_Footprints/OLIMEX_3Dmodels/Header_Fem_1X4.step

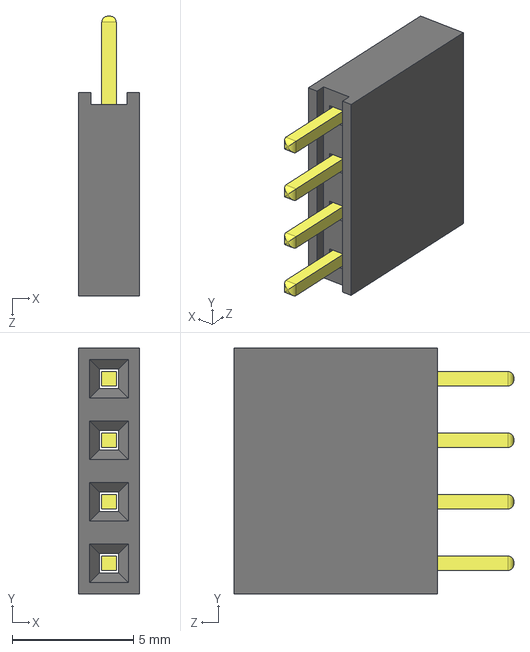
[picture p129: CAD file, 2019-03-28]
KiCAD_Footprints/OLIMEX_3Dmodels/Header_Fem_1X4.step
2.50 x 10.2 x 11.6 mm
