OLIMEX/KiCAD/KiCAD_Footprints/OLIMEX_3Dmodels/BATTHOLDERBK-5058.step

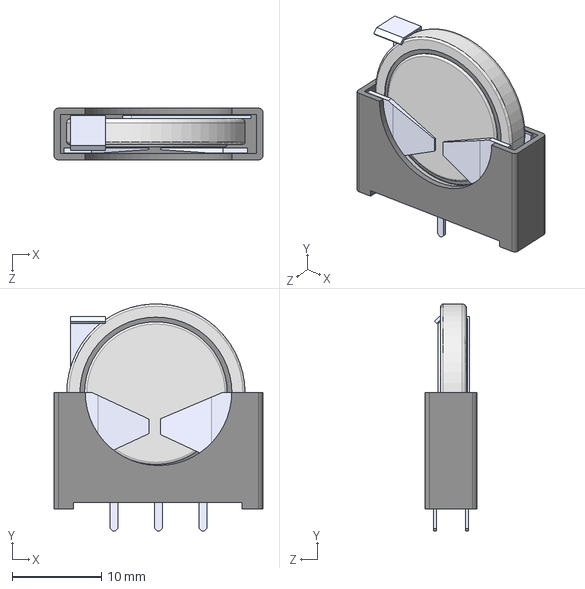
[picture p130: CAD file, 2019-03-28]
KiCAD_Footprints/OLIMEX_3Dmodels/BATTHOLDERBK-5058.step
23.4 x 25.4 x 5.80 mm
