OLIMEX/KiCAD/KiCAD_Footprints/OLIMEX_3Dmodels/JST_B2B-PH-SM4-TB(DW02R).step

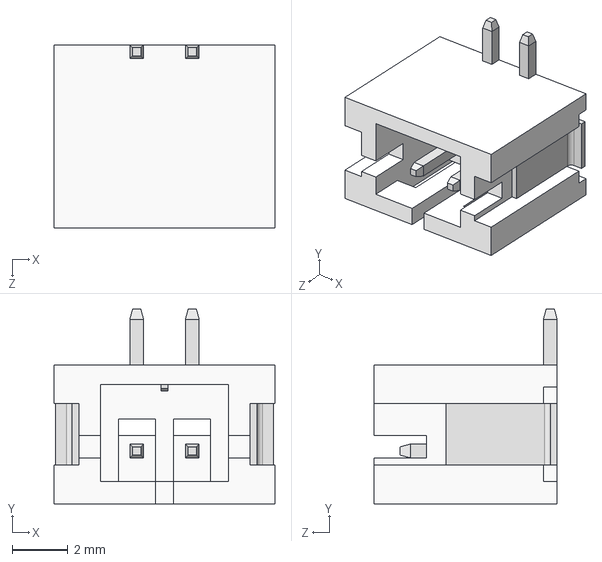
[picture p131: CAD file, 2019-03-28]
KiCAD_Footprints/OLIMEX_3Dmodels/JST_B2B-PH-SM4-TB(DW02R).step
7.95 x 7.00 x 6.60 mm
