OLIMEX/KiCAD/KiCAD_Footprints/OLIMEX_3Dmodels/BAT_1xAA_HOLDER.step

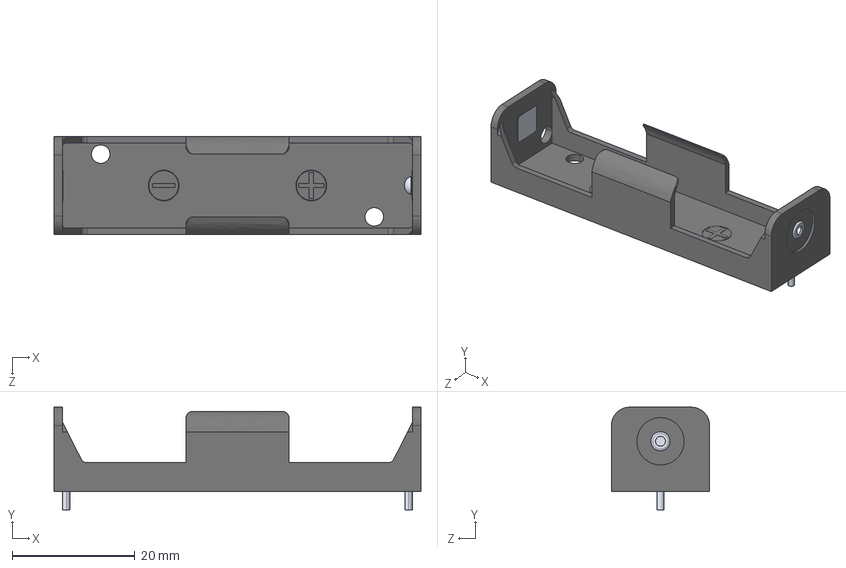
[picture p132: CAD file, 2019-03-28]
KiCAD_Footprints/OLIMEX_3Dmodels/BAT_1xAA_HOLDER.step
59.7 x 16.7 x 16.0 mm
