OLIMEX/KiCAD/KiCAD_Footprints/OLIMEX_3Dmodels/WU13S-Molex_PicoBlade_530471310_1x13_P1.25mm_Vertical.step

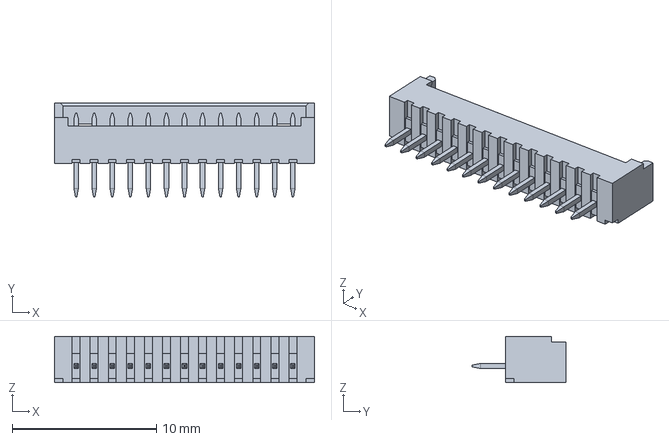
[picture p133: CAD file, 2019-03-28]
KiCAD_Footprints/OLIMEX_3Dmodels/WU13S-Molex_PicoBlade_530471310_1x13_P1.25mm_Vertical.step
18.0 x 6.50 x 3.20 mm
