OLIMEX/KiCAD/KiCAD_Footprints/OLIMEX_3Dmodels/SW3dPS-QFN-28.STEP

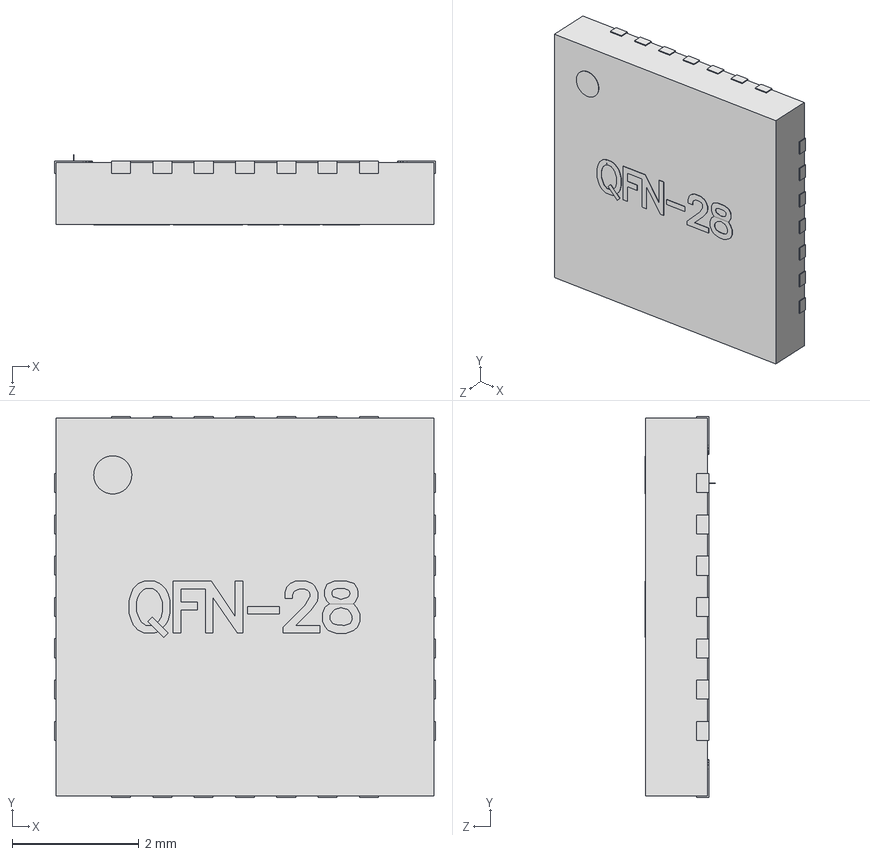
[picture p134: CAD file, 2019-03-28]
KiCAD_Footprints/OLIMEX_3Dmodels/SW3dPS-QFN-28.STEP
6.00 x 6.00 x 1.11 mm
SW3dPS-QFN-28_Board1
SW3dPS-QFN-28_Extruded22 x 7
SW3dPS-QFN-28_Cylinder1
SW3dPS-QFN-28_Extruded25 x 7
SW3dPS-QFN-28_Extruded20
SW3dPS-QFN-28_Extruded14 x 7
SW3dPS-QFN-28_Extruded24
SW3dPS-QFN-28_Extruded16
SW3dPS-QFN-28_Extruded19
SW3dPS-QFN-28_Extruded17
SW3dPS-QFN-28_Extruded21 x 7
SW3dPS-QFN-28_Extruded23
SW3dPS-QFN-28_Extruded13
SW3dPS-QFN-28_Extruded18
SW3dPS-QFN-28_Extruded15
