OLIMEX/KiCAD/KiCAD_Footprints/OLIMEX_3Dmodels/S3B-XH-SM4-TB.step

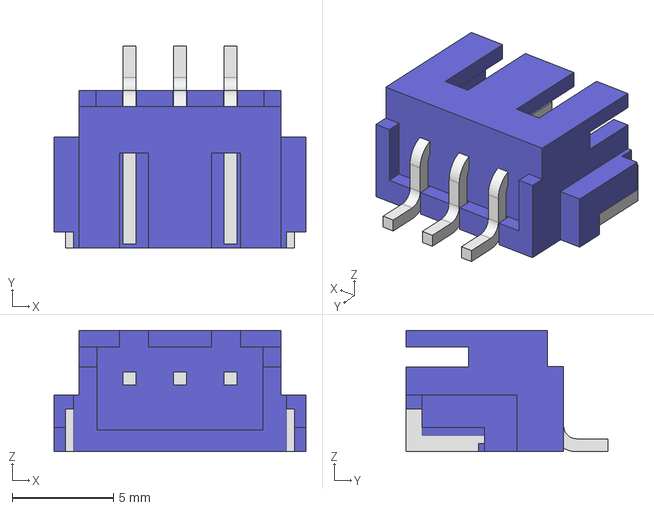
[picture p135: CAD file, 2019-03-28]
KiCAD_Footprints/OLIMEX_3Dmodels/S3B-XH-SM4-TB.step
12.4 x 10.0 x 6.00 mm
