OLIMEX/KiCAD/KiCAD_Footprints/OLIMEX_3Dmodels/usb_micro_4p.stp

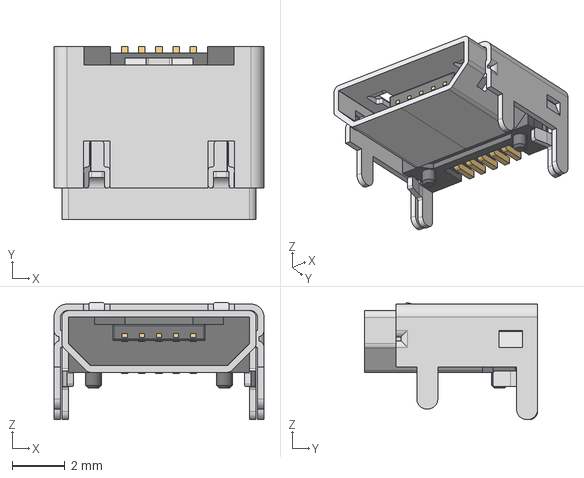
[picture p136: CAD file, 2019-03-28]
KiCAD_Footprints/OLIMEX_3Dmodels/usb_micro_4p.stp
8.00 x 6.60 x 4.46 mm
