OLIMEX/KiCAD/KiCAD_Footprints/OLIMEX_3Dmodels/SOT-23.step

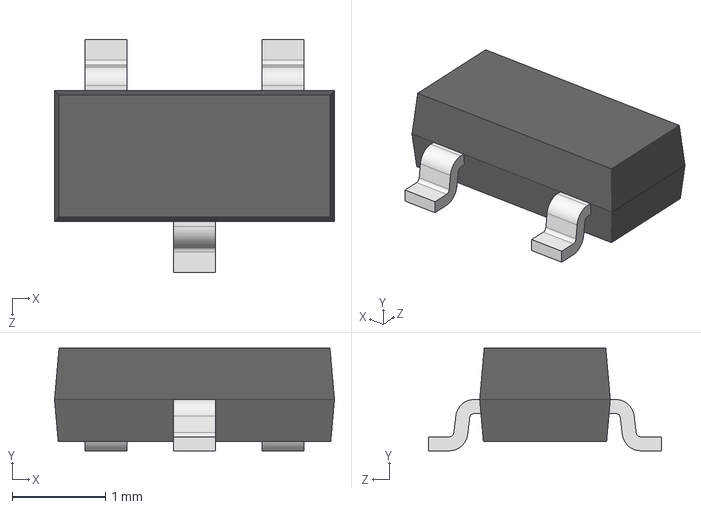
[picture p137: CAD file, 2019-03-28]
KiCAD_Footprints/OLIMEX_3Dmodels/SOT-23.step
3.00 x 1.10 x 2.50 mm
