OLIMEX/KiCAD/KiCAD_Footprints/OLIMEX_3Dmodels/HN1x19-PinHeader_1x19_P2.54mm_Vertical.step

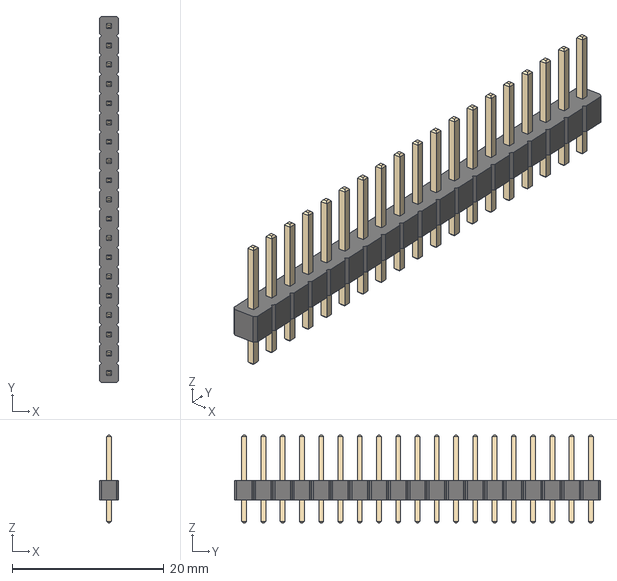
[picture p138: CAD file, 2019-03-28]
KiCAD_Footprints/OLIMEX_3Dmodels/HN1x19-PinHeader_1x19_P2.54mm_Vertical.step
2.54 x 48.3 x 11.5 mm
