OLIMEX/KiCAD/KiCAD_Footprints/OLIMEX_3Dmodels/PN1x8-Molex_C-Grid_901471108_1x08_P2.54mm_Vertical.step

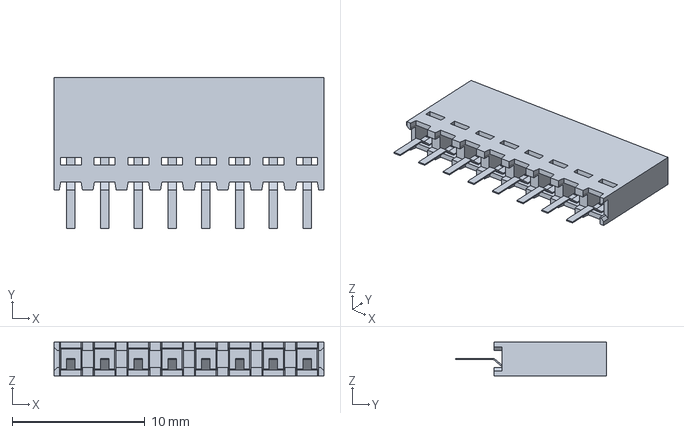
[picture p139: CAD file, 2019-03-28]
KiCAD_Footprints/OLIMEX_3Dmodels/PN1x8-Molex_C-Grid_901471108_1x08_P2.54mm_Vertical.step
20.3 x 11.4 x 2.54 mm
