OLIMEX/KiCAD/KiCAD_Footprints/OLIMEX_3Dmodels/User_Library-ws2812B-1.step

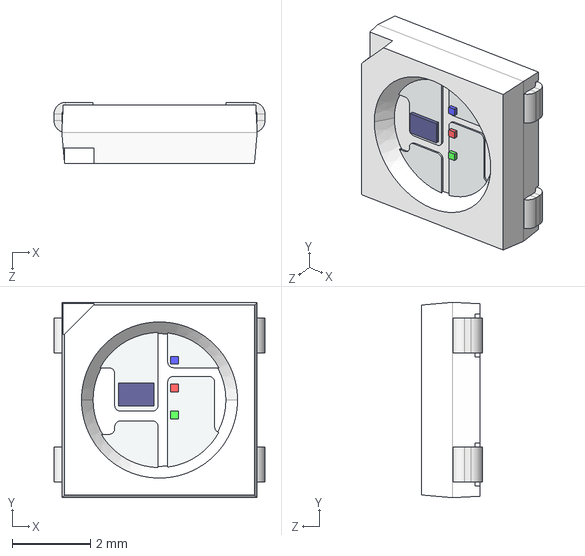
[picture p140: CAD file, 2019-03-28]
KiCAD_Footprints/OLIMEX_3Dmodels/User_Library-ws2812B-1.step
5.40 x 5.00 x 1.57 mm
