OLIMEX/KiCAD/KiCAD_Footprints/OLIMEX_3Dmodels/GBH2x5.stp

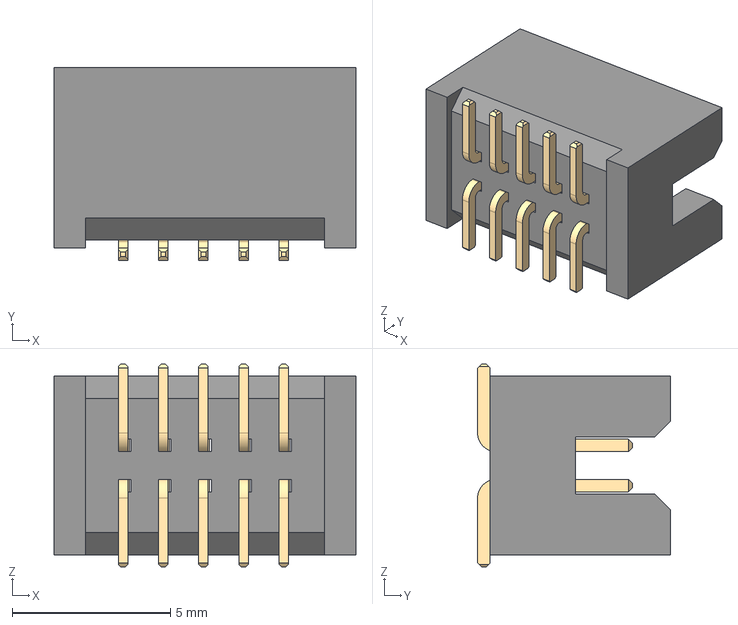
[picture p141: CAD file, 2019-03-28]
KiCAD_Footprints/OLIMEX_3Dmodels/GBH2x5.stp
9.55 x 6.10 x 6.40 mm
