OLIMEX/KiCAD/KiCAD_Footprints/OLIMEX_3Dmodels/B2B-XH-A.step

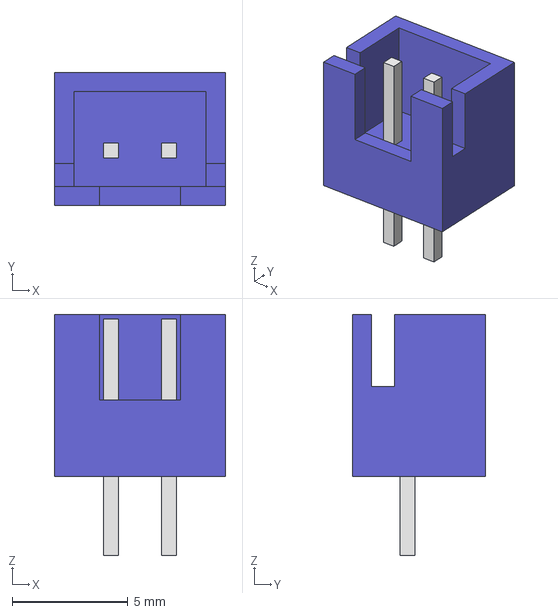
[picture p142: CAD file, 2019-03-28]
KiCAD_Footprints/OLIMEX_3Dmodels/B2B-XH-A.step
7.40 x 5.75 x 10.4 mm
