OLIMEX/KiCAD/KiCAD_Footprints/OLIMEX_3Dmodels/WU08S-Molex_PicoBlade_530470810_1x08_P1.25mm_Vertical.step

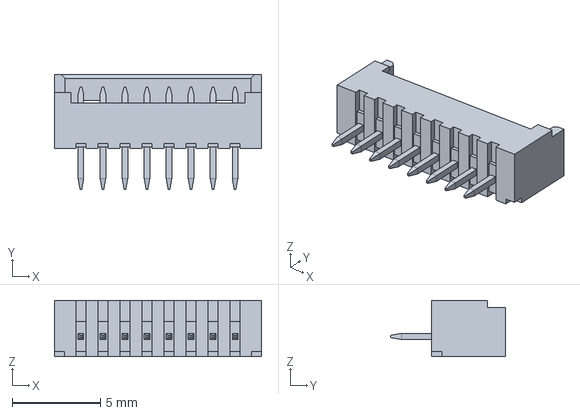
[picture p143: CAD file, 2019-03-28]
KiCAD_Footprints/OLIMEX_3Dmodels/WU08S-Molex_PicoBlade_530470810_1x08_P1.25mm_Vertical.step
11.8 x 6.50 x 3.20 mm
