OLIMEX/KiCAD/KiCAD_Footprints/OLIMEX_3Dmodels/Header_right_angle_10way(2x5).step

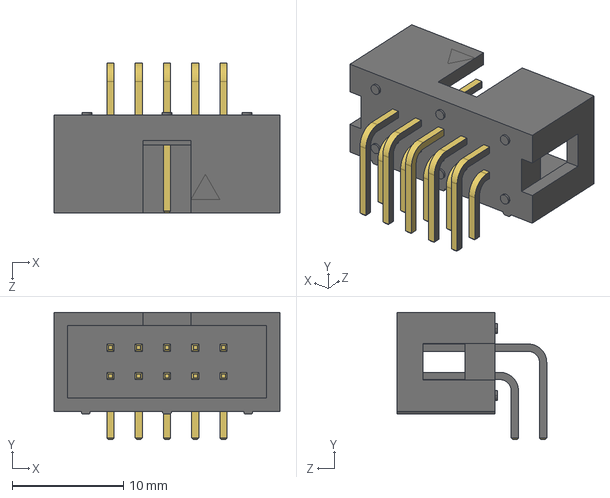
[picture p144: CAD file, 2019-03-28]
KiCAD_Footprints/OLIMEX_3Dmodels/Header_right_angle_10way(2x5).step
20.3 x 11.4 x 13.4 mm
