OLIMEX/KiCAD/KiCAD_Footprints/OLIMEX_3Dmodels/QSG5032.step

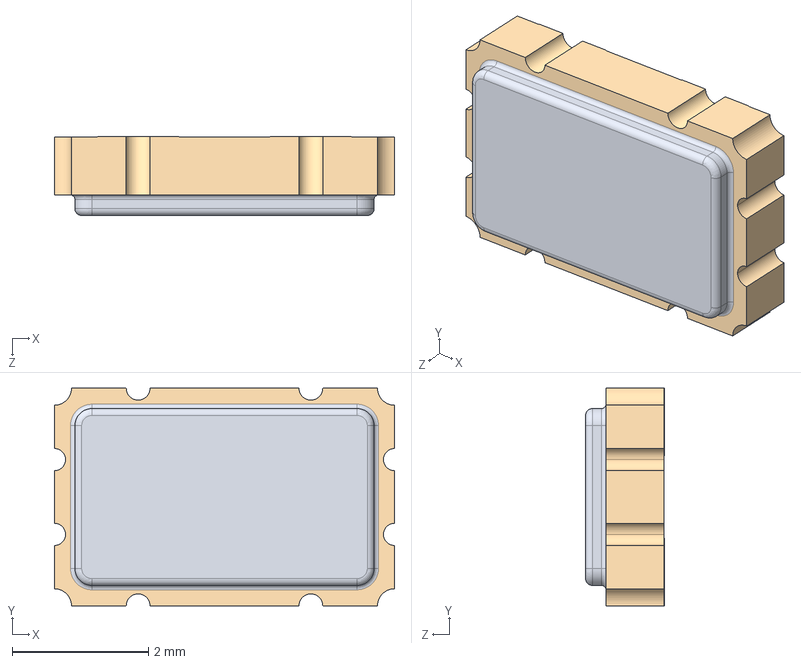
[picture p145: CAD file, 2019-03-28]
KiCAD_Footprints/OLIMEX_3Dmodels/QSG5032.step
5.00 x 3.20 x 1.16 mm
