OLIMEX/KiCAD/KiCAD_Footprints/OLIMEX_3Dmodels/HN1x1-PinHeader_1x01_P2.54mm_Vertical.step

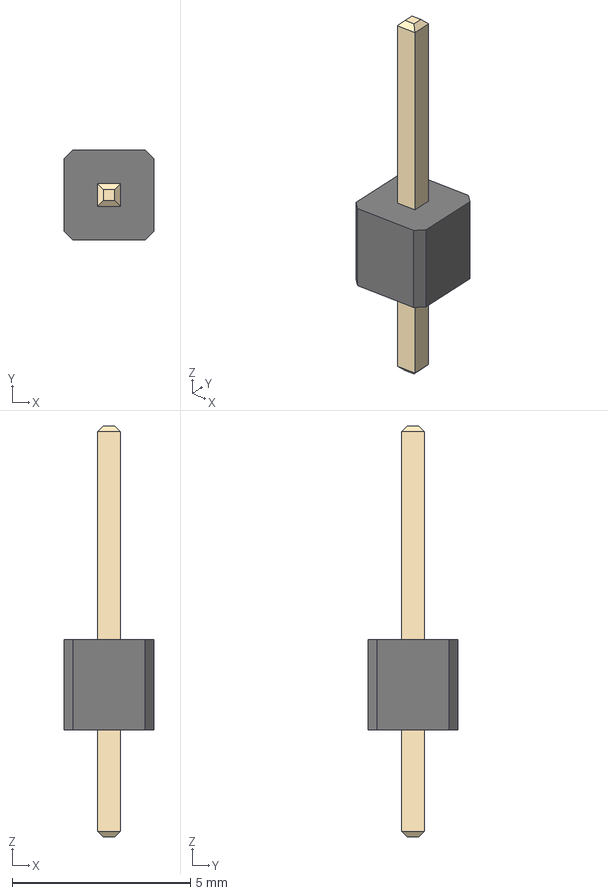
[picture p146: CAD file, 2019-03-28]
KiCAD_Footprints/OLIMEX_3Dmodels/HN1x1-PinHeader_1x01_P2.54mm_Vertical.step
2.54 x 2.54 x 11.5 mm
