OLIMEX/KiCAD/KiCAD_Footprints/OLIMEX_3Dmodels/WU02S-Molex_PicoBlade_530470210_1x02_P1.25mm_Vertical.step

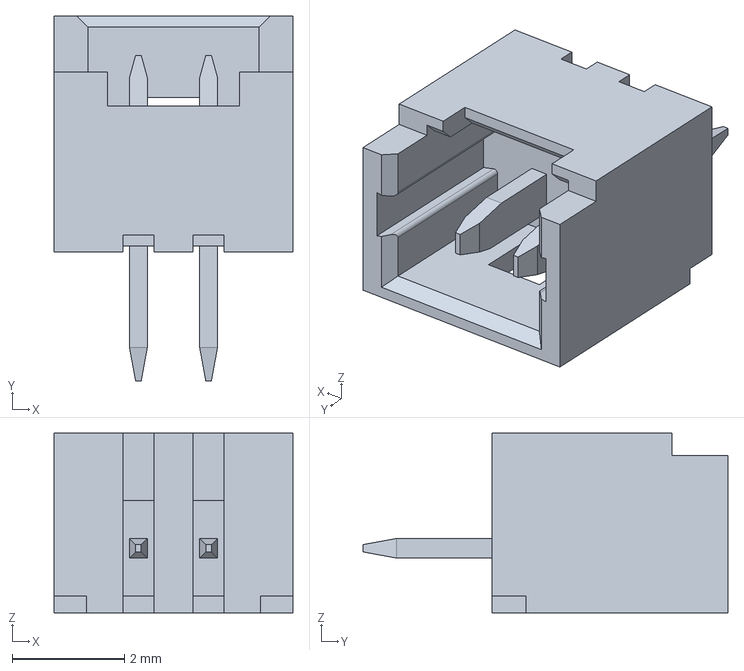
[picture p147: CAD file, 2019-03-28]
KiCAD_Footprints/OLIMEX_3Dmodels/WU02S-Molex_PicoBlade_530470210_1x02_P1.25mm_Vertical.step
4.25 x 6.50 x 3.20 mm
