OLIMEX/KiCAD/KiCAD_Footprints/OLIMEX_3Dmodels/RF_Shield.STEP

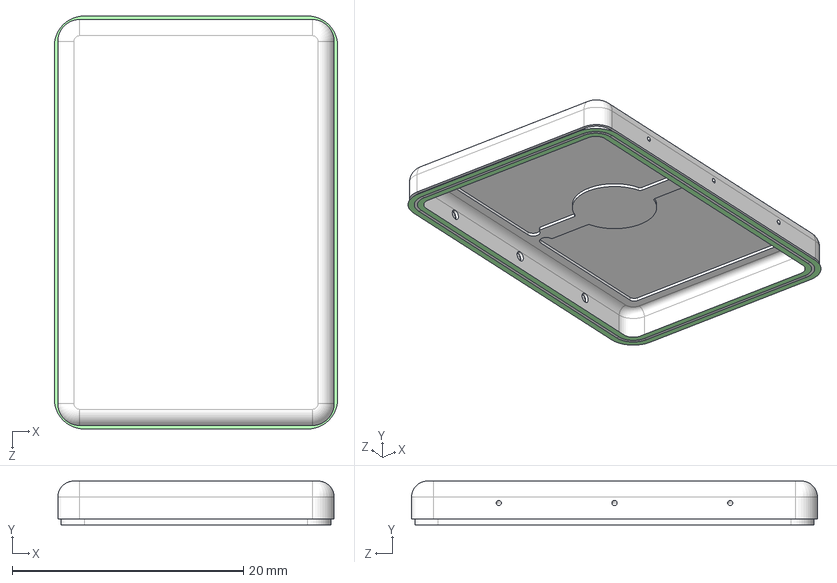
[picture p148: CAD file, 2019-03-28]
KiCAD_Footprints/OLIMEX_3Dmodels/RF_Shield.STEP
24.5 x 3.80 x 35.7 mm
Masach Technologies-MS345-10_MS345-10F
Masach Technologies-MS345-10_MS345-10C
Masach Technologies-MS345-10_MS345-10_Foot-Print
