OLIMEX/KiCAD/KiCAD_Footprints/OLIMEX_3Dmodels/HR1x2-PinHeader_1x02_P2.54mm_Horizontal.step

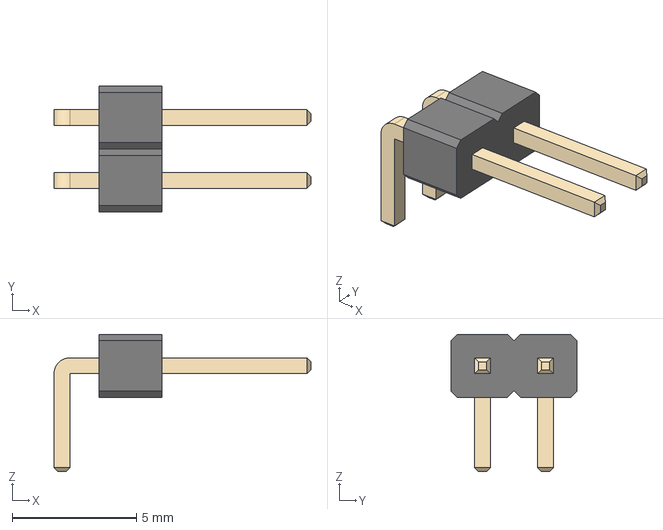
[picture p149: CAD file, 2019-03-28]
KiCAD_Footprints/OLIMEX_3Dmodels/HR1x2-PinHeader_1x02_P2.54mm_Horizontal.step
10.4 x 5.08 x 5.54 mm
