OLIMEX/KiCAD/(list of files, cad)

Other CAD files:
KiCAD_Footprints/OLIMEX_3Dmodels/Molex_PicoBlade_530470310.step
KiCAD_Footprints/OLIMEX_3Dmodels/1-281740-2.stp
KiCAD_Footprints/OLIMEX_3Dmodels/10118194.step
KiCAD_Footprints/OLIMEX_3Dmodels/687112183722.stp
KiCAD_Footprints/OLIMEX_3Dmodels/687120183722.stp
KiCAD_Footprints/OLIMEX_3Dmodels/78253MVC_SMD.STEP
KiCAD_Footprints/OLIMEX_3Dmodels/ABS07L.step
KiCAD_Footprints/OLIMEX_3Dmodels/B4B-XH-A.step
KiCAD_Footprints/OLIMEX_3Dmodels/BAT54.step
KiCAD_Footprints/OLIMEX_3Dmodels/BATLI3V_vert.step
KiCAD_Footprints/OLIMEX_3Dmodels/BGA100P14X14-176.step
KiCAD_Footprints/OLIMEX_3Dmodels/BH-10__64.step
KiCAD_Footprints/OLIMEX_3Dmodels/BH-14__64.step
KiCAD_Footprints/OLIMEX_3Dmodels/BH-20__64.step
KiCAD_Footprints/OLIMEX_3Dmodels/BH-40__64.step
KiCAD_Footprints/OLIMEX_3Dmodels/BM02B-SRSS-TB.step
KiCAD_Footprints/OLIMEX_3Dmodels/BM05B-SRSS-TB.step
KiCAD_Footprints/OLIMEX_3Dmodels/BM07B-SRSS-TB.step
KiCAD_Footprints/OLIMEX_3Dmodels/Bosch_BME280.step
KiCAD_Footprints/OLIMEX_3Dmodels/CD32_inductor.step
KiCAD_Footprints/OLIMEX_3Dmodels/CSPBGA_49_5X5_0,65.step
KiCAD_Footprints/OLIMEX_3Dmodels/Cap_8x11_5x3_5mm.step
KiCAD_Footprints/OLIMEX_3Dmodels/Cap_PTH_6_3x11x2_5mm.step
KiCAD_Footprints/OLIMEX_3Dmodels/Connector_1Port_RJ45_Magjack_10-100Base-T_AutoMDIX_PoE_Wurth_Electronics-7499211002A_DigiKey-732-4976-ND.step
KiCAD_Footprints/OLIMEX_3Dmodels/DFN-6-1.step
KiCAD_Footprints/OLIMEX_3Dmodels/DIP4.step
KiCAD_Footprints/OLIMEX_3Dmodels/DIP4_opto_iso.step
KiCAD_Footprints/OLIMEX_3Dmodels/DO-214AA_SMB.step
KiCAD_Footprints/OLIMEX_3Dmodels/ESP32-WROOM-32D-56544.STEP
KiCAD_Footprints/OLIMEX_3Dmodels/ESP32-WROVER-I-56544.STEP
KiCAD_Footprints/OLIMEX_3Dmodels/HN1x10-PinHeader_1x10_P2.54mm_Vertical.step
KiCAD_Footprints/OLIMEX_3Dmodels/HN1x12-PinHeader_1x12_P2.54mm_Vertical.step
KiCAD_Footprints/OLIMEX_3Dmodels/HN1x13-PinHeader_1x13_P2.54mm_Vertical.step
KiCAD_Footprints/OLIMEX_3Dmodels/HN1x16-PinHeader_1x16_P2.54mm_Vertical.step
KiCAD_Footprints/OLIMEX_3Dmodels/HN1x18-PinHeader_1x18_P2.54mm_Vertical.step
KiCAD_Footprints/OLIMEX_3Dmodels/HN1x20-PinHeader_1x20_P2.54mm_Vertical.step
KiCAD_Footprints/OLIMEX_3Dmodels/HN1x3.step
KiCAD_Footprints/OLIMEX_3Dmodels/HN1x30-PinHeader_1x30_P2.54mm_Vertical.step
KiCAD_Footprints/OLIMEX_3Dmodels/HN1x4-PinHeader_1x04_P2.54mm_Vertical.step
KiCAD_Footprints/OLIMEX_3Dmodels/HN1x40-PinHeader_1x40_P2.54mm_Vertical.step
KiCAD_Footprints/OLIMEX_3Dmodels/HN1x5-PinHeader_1x05_P2.54mm_Vertical.step
KiCAD_Footprints/OLIMEX_3Dmodels/HN1x6-PinHeader_1x06_P2.54mm_Vertical.step
KiCAD_Footprints/OLIMEX_3Dmodels/HN1x7-PinHeader_1x07_P2.54mm_Vertical.step
KiCAD_Footprints/OLIMEX_3Dmodels/HN2x12.STEP
KiCAD_Footprints/OLIMEX_3Dmodels/HR1x4-PinHeader_1x04_P2.54mm_Horizontal.step
KiCAD_Footprints/OLIMEX_3Dmodels/HR1x5-PinHeader_1x05_P2.54mm_Horizontal.step
KiCAD_Footprints/OLIMEX_3Dmodels/HR1x6-PinHeader_1x06_P2.54mm_Horizontal.step
KiCAD_Footprints/OLIMEX_3Dmodels/Header_Fem_1X6.step
KiCAD_Footprints/OLIMEX_3Dmodels/JS-PS2.step
KiCAD_Footprints/OLIMEX_3Dmodels/JUMPER.step
KiCAD_Footprints/OLIMEX_3Dmodels/LED_0603_B.step
KiCAD_Footprints/OLIMEX_3Dmodels/LED_0603_G.step
KiCAD_Footprints/OLIMEX_3Dmodels/LED_0603_R.step
KiCAD_Footprints/OLIMEX_3Dmodels/LGA-16.step
KiCAD_Footprints/OLIMEX_3Dmodels/LQFP-64.step
KiCAD_Footprints/OLIMEX_3Dmodels/L_AX97-103R3.step
KiCAD_Footprints/OLIMEX_3Dmodels/L_SD75.step
KiCAD_Footprints/OLIMEX_3Dmodels/Laird-BMI-S-101.STEP
KiCAD_Footprints/OLIMEX_3Dmodels/MLX90614.step
KiCAD_Footprints/OLIMEX_3Dmodels/MSOP10-1.step
KiCAD_Footprints/OLIMEX_3Dmodels/MicroSMP.step
KiCAD_Footprints/OLIMEX_3Dmodels/Molex_PicoBlade_530470210.step
KiCAD_Footprints/OLIMEX_3Dmodels/Molex_PicoBlade_530470710.step
KiCAD_Footprints/OLIMEX_3Dmodels/PN1x11-Molex_C-Grid_901471111_1x11_P2.54mm_Vertical.step
KiCAD_Footprints/OLIMEX_3Dmodels/PN1x12-Molex_C-Grid_901471112_1x12_P2.54mm_Vertical.step
KiCAD_Footprints/OLIMEX_3Dmodels/PN1x15-Molex_C-Grid_901471115_1x15_P2.54mm_Vertical.step
KiCAD_Footprints/OLIMEX_3Dmodels/PN1x18-Molex_C-Grid_901471118_1x18_P2.54mm_Vertical.step
KiCAD_Footprints/OLIMEX_3Dmodels/PN1x2-Molex_C-Grid_901471102_1x02_P2.54mm_Vertical.step
KiCAD_Footprints/OLIMEX_3Dmodels/PN1x30-Molex_C-Grid_901471130_1x30_P2.54mm_Vertical.step
KiCAD_Footprints/OLIMEX_3Dmodels/PN1x32-Molex_C-Grid_901471132_1x32_P2.54mm_Vertical.step
KiCAD_Footprints/OLIMEX_3Dmodels/PN1x4-Molex_C-Grid_901471104_1x04_P2.54mm_Vertical.step
KiCAD_Footprints/OLIMEX_3Dmodels/PN1x5-Molex_C-Grid_901471105_1x05_P2.54mm_Vertical.step
KiCAD_Footprints/OLIMEX_3Dmodels/PN1x6-Molex_C-Grid_901471106_1x06_P2.54mm_Vertical.step
KiCAD_Footprints/OLIMEX_3Dmodels/PN1x9-Molex_C-Grid_901471109_1x09_P2.54mm_Vertical.step
KiCAD_Footprints/OLIMEX_3Dmodels/PN2x8.stp
KiCAD_Footprints/OLIMEX_3Dmodels/PTS645.step
KiCAD_Footprints/OLIMEX_3Dmodels/PVQFN-N24.step
KiCAD_Footprints/OLIMEX_3Dmodels/Pin_Header_Straight_2x05_1.27mm.step
KiCAD_Footprints/OLIMEX_3Dmodels/QFN-20_5x5x0_9mm.step
KiCAD_Footprints/OLIMEX_3Dmodels/QFN28-0_4.STEP
KiCAD_Footprints/OLIMEX_3Dmodels/QFN32_5x5.step
KiCAD_Footprints/OLIMEX_3Dmodels/QFN48-0.5.STEP
KiCAD_Footprints/OLIMEX_3Dmodels/QFN48_6x6.step
KiCAD_Footprints/OLIMEX_3Dmodels/QFN56_0_4.step
KiCAD_Footprints/OLIMEX_3Dmodels/REDLED.step
KiCAD_Footprints/OLIMEX_3Dmodels/RJ45_GB_LEDS.stp
KiCAD_Footprints/OLIMEX_3Dmodels/RN2483.step
KiCAD_Footprints/OLIMEX_3Dmodels/R_0.125W_PTH-R_Axial_DIN0204_L3.6mm_D1.6mm_P5.08mm_Horizontal.step
KiCAD_Footprints/OLIMEX_3Dmodels/S4B-XH-SM4-TB.step
KiCAD_Footprints/OLIMEX_3Dmodels/SC70-6.step
KiCAD_Footprints/OLIMEX_3Dmodels/SIP-7.step
KiCAD_Footprints/OLIMEX_3Dmodels/SL14.step
KiCAD_Footprints/OLIMEX_3Dmodels/SL16.step
KiCAD_Footprints/OLIMEX_3Dmodels/SLP2510P8.step
KiCAD_Footprints/OLIMEX_3Dmodels/SMD075F.step
KiCAD_Footprints/OLIMEX_3Dmodels/SMD5032.STEP
KiCAD_Footprints/OLIMEX_3Dmodels/SMD_Ceramic_Capacitors_1808(4520).step
KiCAD_Footprints/OLIMEX_3Dmodels/SOD123.step
KiCAD_Footprints/OLIMEX_3Dmodels/SOIC28-300.step
KiCAD_Footprints/OLIMEX_3Dmodels/SOIC_20-300.STEP
KiCAD_Footprints/OLIMEX_3Dmodels/SOT-223-2.STEP
KiCAD_Footprints/OLIMEX_3Dmodels/SOT-223-6.step
KiCAD_Footprints/OLIMEX_3Dmodels/SOT-23-5.step
KiCAD_Footprints/OLIMEX_3Dmodels/SOT-23-6.step
KiCAD_Footprints/OLIMEX_3Dmodels/SOT223-5.step
KiCAD_Footprints/OLIMEX_3Dmodels/SOT89-5.step
KiCAD_Footprints/OLIMEX_3Dmodels/SSOP-20_4.4x6.5mm_P0.65mm.step
KiCAD_Footprints/OLIMEX_3Dmodels/SSOP-20_5.3x7.2mm_P0.65mm.step
KiCAD_Footprints/OLIMEX_3Dmodels/TB2.STEP
KiCAD_Footprints/OLIMEX_3Dmodels/UE27AC54100.step
KiCAD_Footprints/OLIMEX_3Dmodels/UEXT-SMD.STEP
KiCAD_Footprints/OLIMEX_3Dmodels/U_FL-R-SMT-1.step
KiCAD_Footprints/OLIMEX_3Dmodels/User Library-BU2032SM-HD-G(CR2032 Battery Holder).SLDPRT
KiCAD_Footprints/OLIMEX_3Dmodels/User_Library-LED_Matrix.STEP
KiCAD_Footprints/OLIMEX_3Dmodels/User_Library-PS3_THUMBSTICK.STEP
KiCAD_Footprints/OLIMEX_3Dmodels/User_Library-Parallax-IR.step
KiCAD_Footprints/OLIMEX_3Dmodels/User_Library-Photoresistor.step
KiCAD_Footprints/OLIMEX_3Dmodels/User_Library-Pushbutton3x4x2.step
KiCAD_Footprints/OLIMEX_3Dmodels/User_Library-RAPC722_Power_Jack.step
KiCAD_Footprints/OLIMEX_3Dmodels/User_Library-ps2_analog.STEP
KiCAD_Footprints/OLIMEX_3Dmodels/User_Library-usb_port_ch.STEP
KiCAD_Footprints/OLIMEX_3Dmodels/VLP6045T.step
KiCAD_Footprints/OLIMEX_3Dmodels/VSSOP8-0.5.STEP
KiCAD_Footprints/OLIMEX_3Dmodels/VX3-Quartz-Oscillator.step
KiCAD_Footprints/OLIMEX_3Dmodels/WF6S(CI3103P1V00)-Molex_KK-254_AE-6410-06A_1x06_P2.54mm_Vertical.step
KiCAD_Footprints/OLIMEX_3Dmodels/WU04S-Molex_PicoBlade_530470410_1x04_P1.25mm_Vertical.step
KiCAD_Footprints/OLIMEX_3Dmodels/WU05S-Molex_PicoBlade_530470510_1x05_P1.25mm_Vertical.step
KiCAD_Footprints/OLIMEX_3Dmodels/WU07S-Molex_PicoBlade_530470710_1x07_P1.25mm_Vertical.step
KiCAD_Footprints/OLIMEX_3Dmodels/WU09S-Molex_PicoBlade_530470910_1x09_P1.25mm_Vertical.step
KiCAD_Footprints/OLIMEX_3Dmodels/WU10S-Molex_PicoBlade_530471010_1x10_P1.25mm_Vertical.step
KiCAD_Footprints/OLIMEX_3Dmodels/WU11S-Molex_PicoBlade_530471110_1x11_P1.25mm_Vertical.step
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
