OLIMEX/KiCAD/(commit log)

2018-04-30 Update
    Latest components and footprints updated; previous ones moved to
    Old/Release_2
2019-03-28 Update
    Updated latest libraries, edited text to reflect the 3D update
    [1-281740-2.stp, 10118194.step, 1871916-1.stp, 20-pin_SMT_header.STEP, 629105150521.stp, 687112183722.stp, 687120183722.stp, 693063020911.stp]
2025-05-28 Update
    Added latest KiCAD components and footprints, kicad 6 and 7
2026-10-12 Update
    Added newest additions and KiCAD 10 support
