OLIMEX/KiCAD/(notices)

Notices in the files:
KiCAD_Footprints/OLIMEX_3Dmodels/HN1x9-PinHeader_1x09_P2.54mm_Vertical.step:
Copyright (C) 2017, kicad StepUp
This work is licensed under the [Creative Commons CC-BY-SA 4.0 License](https://creativecommons.org/licenses/by-sa/4.0/legalcode),
with the following exception:
To the extent that the creation of electronic designs that use 'Licensed Material' can be considered to be 'Adapted Material',
You are free to use the library data in your own projects without the obligation to share your project files under this or any other license agreement.
KiCAD_Footprints/OLIMEX_3Dmodels/GBH254SMT-16(B-V-16-LF)(IDC-Header_2x08_P2.54mm_Vertical_SMD).step:
Copyright (C) 2022, kicad StepUp
This work is licensed under the
[Creative Commons CC-BY-SA 4.0 License](https://creativecommons.org/licenses/by-sa/4.0/legalcode),
project files under this or any other license agreement. However, if you wish to distribute
KiCAD_Footprints/OLIMEX_3Dmodels/PN1x16-PinSocket_1x16_P2.54mm_Vertical.step:
Copyright (C) 2017, Terje Io
This work is licensed under the Creative Commons CC-BY-SA 4.0 License with the following exception:
To the extent that the creation of electronic designs that use 'Licensed Material'
https://creativecommons.org/licenses/by-sa/4.0/legalcode
KiCAD_Footprints/OLIMEX_3Dmodels/FPC-15P-1mm-Right_Angle.step:
author */ ('License CC BY-ND 4.0'),
